RungeKut/thermocirculator/docs/01-overview.md

# 01. Обзор проекта

Актуально на 16.09.2026.

## Назначение

Термоциркулятор — прибор для длительного поддержания заданной температуры
водяной ванны с точностью, достаточной для лабораторного термостатирования и
приготовления по технологии sous-vide.

Функции:

- нагрев ТЭНом с ПИД-регулированием и программным ШИМ;
- принудительная циркуляция воды (мотор постоянного тока + мотор переменного тока);
- измерение температуры тремя NTC-термисторами (два в ванне, один на радиаторе);
- контроль уровня воды двумя поплавковыми датчиками с аварийным остановом;
- 16 сохраняемых программ «температура + время» в энергонезависимой памяти;
- интерфейс: LCD1602 с кириллицей, 5 кнопок, звуковая сигнализация, светодиод.

## Три целевых микроконтроллера

Проект ведётся одновременно под три чипа. Это не дублирование, а следствие
истории поставок — см. ниже.

| Таргет | Папка | Ядро | Библиотека | Состояние |
|---|---|---|---|---|
| STM32L072CBT6 | [`STM32L072CBT6/`](../STM32L072CBT6/) | Cortex-M0+ | STM32Cube HAL | **Эталон.** Логика полностью работает |
| STM32L071CBT6 | [`STM32L071CBT6/`](../STM32L071CBT6/) | Cortex-M0+ | STM32Cube HAL | Конфигурация восстановлена, собирается; проверка на железе не проводилась |
| GD32E103C8T6 | [`keil/`](../keil/) | Cortex-M3 | GigaDevice SPL | Ранняя стадия: поднята периферия, прикладной код отключён |

### Почему три

1. **STM32L072CBT6** — чип, на котором прибор был разработан и доведён до
   рабочего состояния. Остаётся эталоном поведения: при любых сомнениях
   «как должно работать» ответ ищется здесь.

2. **GD32E103C8T6** — попытка уйти от дефицита STM32 и одновременно резко
   снизить себестоимость изделия: эти чипы существенно дешевле. Порт делался
   в условиях скудной документации и оказался долгим. **Это не запасной
   вариант, а целевой чип для серийного изделия** — порт должен быть доведён
   до конца.

3. **STM32L071CBT6** — промежуточное решение, принятое когда чип появился в
   наличии. Архитектурно это тот же Cortex-M0+ и тот же HAL, что у L072.

**Три порта — не следствие разброда, а замысел.** Плата разрабатывалась под
pin-to-pin совместимые микроконтроллеры в LQFP48, и все три проверены пайкой
на неё. Исходники плат — в [`../hardware/`](../hardware/).

### Насколько таргеты различаются на самом деле

**L071 и L072 почти идентичны.** Набор драйверов HAL в
`Drivers/STM32L0xx_HAL_Driver/Src` у них совпадает побайтно. Папки `User/` и
`LCD1602/` тоже идентичны — и так и должно быть, это переносимый код.
Различие сводится к дефайну `STM32L071xx` вместо `STM32L072xx` и стартовому
файлу. L071 не имеет USB и аппаратного AES, но проект их не использует.

**GD32E103 — настоящий порт.** Cortex-M3 вместо M0+, тактовая до 72 МГц
вместо 32 МГц, собственная библиотека периферии вместо HAL, другая
организация АЦП (нет регистра `CHSELR`, вместо него регулярная и вставленная
группы), другая работа с флеш-памятью (страница 1 КБ вместо 128 байт) и
всего 64 КБ флеша против 128 КБ.

### Размер прошивки

| Таргет | ROM (Code + RO + RW) | Доступно | Запас |
|---|---|---|---|
| STM32L072CBT6 | 27.14 КБ | 128 КБ | ~79 % |
| STM32L071CBT6 | 27.01 КБ | 128 КБ | ~79 % |
| GD32E103C8T6 | 7.77 КБ (неполная) | 64 КБ | — |

Полная прошивка уверенно помещается в 64 КБ GD32E103C8T6.

## Текущее состояние работ

### Что работает

- Прошивка L072 — полнофункциональна, последняя успешная сборка 02.03.2025.
- Прошивка L071 — конфигурация периферии восстановлена 17.09.2026,
  собирается без ошибок (27 656 байт). **На железе не проверялась.**
- GD32: тактирование, GPIO, RTC на внешнем кварце 32.768 кГц, таймер в режиме
  ШИМ, собственная реализация `HAL_Delay`/`HAL_GetTick` поверх SysTick.

### Что сломано

1. ~~**Окружение сборки.**~~ Устранено 17.09.2026: компилятор, пакеты
   поддержки устройств, Java и CubeMX установлены. Оба ST-проекта
   собираются и дают эталонные размеры — [03-environment.md](03-environment.md).

2. ~~**L071 не измеряет температуру.**~~ Потерянная конфигурация АЦП, RTC и
   GPIO возвращена в `.ioc` и перегенерирована 17.09.2026 — П-02 в
   [07-troubleshooting.md](07-troubleshooting.md). Осталось **подтвердить на
   приборе**: температура должна перестать показывать ноль.

3. **GD32: прикладной код отключён.** Модули `user_interface.c`,
   `temperature_measurement.c`, `heater_control.c` и драйвер `LCD1602.c`
   закомментированы целиком. Не портированы: LCD, работа с флешем,
   измерение температуры, ПИД, звук.

## План работ

Порядок выбран так, чтобы не делать работу дважды.

1. ~~**Восстановить окружение**~~ — выполнено 17.09.2026.
2. **Оживить L071** — конфигурация возвращена; ждёт проверки на приборе.
3. **Выделить общую кодовую базу** `app/` + `port/` на эталонном L072.
   Обоснование — [adr/0002-shared-codebase.md](adr/0002-shared-codebase.md).
4. **Внести новое ТЗ** один раз в `app/` — получить сразу две прошивки.
   Состав работ — [09-requirements.md](09-requirements.md), архитектура
   интерфейса — [adr/0003-ui-architecture.md](adr/0003-ui-architecture.md).
5. **Доделать GD32** против уже стабилизированного `app/`.

Ключевое: шаг 3 идёт **до** шага 5. Если сначала доделать GD32 «как есть», а
потом выделять абстракцию, вся работа по GD32 будет переделана.

## Внешние ссылки

- Репозиторий: https://github.com/RungeKut/thermocirculator
- Документация на GD32: https://www.gd32mcu.com/
