RungeKut/thermocirculator/docs/README.md

# Документация проекта «Термоциркулятор»

Прибор для термостатирования водяной ванны: поддержание заданной температуры
ТЭНом с ПИД-регулированием, принудительная циркуляция, контроль уровня воды,
управление с LCD1602 и пятикнопочной клавиатуры.

Прошивка существует для **трёх микроконтроллеров** — см. [01-overview.md](01-overview.md).

## С чего начать

| Ваша задача | Документ |
|---|---|
| Понять, что это за прибор и в каком состоянии проект | [01-overview.md](01-overview.md) |
| Разобраться в схемотехнике и распиновке | [02-hardware.md](02-hardware.md) |
| Открыть схему, разводку, заказать платы | [../hardware/README.md](../hardware/README.md) |
| **Развернуть рабочее окружение с нуля** | [03-environment.md](03-environment.md) |
| Собрать и прошить | [04-build-and-flash.md](04-build-and-flash.md) |
| Понять логику прошивки | [05-firmware.md](05-firmware.md) |
| Портировать на новый МК | [06-porting.md](06-porting.md) |
| Что-то не работает | [07-troubleshooting.md](07-troubleshooting.md) |
| **Правила работы над проектом** | [08-rules.md](08-rules.md) |
| **Что предстоит сделать (новое ТЗ)** | [09-requirements.md](09-requirements.md) |

Принятые архитектурные решения и их обоснование — в [adr/](adr/).

Офлайн-комплект для развёртывания окружения — в [../tools/](../tools/).

## Статус документации

Документация описывает состояние проекта на **16.09.2026**. Актуальность
отдельных разделов помечена в каждом файле.

> **Важно:** документация — часть определения «готово». Изменение, не отражённое
> в документации, считается незавершённым. См. [08-rules.md](08-rules.md).
