RungeKut/thermocirculator/docs/02-hardware.md

# 02. Аппаратная часть

Актуально на 17.09.2026. Распиновка одинакова для всех трёх таргетов —
это осознанное решение, позволяющее держать общий прикладной код.

**Исходники плат — в [`../hardware/`](../hardware/).** Там же схема в PDF,
список доработок реальной платы относительно схемы и разбор узла обратной
связи источника питания. Прибор собран из двух плат, соединённых шлейфом:
системы управления и панели управления.

> **Плата рассчитана на три процессора.** Она разрабатывалась под
> pin-to-pin совместимые микроконтроллеры в LQFP48, и все три —
> GD32E103C8T6, STM32L072CBT6, STM32L071CBT6 — проверены пайкой на неё.
> В перечне элементов стоит GD32E103C8T6. Это и есть причина, по которой
> прошивка ведётся в трёх портах.

## Распиновка

Источник истины — `Core/Inc/main.h` соответствующего таргета. Таблица ниже
сверена с L072, L071 и GD32 — совпадает для всех трёх.

### Аналоговые входы (АЦП)

| Пин | Сигнал | Назначение |
|---|---|---|
| PA0 | `SENSE_TEMP_2` | NTC-термистор в ванне № 2 (разъём X7) |
| PA1 | `SENSE_TEMP_1` | NTC-термистор в ванне № 1 (разъём X8) |
| PA2 | `SENSE_TEMP_RADIATOR` | NTC-термистор радиатора |
| — | внутренний | Датчик температуры кристалла |
| — | внутренний | Опорное напряжение `VREFINT` |

> Внутренние каналы обязательны: `VREFINT` служит делителем при пересчёте
> всех остальных температур. Без него все измерения обращаются в ноль —
> именно так была сломана конфигурация L071 (устранено 17.09.2026, П-02).

### Дискретные входы

| Пин | Сигнал | Режим | Бит в `keys` / `levels` |
|---|---|---|---|
| PA3 | `WATER_LEVEL_HIGH` | вход | `levels` бит 1 (0x02) |
| PC13 | `WATER_LEVEL_LOW` | вход | `levels` бит 0 (0x01) |
| PA4 | `START_BUTTON` | вход | `keys` 0x02 |
| PA5 | `STOP_BUTTON` | вход | `keys` 0x04 |
| PA6 | `MENU_BUTTON` | вход | `keys` 0x08 |
| PA7 | `LEFT_BUTTON` | вход | `keys` 0x10 |
| PB0 | `RIGHT_BUTTON` | вход | `keys` 0x01 |

Состояние читается пачкой прямо из регистров:

```c
uint8_t GetKey(void){
    return ((GPIOA->IDR & 0x00F0) >> 3) + (GPIOB->IDR & 0x0001);
}
uint8_t GetLevel(void){
    return ((GPIOA->IDR & 0x0008) >> 2) + ((GPIOC->IDR & 0x2000) >> 13);
}
```

> **Расхождение Stop / Left — решено 17.09.2026: авторитетны имена пинов.**
> `main.h` верен: PA5 — это Stop, PA7 — это Left. Врут **комментарии** в
> обработчиках `ButtonClickExecuter()` и `ButtonClickHandler()`, где `0x04`
> подписан как Left, а `0x10` как Stop.
>
> Следствие, которое нужно проверить на приборе: раз `0x04` приходит с PA5
> (Stop), то нажатие Stop сейчас выполняет ветку уменьшения значения, а
> нажатие Left (`0x10`) — ветку останова. То есть **в текущей прошивке эти
> две кнопки функционально переставлены** относительно своих имён.
>
> Если на живом приборе Stop останавливает, а Left листает — значит
> физическая разводка кнопок на панели не совпадает с именами в `main.h`,
> и тогда переименовать нужно дефайны, а не править логику. **Проверить до
> переработки интерфейса:** после неё поведение будет следовать именам.

### Дискретные выходы

| Пин | Сигнал | Нагрузка |
|---|---|---|
| PB2 | `HEATER` | ТЭН (через силовой ключ), программный ШИМ |
| PB1 | `AC_MOTOR` | Мотор переменного тока (циркуляция) |
| PA9 | `DC_MOTOR` | Мотор постоянного тока (циркуляция) |
| PA8 | `COOLER` | Вентилятор радиатора |
| PB11 | `LED_R` | Индикатор «Капля» (авария по уровню воды) |
| PA10 | `BACKLIGHT` | Подсветка дисплея |
| PA15 | `SPEAKER` | Пьезоизлучатель PS1740P02E, ШИМ от таймера (см. ниже) |

### Пьезоизлучатель PS1740P02E

TDK, серия PS, внешнего возбуждения, диаметр 17 мм.
**Резонансная частота 4.0 кГц** — на неё указывает обозначение «1740».

Ключевое для программной части: пьезоэлемент эффективен вблизи резонанса, а
ниже него отдача падает круто. Из этого следует три вещи:

1. Ноты ниже **~500 Гц** излучатель практически не воспроизводит. Именно
   поэтому настройки таймера ограничивают диапазон снизу: `32000000/f`
   в 16-битном регистре перестаёт работать ниже 488 Гц, и это совпадает с
   физической границей излучателя. Ограничение **сознательное**.
2. Текущие сигналы (523…1865 Гц) лежат далеко ниже резонанса, то есть в
   самой неэффективной области. Перенос их вверх, ближе к 4 кГц, даёт
   значительный прирост громкости без изменения схемы — см. Ф-11.1 в
   [09-requirements.md](09-requirements.md).
3. Громкость регулируется только **скважностью** ШИМ: элемент ёмкостный,
   при коротких импульсах не успевает зарядиться, и размах напряжения на нём
   падает. Амплитудная регулировка потребовала бы изменения платы.

> Точная АЧХ берётся из даташита либо, что надёжнее, измеряется **в готовом
> корпусе**: корпус с выходным отверстием образует резонатор Гельмгольца,
> который смещает итоговую характеристику относительно паспортной.
> Даташит подлежит добавлению в [`../tools/datasheets/`](../tools/datasheets/).

### Дисплей 8×2, знакосинтезирующий (4-битный параллельный режим)

**Геометрия: 8 знакомест, 2 строки (тип 0802)** — подтверждено 17.09.2026.
Драйвер исторически называется `LCD1602`, но адресация строк у HD44780
(0x00 и 0x40) одинакова для 0802 и 1602, а видимая ширина задана
константой `StrLength 8` в `user_interface.c`.

Восемь знакомест — определяющее ограничение интерфейса; правила компоновки
в [adr/0003-ui-architecture.md](adr/0003-ui-architecture.md).

| Пин | Сигнал |
|---|---|
| PB14 | `DISP_RS` |
| PA12 | `DISP_RW` |
| PA11 | `DISP_E` |
| PB10 | `DISP_DB2` |
| PB3 | `DISP_DB3` |
| PB4 | `DISP_DB4` |
| PB5 | `DISP_DB5` |
| PB9 | `DISP_DB6` |
| PB8 | `DISP_DB7` |

Драйвер — `LCD1602/LCD1602.c` (автор Konstantin Golinskiy), с таблицей
кириллических символов `LCD1602_Font_Cyrillic.c`. Драйвер обращается к GPIO
напрямую через регистр `BSRR`, что и требует отдельного шима при портировании
на GD32 (см. [06-porting.md](06-porting.md)).

### Конфликт распиновки в GD32

`TIM1_Init()` в [`keil/Core/Src/tim.c`](../keil/Core/Src/tim.c) переводит в
режим альтернативной функции пины **PA15, PB3, PB10, PB11** — то есть
`SPEAKER`, `DISP_DB3`, `DISP_DB2` и `LED_R`. Для отладки ШИМ это допустимо,
но при подключении дисплея сломает вывод. Подлежит исправлению при
портировании.

## Измерение температуры

### Схема включения термистора

Делитель напряжения: термистор и постоянный резистор `RA` последовательно
между `U0` и землёй, средняя точка — на вход АЦП (схема A из
[статьи по NTC](../Характеристики%20NTC%20термисторов/README.md)).

Параметры, использованные при расчёте таблицы:

- термистор: 10 кОм при 25 °C, характеристика EPCOS R/T 8016, B25/100 = 3988 K
  (даташит: [`../tools/datasheets/B57500K0103A001.pdf`](../tools/datasheets/B57500K0103A001.pdf));
- `RA` = 10 кОм (подтверждено по схеме 17.09.2026);
- `U0` = `Uref` = 3.3 В.

Номинал `RA` выбран близким к сопротивлению термистора в рабочем диапазоне —
это линеаризует характеристику и повышает точность интерполяции. Мощность на
термисторе не должна превышать 1 мВт, иначе он греет сам себя и искажает
показания.

### Пересчёт кода АЦП в температуру

Прямой расчёт по формуле Стейнхарта — Харта слишком дорог для Cortex-M0+.
Вместо него используется таблица с двоичным поиском и линейной интерполяцией
между точками — `termo_table[]` в `temperature_measurement.c`:

- 41 точка, шаг 2 °C;
- диапазон 20.0 … 100.0 °C (значения в десятых долях градуса);
- выход за пределы: ниже — `TEMPERATURE_UNDER` (200), выше — `TEMPERATURE_OVER` (1000).

Код АЦП выше **4080** трактуется как обрыв датчика: прибор переходит в
аварийное состояние и выводит, какой именно датчик оборван (X7, X8 или
радиатора).

Рабочая температура берётся как **максимум** из двух датчиков в ванне —
консервативный выбор, защищающий от перегрева при частично погружённом
датчике.

### Внутренний датчик температуры

Формулы различаются между семействами и при переносе кода их легко перепутать:

| Таргет | `V25` | Крутизна | Формула |
|---|---|---|---|
| STM32L0 | 1.41 В | 4.3 мВ/°C | `(V25 - 1.2*sense[3]/sense[4]) / 4.3 + 25` |
| GD32E10x | 0.76 В | 2.5 мВ/°C | `(U - 0.76) / 0.0025 + 25` |

## Документация на компоненты

Даташиты лежат в [`../tools/datasheets/`](../tools/datasheets/), перечень и
контрольные суммы — в [`../tools/manifest.json`](../tools/manifest.json).

| Файл | Что |
|---|---|
| `GD32E103xx_Datasheet_Rev1.14.pdf` | Даташит GD32E103 |
| `GD32E10x_User_Manual_Rev1.7.pdf` | Описание периферии GD32E10x (основной источник при портировании) |
| `stm32l072cz.pdf` | Даташит STM32L072 |
| `B57500K0103A001.pdf` | Даташит NTC-термистора EPCOS |
| `PS1740P02E.pdf` | Даташит пьезоизлучателя TDK — **отсутствует**, нужна АЧХ для Ф-11.1 |
