RungeKut/thermocirculator/docs/adr/0001-toolchain.md

# ADR-0001. Выбор тулчейна

- **Дата:** 16.09.2026
- **Статус:** предложено, решение за владельцем проекта
- **Контекст:** [03-environment.md](../03-environment.md)

## Проблема

Проекты собирались Arm Compiler 5.06u7, которого больше нет в установленной
MDK 5.39. Нужно решить, чем собирать дальше. Решение затрагивает все три
таргета и влияет на возможность офлайн-развёртывания и на лицензионные
ограничения по размеру прошивки.

## Варианты

### A. Вернуть Arm Compiler 5

Доустановить AC5 поверх MDK 5.39.

**За:**
- бит-в-бит воспроизводит заведомо рабочие сборки (L072 от 02.03.2025);
- нулевые изменения в коде — риск регресса отсутствует;
- быстрее всего: одна установка.

**Против:**
- AC5 снят с поддержки, распространяется как legacy и требует учётной записи Arm;
- тупиковая ветка: рано или поздно переходить всё равно придётся.

### B. Перевести проекты на ArmClang 6.21

Переключить таргеты на уже установленный AC6.

**За:**
- ничего доустанавливать не нужно, компилятор уже на машине;
- поддерживаемый компилятор, лучше диагностика и оптимизация.

**Против:**
- на старом коде почти наверняка всплывут предупреждения и, возможно,
  отличия в поведении;
- стартовые файлы `startup_*.s` написаны в синтаксисе armasm и могут
  потребовать правок;
- смешивать это с оживлением L071 нельзя — иначе будет непонятно, что
  сломалось: код или компилятор.

### C. Перейти на arm-none-eabi-gcc + CMake

Отказаться от Keil как от системы сборки, оставив его при желании как отладчик.

**За:**
- **полностью офлайн и бесплатно**: один архив тулчейна, без лицензий и
  привязки к машине — прямо отвечает требованию воспроизводимого офлайн-окружения;
- **нет лимита 32 КБ**, который иначе упрётся в новое ТЗ;
- один и тот же тулчейн для всех трёх таргетов, включая GD32 — обе платформы
  это просто Cortex-M;
- сборка скриптуется и проверяется в CI; три таргета собираются одной командой;
- снимает зависимость от версий DFP при сборке (пакеты остаются нужны только
  для отладки).

**Против:**
- самый объёмный разовый переход: линкер-скрипты, стартовые файлы,
  сборочные файлы для трёх таргетов;
- для GD32 придётся вендорить SPL руками — сейчас он подключён через
  механизм RTE, которого вне Keil нет;
- меняется привычный процесс отладки.

## Рекомендация

**Сейчас — вариант A, целевой — вариант C.**

Обоснование: ближайшая задача — оживить L071, и делать её нужно на заведомо
работающем компиляторе, чтобы любой сбой однозначно указывал на
конфигурацию периферии, а не на тулчейн. Менять компилятор одновременно с
восстановлением конфигурации означает получить два источника ошибок сразу.

Переход на GCC логично делать **вместе с выделением `app/` + `port/`**
(см. [ADR-0002](0002-shared-codebase.md)): к этому моменту структура проекта
всё равно перестраивается, а требования офлайн-воспроизводимости и снятия
лимита 32 КБ к тому времени станут критичными.

Вариант B отдельного смысла не имеет: если всё равно менять компилятор,
рациональнее сразу идти в C и получить вместе с этим офлайн-сборку и CI.

## Последствия

- В офлайн-комплект добавляется установщик AC5 (шаг 2 в [03-environment.md](../03-environment.md)).
- Настройка компилятора фиксируется в `.uvprojx` и не меняется произвольно —
  см. правила в [08-rules.md](../08-rules.md).
- При переходе на C эталоном приёмки остаётся размер прошивки L072: он
  изменится (другой компилятор), поэтому эталон фиксируется заново
  функциональной проверкой на железе, а не сравнением байтов.
