RungeKut/thermocirculator/hardware/Вопросы - пожелания.docx

Вопрос 1

Что подразумевается под технологической картой?

Тех процесс сборки, монтажа, наладки? Или что то иное?

Я конечно не технолог.. Думаю да ты прав, именно процесс сборки, последовательность выполнения операций их их оптимальный порядок следования. Так же скорее всег туда записываются еще все сопутствующие настройки используемых в процессе наладки и монтажа приборов. Например температура паяльника, марка припоя.. И они еще там состоят из множества маршрутных карт или это отдельно.. С процессом производства на бумаге я мало дела имел, только участвовал в наладке автоматических линий. Короче это шаги которые строго должен выполнять рабочий.

Можно в пример привести ТК для производства тортов. В ней ты четко пишешь какие нужны ингредиенты и их характеристики. Описываешь процесс приготовления, вплоть до

температуры масла на сковороде… процесс затвердевания, упаковки, доставки

ВОПРОС РЕШЕН.

ПОЖЕЛАНИЕ К ПЛАТЕ УПРАВЛЕНИЯ.

на плате должен быть установлен преобразователь 220ас в на 12dc 1.3 a

Ответ 28.01.23 19:20

Предлагаю тогда сделать симбиоз. На плате место вроде бы есть. Сделаем возможность питания от трансформатора и так же заложим импульсный БП. Я разрабатывал только dc/dc. Принцип тот-же, только в ac/dc нужно обеспечить гальваническую изоляцию. Посмотрю тогда еще контроллеры ac/dc.. Не на древней же tl494 без всяких защит делать..

Ок. Желаю удачи.

Стало немного понятней – как быстро движется дело. Обычно на схему 2-3 недели чистого времени уходит на такую как тут, вместе с макетом. Но т.к. макет особо нет возможности делать приходится больше думать. Поставлю себе оптимистичную цель к концу марта определиться со всеми компонентами и заказать. И начнем плату трассировать.

Вопрос 15.03.23 10:20

Можно по-подробнее узнать о индикаторе «Капля». Я догадываюсь что он говорит о уровне воды, но датчик уровня у нас с тремя положениями низкий/нормальный/высокий.. Соответственно какая должна быть логика его работы? Должен быть просто красный светодиод или RGB?

Ответ:

Красный диод 2 положения низкий и высокий

Вопрос 15.03.23 10:27

Сколько светодиодный индикаторов планируется на панели? Только один Капля?

Ответ:

Только капля

Вопрос 15.03.23 10:28

Наклейка на переднюю панель уже изготовлена или есть файл кореловский? Мне нужны размеры. Расстояния м/у кнопками и до дисплея. Размер самих кнопок. Можно суда просто файл кореловский бросить – я найду.

Ответ.

Закинул в папку 3Д корловский

Вопрос 15.03.23 10:30

На счет реле для разных модификаций мотора. Я пришел к выводу что дешевле и логичнее вместо реле поставить просто еще один разъем. И в зависимости от типа мотора подключать его в соответствующий разъем, при этом нет необходимости устанавливать перемычки т.к. управление мотором может осуществляться параллельно обоими выходами.\

Ответ:

Поддерживаю
