RungeKut/thermocirculator/hardware/Предложение по децимальным номерам изделий.docx

Предложение по децимальным номерам вновь разрабатываемых узлов и изделий.

СТЖ–1.ПУ.01.00.001

^ ^ ^ ^ ^ ^

1 –2.3 . 4 5 6

1. Шифр проекта не более 5 символов
  1.1. СТЖ – Устройство стабилизации температуры жидкости серии «ТопТерм»
2. Поколение проекта ..? (при необходимости)
3. Тип записей в соответствии с Журналом:
  3.1. ПР – проект (головная сборка)
  3.2. НК – наклейка
  3.3. СЕ – сборочная единица
  3.4. ТК – технологическая карта
  3.5. ПО – программное обеспечение
  3.6. ПП – печатная плата
  3.7. МД – механическая деталь
  3.8. ЭУ – электронный узел
  3.9. ПУ – печатный узел
  3.10. 3DС – 3D модель – сборки
  3.11. 3DД – 3D модель – деталь
  3.12. ЭСИ – Электронная структура изделия

Возможно добавление других типов записей при необходимости

4. Узел комплектации (пульт, доп.ручки и т.д)
5. Подсборка (для небольших узлов/проектов допускается не заполнять – оставить 00)
6. Порядковый номер в подсборке
