RungeKut/thermocirculator/hardware/3DC-/Описание.docx

Данная модель не является оконченной версией.

Это только грубая прикидка
