RungeKut/thermocirculator/hardware/3DC-/Безымянный-1.png

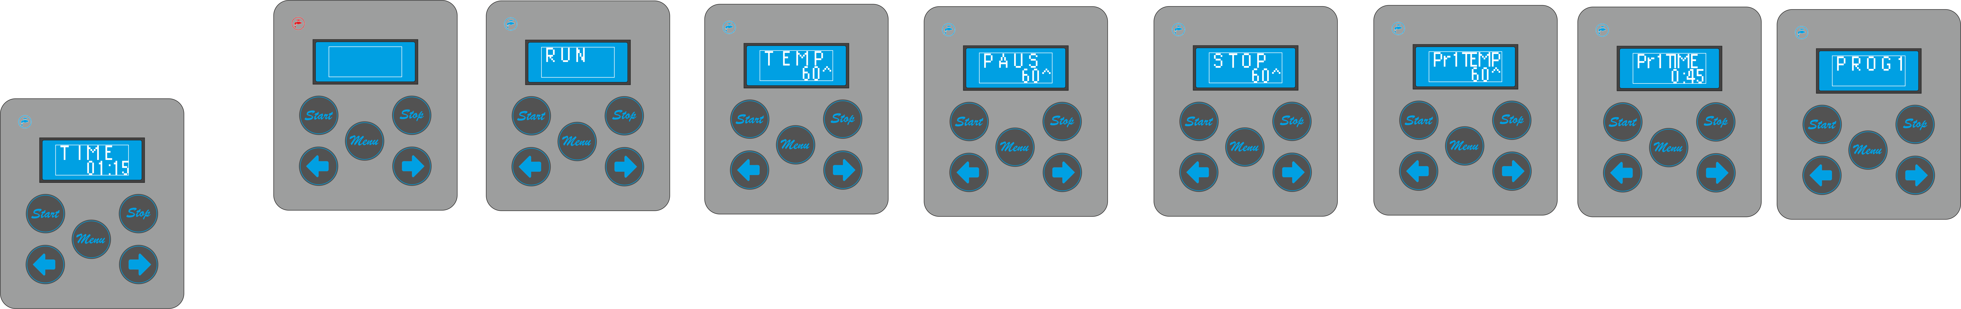
hardware/3DC-/Безымянный-1.png
