RungeKut/thermocirculator/hardware/3DC-/Безымянный-11.png

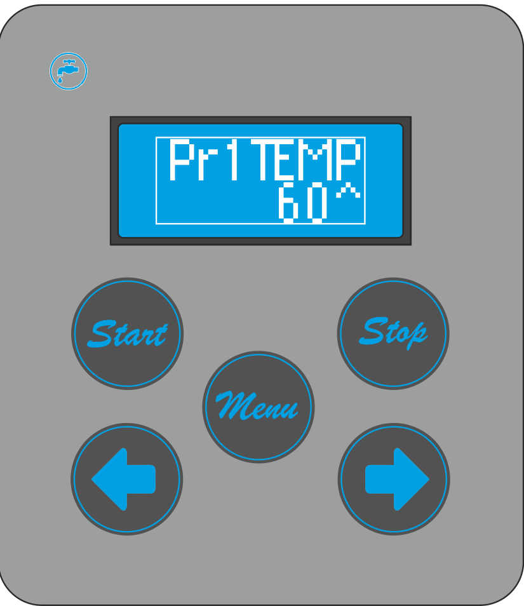
hardware/3DC-/Безымянный-11.png
