RungeKut/thermocirculator/hardware/Datasheet-/HTB1BfYqGFXXXXaGXFXXq6xXFXXXV.jpg

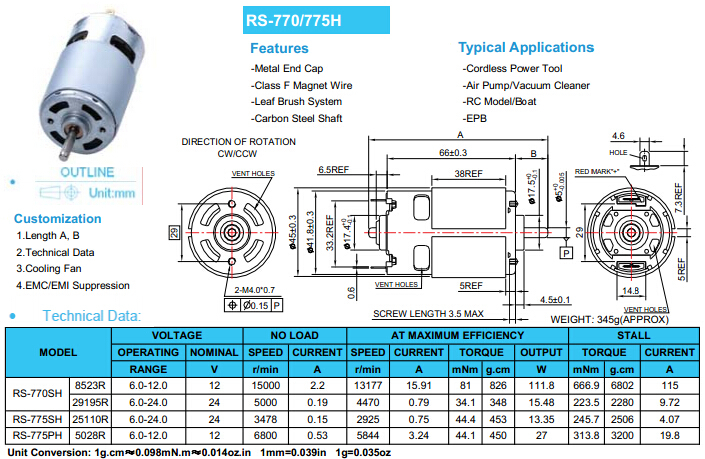
hardware/Datasheet-/HTB1BfYqGFXXXXaGXFXXq6xXFXXXV.jpg
