RungeKut/thermocirculator/STM32L072CBT6/Новая папка/_Измерение температуры при помощи NTC термистора и микроконтроллера AVR_files/cc56-12gwa.png

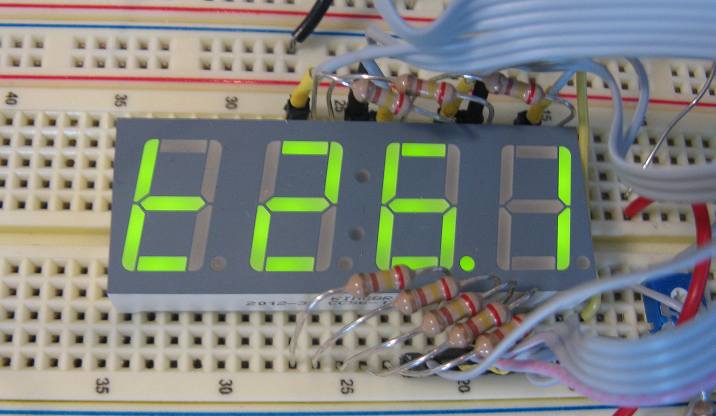
STM32L072CBT6/Новая папка/_Измерение температуры при помощи NTC термистора и микроконтроллера AVR_files/cc56-12gwa.png
