RungeKut/thermocirculator/hardware/База децимальных номеров.xlsx

id | Децимальный № | Наименование | Кем занят | Дата | Принадлежность проекту
1 | СТЖ-1.ПР | Устройство стабилизации температуры жидкости серии «ТопТерм» | Большаков С.П. | 2023-01-21
2 | СТЖ-1.ПУ.01.00.001 | Плата системы управления | Большаков С.П. | 2023-01-21 | СТЖ-1.ПР
3 | СТЖ-1.ПУ.02.00.001 | Плата панели управления | Большаков С.П. | 2023-01-21 | СТЖ-1.ПР
4 | СТЖ-1.3DC | Сборочная модель 3D | Козуто С.А. | 2023-01-21 | СТЖ-1.ПР
5 | СТЖ-1.НК.01.00.001 | Лицевая панель | Козуто С.А. | 2023-01-21 | СТЖ-1.ПР
