RungeKut/thermocirculator/hardware/СТЖ-1.ЭСИ.xlsm

Sheet: Main
 |  |  |  |  |  | Кнопка чтобы пересчитать общее количество одинаковых компонентов |  |  |  |  |  |  |  |  |  |  |  |  |  | Голубой - что обновлено Желтый - что добавить Красный - что не верно Зеленый - рассчетное значение
1 | 2 | 3 | 4 | 5 | 6 | 7 | 8 | 9 | 10 | 11 | 12 | 13 | 14 | 15 | 16 | 17 | 18 | 19 | 20 - уровень вложения | 132 | штуки/килограммы/литры/метры
Наименование [Синий - последние изменения] |  |  |  |  |  |  |  |  |  |  |  |  |  |  |  |  |  |  |  | Обозначение | Кол-во | Ед. | Производитель | Ссылка | Комплектация ТУ | ЦЕНА за шт. | Стоймость | Примечание
Компоненты Проекта Устройства Стабилизации Температуры Жидкости |  |  |  |  |  |  |  |  |  |  |  |  |  |  |  |  |  |  |  | СТЖ-1.ПР |  |  |  |  |  |  | 11862.10 ₽
├ | Печатная плата Система управления (Печатный узел) |  |  |  |  |  |  |  |  |  |  |  |  |  |  |  |  |  |  | СТЖ-1.ПУ.01.00.001 | 1 | шт |  |  |  |  | 11862.10 ₽
├ | ├ | Текстолит |  |  |  |  |  |  |  |  |  |  |  |  |  |  |  |  |  | СТЖ-1.ПП.01.00.001 | 1 | шт | Резонит | https://www.rezonit.ru/pcb/odnostoronnie-i-dvustoronnie/ |  | 1750.00 ₽ | 1750.00 ₽
├ | ├ | Cетевой шнур ПВС-ВП 3х2,5 с угловой вилкой S22 2,5метра |  |  |  |  |  |  |  |  |  |  |  |  |  |  |  |  |  |  | 1 | шт | Elman | http://elman.su/production/cords/ |  | 600.00 ₽ | 600.00 ₽
├ | ├ | Ввод кабельный спиральный |  |  |  |  |  |  |  |  |  |  |  |  |  |  |  |  |  | PG-R-7 | 1 | шт |  | https://www.chipdip.ru/product/pg-r-7 |  | 53.00 ₽ | 53.00 ₽ | аналог https://www.elitan.ru/price/item558361
├ | ├ | Контроллер источника питания |  |  |  |  |  |  |  |  |  |  |  |  |  |  |  |  |  | TEA1733T | 1 | шт | NXP | https://www.chipdip.ru/product/tea1530at?from=suggest_product |  | 76.00 ₽ | 76.00 ₽
├ | ├ | Радиатор |  |  |  |  |  |  |  |  |  |  |  |  |  |  |  |  |  | ABM-001-50 |  |  |  | https://www.chipdip.ru/product0/8258530924
├ | ├ | Микроконтроллер |  |  |  |  |  |  |  |  |  |  |  |  |  |  |  |  |  | GD32E103C8T6 | 1 | шт | GigaDevice | https://www.chipdip.ru/product/gd32e103c8t6-gigadevice |  | 170.00 ₽ | 170.00 ₽
├ | ├ | Конденсатор К73-17, JFA02G104J 0.01мкФ 400 В 5% |  |  |  |  |  |  |  |  |  |  |  |  |  |  |  |  |  | К73-17 0.1мкФ, 400В, 5%, JFA02G104J | 2 |  |  |  |  | 16.00 ₽ | 32.00 ₽
├ | ├ | Конденсатор 1206 10% 50В 4.7мкФ X7R |  |  |  |  |  |  |  |  |  |  |  |  |  |  |  |  |  | CC1206KKX7R9BB475 | 3 |  |  |  |  | 7.00 ₽ | 21.00 ₽
├ | ├ | Конденсатор 0805 10% 50В 100нФ X7R |  |  |  |  |  |  |  |  |  |  |  |  |  |  |  |  |  | GRM21BR71H104KA0 1L | 22 |  |  |  |  | 0.90 ₽ | 19.80 ₽
├ | ├ | Конденсатор Эл-лит. 20% 400В 100мкФ |  |  |  |  |  |  |  |  |  |  |  |  |  |  |  |  |  | JNE2G101M10002200 250 | 1 |  |  |  |  | 160.00 ₽ | 160.00 ₽
├ | ├ | Конденсатор 1206 10% 630В 2.2нФ X7R |  |  |  |  |  |  |  |  |  |  |  |  |  |  |  |  |  | GRM31BR72J222KW0 1L | 1 |  |  |  |  | 4.00 ₽ | 4.00 ₽
├ | ├ | Конденсатор 1206 10% 630В 4.7нФ X7R |  |  |  |  |  |  |  |  |  |  |  |  |  |  |  |  |  | GRM31BR72J472KW0 1L | 1 |  |  |  |  | 74.00 ₽ | 74.00 ₽
├ | ├ | Конденсатор 0805 10% 16В 470нФ X7R |  |  |  |  |  |  |  |  |  |  |  |  |  |  |  |  |  | GRM219R71C474K | 1 |  |  |  |  | 6.00 ₽ | 6.00 ₽
├ | ├ | Конденсатор 0805 10% 25В 220нФ X7R |  |  |  |  |  |  |  |  |  |  |  |  |  |  |  |  |  | GRM219R71E224K | 2 |  |  |  |  | 11.00 ₽ | 22.00 ₽
├ | ├ | Конденсатор 0805 10% 100В 10нФ X7R |  |  |  |  |  |  |  |  |  |  |  |  |  |  |  |  |  | GRM21BR72A103KA0 1L | 3 |  |  |  |  | 4.00 ₽ | 12.00 ₽
├ | ├ | Конденсатор Эл-лит. 20% 16В 680мкФ |  |  |  |  |  |  |  |  |  |  |  |  |  |  |  |  |  | JRC1C681M035008001 60000B | 2 |  |  |  |  | 13.00 ₽ | 26.00 ₽
├ | ├ | Конденсатор 0805 10% 250В 22пФC0G |  |  |  |  |  |  |  |  |  |  |  |  |  |  |  |  |  | GRM21A5C2E220J | 1 |  |  |  |  | 15.00 ₽ | 15.00 ₽
├ | ├ | Конденсатор X1/Y1 20% 250В 4,7нФ |  |  |  |  |  |  |  |  |  |  |  |  |  |  |  |  |  | DE1E3KX472MN4AN0 1F | 2 |  |  |  |  | 33.00 ₽ | 66.00 ₽
├ | ├ | Конденсатор X1/Y1 20% 250В 1нФ |  |  |  |  |  |  |  |  |  |  |  |  |  |  |  |  |  | DE1E3KX102MA4BN0 1F | 2 |  |  |  |  | 24.00 ₽ | 48.00 ₽
├ | ├ | Конденсатор X2 Пропилен 10% 305В 100нФ |  |  |  |  |  |  |  |  |  |  |  |  |  |  |  |  |  | B32922C3104K000 | 2 |  |  |  |  | 43.00 ₽ | 86.00 ₽
├ | ├ | Конденсатор 0805 10% 50В 1мкФ X7R |  |  |  |  |  |  |  |  |  |  |  |  |  |  |  |  |  | GRM21BR71H105KA1 2L | 2 |  |  |  |  | 20.00 ₽ | 40.00 ₽
├ | ├ | Конденсатор 0805 10% 100В 22нФ X7R |  |  |  |  |  |  |  |  |  |  |  |  |  |  |  |  |  | GRM21BR72A223KA0 1L | 1 |  |  |  |  | 4.00 ₽ | 4.00 ₽
├ | ├ | Конденсатор 0603 05% 50В 12пФNP0 |  |  |  |  |  |  |  |  |  |  |  |  |  |  |  |  |  | CC0603JRNPO9BN120 | 2 |  |  |  |  | 4.00 ₽ | 8.00 ₽
├ | ├ | Конденсатор 0805 05% 50В 20пФNP0 |  |  |  |  |  |  |  |  |  |  |  |  |  |  |  |  |  | CC0805JRNPO9BN200 | 2 |  |  |  |  | 4.00 ₽ | 8.00 ₽
├ | ├ | ИОН TL431ACDBZT, SOT-23_3 |  |  |  |  |  |  |  |  |  |  |  |  |  |  |  |  |  | TL431ACDBZT, SOT23_3 | 1 |  |  |  |  | 310.00 ₽ | 310.00 ₽
├ | ├ | Оптосимистор MOC3063, DIP6 zerocross |  |  |  |  |  |  |  |  |  |  |  |  |  |  |  |  |  | MOC3063 | 2 |  |  |  |  | 68.00 ₽ | 136.00 ₽
├ | ├ | Оптрон PC817, DIP-4 |  |  |  |  |  |  |  |  |  |  |  |  |  |  |  |  |  | LTV-356T | 1 |  |  |  |  | 99.00 ₽ | 99.00 ₽
├ | ├ | AC/DC TEA1733, SO8 |  |  |  |  |  |  |  |  |  |  |  |  |  |  |  |  |  | TEA1733 | 1 |  |  |  |  | 76.00 ₽ | 76.00 ₽
├ | ├ | Микроконтроллер |  |  |  |  |  |  |  |  |  |  |  |  |  |  |  |  |  | GD32E103C8T6 | 1 |  |  |  |  | 170.00 ₽ | 170.00 ₽
├ | ├ | Фильтр ЭМП 300В 1,6А 14мГн |  |  |  |  |  |  |  |  |  |  |  |  |  |  |  |  |  | PLY10AN1521R6R2 | 1 |  |  |  |  | 180.00 ₽ | 180.00 ₽
├ | ├ | Дроссель 10% 10uH 1,3A |  |  |  |  |  |  |  |  |  |  |  |  |  |  |  |  |  | CD54-100K | 1 |  |  |  |  | 45.00 ₽ | 45.00 ₽
├ | ├ | Кварцевый резонатор 32,768 кГц |  |  |  |  |  |  |  |  |  |  |  |  |  |  |  |  |  | DT-26 | 1 |  |  |  |  | 15.00 ₽ | 15.00 ₽
├ | ├ | Кварцевый резонатор 8MHz HC49 |  |  |  |  |  |  |  |  |  |  |  |  |  |  |  |  |  | L-KLS14-HC-49S-8.000- 20-30-A | 1 |  |  |  |  | 4.00 ₽ | 4.00 ₽
├ | ├ | Резистор 0805 5% 180Ом |  |  |  |  |  |  |  |  |  |  |  |  |  |  |  |  |  | RC0805JR-07180RL | 2 |  |  |  |  | 4.00 ₽ | 8.00 ₽
├ | ├ | Резистор 1206 5% 360Ом |  |  |  |  |  |  |  |  |  |  |  |  |  |  |  |  |  | RC1206JR-07360RL | 2 |  |  |  |  | 4.00 ₽ | 8.00 ₽
├ | ├ | Резистор 0805 5% 1,2 кОм |  |  |  |  |  |  |  |  |  |  |  |  |  |  |  |  |  | RC0805JR-071K2L | 4 |  |  |  |  | 5.00 ₽ | 20.00 ₽
├ | ├ | Резистор 1206 5% 150Ом |  |  |  |  |  |  |  |  |  |  |  |  |  |  |  |  |  | RC1206JR-07150RL | 4 |  |  |  |  | 5.00 ₽ | 20.00 ₽
├ | ├ | Резистор 1206 5% 330Ом |  |  |  |  |  |  |  |  |  |  |  |  |  |  |  |  |  | RC1206JR-07330RL | 2 |  |  |  |  | 19.00 ₽ | 38.00 ₽
├ | ├ | Резистор 0805 5% 1 кОм |  |  |  |  |  |  |  |  |  |  |  |  |  |  |  |  |  | RC0805JR-071KL | 1 |  |  |  |  | 4.00 ₽ | 4.00 ₽
├ | ├ | Резистор 0805 5% 4,7 Ом |  |  |  |  |  |  |  |  |  |  |  |  |  |  |  |  |  | RC0805JR-074R7L | 2 |  |  |  |  | 5.00 ₽ | 10.00 ₽
├ | ├ | Резистор 0805 5% 10 Ом |  |  |  |  |  |  |  |  |  |  |  |  |  |  |  |  |  | RC0805JR-0710RL | 2 |  |  |  |  | 12.00 ₽ | 24.00 ₽
├ | ├ | Резистор 0805 5% 33 кОм |  |  |  |  |  |  |  |  |  |  |  |  |  |  |  |  |  | RC0805JR-0733KL | 1 |  |  |  |  | 0.20 ₽ | 0.20 ₽
├ | ├ | Резистор 1206 5% 47 кОм |  |  |  |  |  |  |  |  |  |  |  |  |  |  |  |  |  | RC1206JR-0747КL | 2 |  |  |  |  | 6.00 ₽ | 12.00 ₽
├ | ├ | Резистор 1206 5% 3,3 МОм |  |  |  |  |  |  |  |  |  |  |  |  |  |  |  |  |  | RC1206JR-073M3L | 2 |  |  |  |  | 3.00 ₽ | 6.00 ₽
├ | ├ | Резистор 0805 5% 560 кОм |  |  |  |  |  |  |  |  |  |  |  |  |  |  |  |  |  | RC0805JR-07560KL | 1 |  |  |  |  | 5.00 ₽ | 5.00 ₽
├ | ├ | Резистор 1206 5% 3 МОм |  |  |  |  |  |  |  |  |  |  |  |  |  |  |  |  |  | RC1206JR-073ML | 1 |  |  |  |  | 0.30 ₽ | 0.30 ₽
├ | ├ | Резистор 0805 5% 82 кОм |  |  |  |  |  |  |  |  |  |  |  |  |  |  |  |  |  | RC0805JR-0782KL | 1 |  |  |  |  | 0.20 ₽ | 0.20 ₽
├ | ├ | Резистор 1206 1% 150мОм импульсный |  |  |  |  |  |  |  |  |  |  |  |  |  |  |  |  |  | ERJ8BSFR15V | 1 |  |  |  |  | 41.00 ₽ | 41.00 ₽
├ | ├ | Резистор 1206 1% 220Ом |  |  |  |  |  |  |  |  |  |  |  |  |  |  |  |  |  | RC1206FR-07220RL | 1 |  |  |  |  | 6.00 ₽ | 6.00 ₽
├ | ├ | Резистор 0805 5% 2,2 МОм |  |  |  |  |  |  |  |  |  |  |  |  |  |  |  |  |  | RC0805JR-072M2L | 1 |  |  |  |  | 0.20 ₽ | 0.20 ₽
├ | ├ | Резистор 1206 5% 100Ом |  |  |  |  |  |  |  |  |  |  |  |  |  |  |  |  |  | RC1206JR-07100RL | 1 |  |  |  |  | 5.00 ₽ | 5.00 ₽
├ | ├ | Резистор 0805 5% 150Ом |  |  |  |  |  |  |  |  |  |  |  |  |  |  |  |  |  | RC0805JR-07150KL | 1 |  |  |  |  | 5.00 ₽ | 5.00 ₽
├ | ├ | Резистор 0805 5% 5,1 кОм, Резистор 0805 1% 5,1 кОм |  |  |  |  |  |  |  |  |  |  |  |  |  |  |  |  |  | RC0805JR-075K1L, RC0805FR-075K1L | 2 |  |  |  |  | 5.00 ₽ | 10.00 ₽
├ | ├ | Резистор 0805 1% 20 кОм |  |  |  |  |  |  |  |  |  |  |  |  |  |  |  |  |  | RC0805FR-0720KL | 1 |  |  |  |  | 5.00 ₽ | 5.00 ₽
├ | ├ | Резистор 0805 5% 10 кОм |  |  |  |  |  |  |  |  |  |  |  |  |  |  |  |  |  | RC0805JR-0710KL | 13 |  |  |  |  | 5.00 ₽ | 65.00 ₽
├ | ├ | Резистор 0805 5% 0 Ом |  |  |  |  |  |  |  |  |  |  |  |  |  |  |  |  |  | RC0805JR-070RL | 1 |  |  |  |  | 5.00 ₽ | 5.00 ₽
├ | ├ | Резистор 0805 5% 22 Ом |  |  |  |  |  |  |  |  |  |  |  |  |  |  |  |  |  | RC0805JR-0722RL | 2 |  |  |  |  | 5.00 ₽ | 10.00 ₽
├ | ├ | Резистор 0805 5% 100Ом |  |  |  |  |  |  |  |  |  |  |  |  |  |  |  |  |  | RC0805JR-07100RL | 7 |  |  |  |  | 5.00 ₽ | 35.00 ₽
├ | ├ | Резистор 1206 5% 510 кОм |  |  |  |  |  |  |  |  |  |  |  |  |  |  |  |  |  | RC1206JR-07510KL | 4 |  |  |  |  | 5.00 ₽ | 20.00 ₽
├ | ├ | Термистор 1% 10кОм |  |  |  |  |  |  |  |  |  |  |  |  |  |  |  |  |  | B57861-S 103-F40 | 2 |  |  |  |  | 110.00 ₽ | 220.00 ₽
├ | ├ | Варистор 10% 300В 300пФ50А |  |  |  |  |  |  |  |  |  |  |  |  |  |  |  |  |  | B72214S0301K101 | 1 |  |  |  |  | 59.00 ₽ | 59.00 ₽
├ | ├ | Трансформатор KST760871631 |  |  |  |  |  |  |  |  |  |  |  |  |  |  |  |  |  | KST-760871631 | 1 |  |  | https://kodo-trans.ru/katalog/analogi/wurth-ac-dc-flyback/kst-760871631/ |  | 250.00 ₽ | 250.00 ₽
├ | ├ | Лин. Стаб. 5V 800mA |  |  |  |  |  |  |  |  |  |  |  |  |  |  |  |  |  | AMS1117-5.0 | 1 |  |  |  |  | 27.00 ₽ | 27.00 ₽
├ | ├ | Лин. Стаб. 3.3V 300mA |  |  |  |  |  |  |  |  |  |  |  |  |  |  |  |  |  | RT9193-33GB | 1 |  |  |  |  | 11.00 ₽ | 11.00 ₽
├ | ├ | Драйвер MOSFET 25V 3.5A |  |  |  |  |  |  |  |  |  |  |  |  |  |  |  |  |  | PN7001LTB-A1 | 1 |  |  |  |  | 14.00 ₽ | 14.00 ₽
├ | ├ | Диод USBLC6-2SC6, SOT23-6L |  |  |  |  |  |  |  |  |  |  |  |  |  |  |  |  |  | USBLC6-2SC6, SOT23- 6L | 1 |  |  |  |  | 5.00 ₽ | 5.00 ₽
├ | ├ | Диодный мост DB207 |  |  |  |  |  |  |  |  |  |  |  |  |  |  |  |  |  | DB-207 | 1 |  |  |  |  | 22.00 ₽ | 22.00 ₽
├ | ├ | Диод SOD-323 100В 150мА |  |  |  |  |  |  |  |  |  |  |  |  |  |  |  |  |  | 1N4148WS | 2 |  |  |  |  | 0.70 ₽ | 1.40 ₽
├ | ├ | Диод SMA 1кВ 2А |  |  |  |  |  |  |  |  |  |  |  |  |  |  |  |  |  | S2M | 1 |  |  |  |  | 4.00 ₽ | 4.00 ₽
├ | ├ | Стабилитрон miniMELF 24В 0,5Вт |  |  |  |  |  |  |  |  |  |  |  |  |  |  |  |  |  | BZV55C24 | 2 |  |  |  |  | 2.00 ₽ | 4.00 ₽
├ | ├ | Диод SMA 100В 1А |  |  |  |  |  |  |  |  |  |  |  |  |  |  |  |  |  | M2 | 1 |  |  |  |  | 10.00 ₽ | 10.00 ₽
├ | ├ | Диод TO220 100В 20А |  |  |  |  |  |  |  |  |  |  |  |  |  |  |  |  |  | MBR20100CT | 2 |  |  |  |  | 40.00 ₽ | 80.00 ₽
├ | ├ | Диод BAT54S |  |  |  |  |  |  |  |  |  |  |  |  |  |  |  |  |  | BAT54S | 4 |  |  |  |  | 4.00 ₽ | 16.00 ₽
├ | ├ | Транзистор MOSFET N-Channel 20В 4.2А |  |  |  |  |  |  |  |  |  |  |  |  |  |  |  |  |  | IRLML2502 | 3 |  |  |  |  | 60.00 ₽ | 180.00 ₽
├ | ├ | Симистор BTA16- 600BRG, TO-220AB |  |  |  |  |  |  |  |  |  |  |  |  |  |  |  |  |  | BTA16-600BRG, TO220AB | 2 |  |  |  |  | 160.00 ₽ | 320.00 ₽
├ | ├ | Транзистор MOSFET N-Ch 600В 4А |  |  |  |  |  |  |  |  |  |  |  |  |  |  |  |  |  | STP4NK60ZFP | 1 |  |  |  |  | 35.00 ₽ | 35.00 ₽
├ | ├ | Транзистор MOSFET N-Ch 60В 45А |  |  |  |  |  |  |  |  |  |  |  |  |  |  |  |  |  | 2SK2232-VB | 1 |  |  |  |  | 83.00 ₽ | 83.00 ₽
├ | ├ | Разъем PLS-4, шаг 2.54мм |  |  |  |  |  |  |  |  |  |  |  |  |  |  |  |  |  | PLS-4 | 1 |  |  |  |  | 8.00 ₽ | 8.00 ₽
├ | ├ | Разъем 2EDGR-5.0- 03P-14-00A(H) |  |  |  |  |  |  |  |  |  |  |  |  |  |  |  |  |  | 2EDGR-5.0-03P-14- 00A(H) | 1 |  |  |  |  | 26.00 ₽ | 26.00 ₽
├ | ├ | Разъем 2EDGR-5.0- 02P-14-00A(H) |  |  |  |  |  |  |  |  |  |  |  |  |  |  |  |  |  | 2EDGR-5.0-02P-14- 00A(H) | 7 |  |  |  |  | 19.00 ₽ | 133.00 ₽
├ | ├ | Разъем шлейф на плату 40 pin шаг 2.54 мм |  |  |  |  |  |  |  |  |  |  |  |  |  |  |  |  |  | BH-40 (DS1013-40S) (IDC-40MS) | 1 |  |  |  |  | 26.00 ₽ | 26.00 ₽
├ | ├ | Разъем PLS-2, шаг 2.54мм |  |  |  |  |  |  |  |  |  |  |  |  |  |  |  |  |  | PLS-2 | 1 |  |  |  |  | 8.00 ₽ | 8.00 ₽
├ | Печатная плата Пульт управления (Печатный узел) |  |  |  |  |  |  |  |  |  |  |  |  |  |  |  |  |  |  | СТЖ-1.ПУ.02.00.001 | 1 | шт |  |  |  |  | 0.00 ₽
├ | ├ | Текстолит |  |  |  |  |  |  |  |  |  |  |  |  |  |  |  |  |  |  | 1 | шт | Резонит | https://www.rezonit.ru/pcb/odnostoronnie-i-dvustoronnie/ |  |  | 1700.00 ₽
├ | ├ | ЖКИ 8х2 диспей |  |  |  |  |  |  |  |  |  |  |  |  |  |  |  |  |  | BCB0802-02-BL | 1 | шт | Blaze Display Technology | https://www.chipdip.ru/product/bcb0802-02-2 |  | 520.00 ₽ | 520.00 ₽
├ | ├ | Конденсатор 1206 10% 50В 4.7мкФ X7R |  |  |  |  |  |  |  |  |  |  |  |  |  |  |  |  |  | CC1206KKX7R9BB475 | 2 | шт |  | https://www.chipdip.ru/product0/8010257222 |  | 32.00 ₽ | 64.00 ₽
├ | ├ | Конденсатор 0805 10% 50В 100нФ X7R |  |  |  |  |  |  |  |  |  |  |  |  |  |  |  |  |  | GRM21BR71H104KA0 1L | 2 | шт |  | https://www.chipdip.ru/product0/9000489412 |  | 4.00 ₽ | 8.00 ₽
├ | ├ | Кнопка тактовая 12x12x5 |  |  |  |  |  |  |  |  |  |  |  |  |  |  |  |  |  | KAN1211-0501B | 5 | шт |  | https://www.chipdip.ru/product0/8007167254 |  | 5.00 ₽ | 25.00 ₽
├ | ├ | Светодиод 0805 RED 2,5В 230мКд |  |  |  |  |  |  |  |  |  |  |  |  |  |  |  |  |  | KP-2012SURCK | 1 | шт |  | https://www.chipdip.ru/product0/8014215052 |  | 21.00 ₽ | 21.00 ₽
├ | ├ | Пьезоизлучатель звуковой 4кГц 60дБ 3В 17x4.6мм |  |  |  |  |  |  |  |  |  |  |  |  |  |  |  |  |  | PS1740P02CE | 1 | шт |  | https://www.chipdip.ru/product0/8004079529 |  | 72.00 ₽ | 72.00 ₽
├ | ├ | Резистор 0805 5% 1,2 кОм |  |  |  |  |  |  |  |  |  |  |  |  |  |  |  |  |  | RC0805JR-071K2L | 3 | шт |  | https://www.chipdip.ru/product/0.125w-0805-1.2-kom-5 |  | 5.00 ₽ | 15.00 ₽
├ | ├ | Резистор 0805 5% 120Ом |  |  |  |  |  |  |  |  |  |  |  |  |  |  |  |  |  | RC0805JR-07120RL | 1 | шт |  | https://www.chipdip.ru/product/0.125w-0805-120-om-5 |  | 5.00 ₽ | 5.00 ₽
├ | ├ | Резистор 0805 5% 0 Ом |  |  |  |  |  |  |  |  |  |  |  |  |  |  |  |  |  | RC0805JR-070RL | 1 | шт |  | https://www.chipdip.ru/product/0.125w-0805-peremychka-0-om |  | 5.00 ₽ | 5.00 ₽
├ | ├ | Резистор 0805 5% 1 кОм |  |  |  |  |  |  |  |  |  |  |  |  |  |  |  |  |  | RC0805JR-071KL | 1 | шт |  | https://www.chipdip.ru/product/0.125w-0805-1-kom-5 |  | 5.00 ₽ | 5.00 ₽
├ | ├ | Транзистор MOSFET N-Channel 20В 4.2А |  |  |  |  |  |  |  |  |  |  |  |  |  |  |  |  |  | IRLML2502 | 3 | шт |  | https://www.chipdip.ru/product/irlml2502tr |  | 60.00 ₽ | 180.00 ₽
├ | ├ | Разъем PLS-14, шаг 2.54мм |  |  |  |  |  |  |  |  |  |  |  |  |  |  |  |  |  | KLS1-207-2-14-S | 2 | шт |  | https://www.chipdip.ru/product0/8013285224 |  | 4.00 ₽ | 8.00 ₽
├ | ├ | Разъем шлейф, шаг 2.54мм |  |  |  |  |  |  |  |  |  |  |  |  |  |  |  |  |  | FDC-40 (DS1018-40) | 1 | шт |  | https://www.chipdip.ru/product/fdc-40 |  | 51.00 ₽ | 51.00 ₽
├ | ├ | Разъем на шлейф IDC-40F (DS1016-40) |  |  |  |  |  |  |  |  |  |  |  |  |  |  |  |  |  | IDC-40F (DS1016-40) | 1 | шт |  | https://www.chipdip.ru/product/idc-40f |  | 22.00 ₽ | 22.00 ₽
├ | ├ | Шлейф плоский 1,27мм 40жил |  |  |  |  |  |  |  |  |  |  |  |  |  |  |  |  |  | DS1057-40-30 (FRC-40- 30) | 1 | шт |  | https://www.chipdip.ru/product/ds1057-40-30-frc-40-30-2 |  | 190.00 ₽ | 190.00 ₽
├ | Шлейф Система - Пульт |  |  |  |  |  |  |  |  |  |  |  |  |  |  |  |  |  |  |  | 1 | шт |  |  |  |  | 0.00 ₽
├ | Корпус СТЖ |  |  |  |  |  |  |  |  |  |  |  |  |  |  |  |  |  |  | СТЖ-1.СЕ.01.00.00 | 1 | шт | ООО "Ресторанный Техник" |  |  |  | 0.00 ₽
├ | ├ | Верхний коппус |  |  |  |  |  |  |  |  |  |  |  |  |  |  |  |  |  | СТЖ-1.СЕ.01.01.00 | 1 | шт | ООО "Ресторанный Техник" |  |  |  | 0.00 ₽
├ | ├ | ├ | Верхняя крышка |  |  |  |  |  |  |  |  |  |  |  |  |  |  |  |  | СТЖ-1.СЕ.01.01.01 | 1 | шт | ООО "Ресторанный Техник" |  |  |  | 0.00 ₽
├ | ├ | ├ | Основание/боковина |  |  |  |  |  |  |  |  |  |  |  |  |  |  |  |  | СТЖ-1.СЕ.01.01.02 | 1 | шт | ООО "Ресторанный Техник" |  |  |  | 0.00 ₽
├ | ├ | ├ | Лицевая панель |  |  |  |  |  |  |  |  |  |  |  |  |  |  |  |  | СТЖ-1.СЕ.01.01.03 | 1 | шт | ООО "Ресторанный Техник" |  |  |  | 0.00 ₽
├ | ├ | ├ | ├ | Наклейка управления |  |  |  |  |  |  |  |  |  |  |  |  |  |  |  | СТЖ-1.НК.01.00.001 |  |  | ООО "ДAНА_НН" |  |  |  | 0.00 ₽
├ | ├ | ├ | Держатель плат |  |  |  |  |  |  |  |  |  |  |  |  |  |  |  |  | СТЖ-1.СЕ.01.01.04 |  | шт | ООО "Ресторанный Техник" |  |  |  | 0.00 ₽
├ | ├ | ├ | Винт М3х6 DIN 7991 |  |  |  |  |  |  |  |  |  |  |  |  |  |  |  |  |  |  | шт |  |  |  |  | 0.00 ₽ | Требуется окончание модели
├ | ├ | ├ | Винтовая заклепка М3 |  |  |  |  |  |  |  |  |  |  |  |  |  |  |  |  |  |  | шт | MESSER 212103S-1500 |  |  |  | 0.00 ₽ | Требуется окончание модели
├ | ├ | Защита Нагревателя |  |  |  |  |  |  |  |  |  |  |  |  |  |  |  |  |  | СТЖ-1.СЕ.01.02.00 | 1 | шт | ООО "Ресторанный Техник" |  |  |  | 0.00 ₽
├ | ├ | ├ | Защита 1 |  |  |  |  |  |  |  |  |  |  |  |  |  |  |  |  | СТЖ-1.СЕ.01.02.01 | 1 | шт | ООО "Ресторанный Техник" |  |  |  | 0.00 ₽
├ | ├ | ├ | Защита 2 |  |  |  |  |  |  |  |  |  |  |  |  |  |  |  |  | СТЖ-1.СЕ.01.02.02 | 1 | шт | ООО "Ресторанный Техник" |  |  |  | 0.00 ₽
├ | ├ | ├ | Винт М3х6 DIN 7991 |  |  |  |  |  |  |  |  |  |  |  |  |  |  |  |  |  |  | шт |  |  |  |  | 0.00 ₽ | Требуется окончание модели
├ | ├ | ├ | Винтовая заклепка М3 |  |  |  |  |  |  |  |  |  |  |  |  |  |  |  |  |  |  | шт | MESSER 212103S-1500 |  |  |  | 0.00 ₽ | Требуется окончание модели
├ | Смеситель |  |  |  |  |  |  |  |  |  |  |  |  |  |  |  |  |  |  | СТЖ-1.СЕ.01.03.00 | 1 | шт | ООО "Ресторанный Техник" |  |  |  | 0.00 ₽
├ | ├ | ├ | Электродвигатель 12V |  |  |  |  |  |  |  |  |  |  |  |  |  |  |  |  | RS 775/12В3800 | 1 | шт |  | https://dvrobot.ru/catalog/mekhanika/motory/bez_reduktorov/16211/ |  | 930.00 ₽ | 930.00 ₽
├ | ├ | ├ | Вал 130х6 мм |  |  |  |  |  |  |  |  |  |  |  |  |  |  |  |  | СТЖ-1.СЕ.01.03.01 | 1 | шт | ООО "Ресторанный Техник" |  |  | 100.00 ₽ | 100.00 ₽
├ | ├ | ├ | Крыльчатка 46 |  |  |  |  |  |  |  |  |  |  |  |  |  |  |  |  | СТЖ-1.СЕ.01.03.02 | 1 | шт | ООО "Ресторанный Техник" |  |  |  | 0.00 ₽
├ | ├ | Винт М4 |  |  |  |  |  |  |  |  |  |  |  |  |  |  |  |  |  |  |  |  |  |  |  |  | 0.00 ₽
├ | ├ | Шайба М4 |  |  |  |  |  |  |  |  |  |  |  |  |  |  |  |  |  |  |  |  |  |  |  |  | 0.00 ₽
├ | Датчик температуры |  |  |  |  |  |  |  |  |  |  |  |  |  |  |  |  |  |  | СТЖ-1.СЕ.01.04.00 | 2 | шт |  |  |  |  | 0.00 ₽
├ | ├ | NTC термистор 3% 10 кОм |  |  |  |  |  |  |  |  |  |  |  |  |  |  |  |  |  | B57500K103A1 |  |  | TDK | https://www.chipdip.ru/product0/8794351308?from=visited_product |  | 570.00 ₽ | 0.00 ₽
├ | ├ | Корпус датчика температуры |  |  |  |  |  |  |  |  |  |  |  |  |  |  |  |  |  | СТЖ-1.СЕ.01.04.01 | 2 | шт | ООО "Ресторанный Техник" |  |  |  | 0.00 ₽
├ | ├ | Гайка М6 |  |  |  |  |  |  |  |  |  |  |  |  |  |  |  |  |  |  | 2 | шт |  |  |  |  | 0.00 ₽
├ | ├ | Шайба М6 |  |  |  |  |  |  |  |  |  |  |  |  |  |  |  |  |  |  | 2 | шт |  |  |  |  | 0.00 ₽
├ | Нагреватель |  |  |  |  |  |  |  |  |  |  |  |  |  |  |  |  |  |  | СТЖ-1.СЕ.01.05.00 | 1 | шт | ООО "Протэко" | https://proteko.su/ |  | 1700.00 ₽ | 1700.00 ₽
├ | ├ | ТЭН 2 кВт

Sheet: Set
 | 0 | 0 | 0 | 0 | 0 | 0 | 0 | 0 | 0
0 | 1 | 1 | 0 | 0 | 1 | 1 | 0 | 1 | 1
0 | 0 | 0 | 1 | 1 | 1 | 0 | 0 | 1 | 0
0 | 0 | 0 | 1 | 1 | 1 | 0 | 0 | 1 | 0
0 | 0 | 0 | 1 | 1 | 1 | 0 | 1 | 1 | 0
0 | 1 | 0 | 1 | 1 | 1 | 1 | 0 | 1 | 1
0 |  | 1 | 1 | 0 | 1 | 1 | 0 | 1 | 1
0 |  |  | 1 | 0 | 1 | 0 | 1 | 1 | 0
0 |  |  |  | 1 | 1 | 0 | 1 | 1 | 0
0 |  |  |  |  | 1 | 0 | 0 | 1 | 1
0 |  |  |  |  |  | 1 | 0 | 1 | 1
0 |  |  |  |  |  |  | 1 | 1 | 0
0 |  |  |  |  |  |  |  | 1 | 0
0 |  |  |  |  |  |  |  |  | 1

Sheet: Lib
№ | Наименование | Кол-во | Ед.
1 | СТЖ-1.ПР Компоненты Проекта Устройства Стабилизации Температуры Жидкости
2 | СТЖ-1.ПУ.01.00.001 Печатная плата Система управления (Печатный узел) | 1 | шт
3 | СТЖ-1.ПП.01.00.001 Текстолит | 1 | шт
4 | Cетевой шнур ПВС-ВП 3х2,5 с угловой вилкой S22 2,5метра | 1 | шт
5 | PG-R-7 Ввод кабельный спиральный | 1 | шт
6 | TEA1733T Контроллер источника питания | 1 | шт
7 | KST-760871631 Трансформатор импульсный | 1 | шт
8 | ABM-001-50 Радиатор
9 | GD32E103C8T6 Микроконтроллер | 2 | шт
10 | К73-17 0.1мкФ, 400В, 5%, JFA02G104J Конденсатор К73-17, JFA02G104J 0.01мкФ 400 В 5% | 2
11 | CC1206KKX7R9BB475 Конденсатор 1206 10% 50В 4.7мкФ X7R | 5
12 | GRM21BR71H104KA0 1L Конденсатор 0805 10% 50В 100нФ X7R | 24
13 | JNE2G101M10002200 250 Конденсатор Эл-лит. 20% 400В 100мкФ | 1
14 | GRM31BR72J222KW0 1L Конденсатор 1206 10% 630В 2.2нФ X7R | 1
15 | GRM31BR72J472KW0 1L Конденсатор 1206 10% 630В 4.7нФ X7R | 1
16 | GRM219R71C474K Конденсатор 0805 10% 16В 470нФ X7R | 1
17 | GRM219R71E224K Конденсатор 0805 10% 25В 220нФ X7R | 2
18 | GRM21BR72A103KA0 1L Конденсатор 0805 10% 100В 10нФ X7R | 3
19 | JRC1C681M035008001 60000B Конденсатор Эл-лит. 20% 16В 680мкФ | 2
20 | GRM21A5C2E220J Конденсатор 0805 10% 250В 22пФC0G | 1
21 | DE1E3KX472MN4AN0 1F Конденсатор X1/Y1 20% 250В 4,7нФ | 2
22 | DE1E3KX102MA4BN0 1F Конденсатор X1/Y1 20% 250В 1нФ | 2
23 | B32922C3104K000 Конденсатор X2 Пропилен 10% 305В 100нФ | 2
24 | GRM21BR71H105KA1 2L Конденсатор 0805 10% 50В 1мкФ X7R | 2
25 | GRM21BR72A223KA0 1L Конденсатор 0805 10% 100В 22нФ X7R | 1
26 | CC0603JRNPO9BN120 Конденсатор 0603 05% 50В 12пФNP0 | 2
27 | CC0805JRNPO9BN200 Конденсатор 0805 05% 50В 20пФNP0 | 2
28 | TL431ACDBZT, SOT23_3 ИОН TL431ACDBZT, SOT-23_3 | 1
29 | MOC3063 Оптосимистор MOC3063, DIP6 zerocross | 2
30 | LTV-356T Оптрон PC817, DIP-4 | 1
31 | TEA1733 AC/DC TEA1733, SO8 | 1
32 | PLY10AN1521R6R2 Фильтр ЭМП 300В 1,6А 14мГн | 1
33 | CD54-100K Дроссель 10% 10uH 1,3A | 1
34 | DT-26 Кварцевый резонатор 32,768 кГц | 1
35 | L-KLS14-HC-49S-8.000- 20-30-A Кварцевый резонатор 8MHz HC49 | 1
36 | RC0805JR-07180RL Резистор 0805 5% 180Ом | 2
37 | RC1206JR-07360RL Резистор 1206 5% 360Ом | 2
38 | RC0805JR-071K2L Резистор 0805 5% 1,2 кОм | 7
39 | RC1206JR-07150RL Резистор 1206 5% 150Ом | 4
40 | RC1206JR-07330RL Резистор 1206 5% 330Ом | 2
41 | RC0805JR-071KL Резистор 0805 5% 1 кОм | 2
42 | RC0805JR-074R7L Резистор 0805 5% 4,7 Ом | 2
43 | RC0805JR-0710RL Резистор 0805 5% 10 Ом | 2
44 | RC0805JR-0733KL Резистор 0805 5% 33 кОм | 1
45 | RC1206JR-0747КL Резистор 1206 5% 47 кОм | 2
46 | RC1206JR-073M3L Резистор 1206 5% 3,3 МОм | 2
47 | RC0805JR-07560KL Резистор 0805 5% 560 кОм | 1
48 | RC1206JR-073ML Резистор 1206 5% 3 МОм | 1
49 | RC0805JR-0782KL Резистор 0805 5% 82 кОм | 1
50 | ERJ8BSFR15V Резистор 1206 1% 150мОм импульсный | 1
51 | RC1206FR-07220RL Резистор 1206 1% 220Ом | 1
52 | RC0805JR-072M2L Резистор 0805 5% 2,2 МОм | 1
53 | RC1206JR-07100RL Резистор 1206 5% 100Ом | 1
54 | RC0805JR-07150KL Резистор 0805 5% 150Ом | 1
55 | RC0805JR-075K1L, RC0805FR-075K1L Резистор 0805 5% 5,1 кОм, Резистор 0805 1% 5,1 кОм | 2
56 | RC0805FR-0720KL Резистор 0805 1% 20 кОм | 1
57 | RC0805JR-0710KL Резистор 0805 5% 10 кОм | 13
58 | RC0805JR-070RL Резистор 0805 5% 0 Ом | 2
59 | RC0805JR-0722RL Резистор 0805 5% 22 Ом | 2
60 | RC0805JR-07100RL Резистор 0805 5% 100Ом | 7
61 | RC1206JR-07510KL Резистор 1206 5% 510 кОм | 4
62 | B57861-S 103-F40 Термистор 1% 10кОм | 2
63 | B72214S0301K101 Варистор 10% 300В 300пФ50А | 1
64 | KST-760871631 Трансформатор KST760871631 | 1
65 | AMS1117-5.0 Лин. Стаб. 5V 800mA | 1
66 | RT9193-33GB Лин. Стаб. 3.3V 300mA | 1
67 | PN7001LTB-A1 Драйвер MOSFET 25V 3.5A | 1
68 | USBLC6-2SC6, SOT23- 6L Диод USBLC6-2SC6, SOT23-6L | 1
69 | DB-207 Диодный мост DB207 | 1
70 | 1N4148WS Диод SOD-323 100В 150мА | 2
71 | S2M Диод SMA 1кВ 2А | 1
72 | BZV55C24 Стабилитрон miniMELF 24В 0,5Вт | 2
73 | M2 Диод SMA 100В 1А | 1
74 | MBR20100CT Диод TO220 100В 20А | 2
75 | BAT54S Диод BAT54S | 4
76 | IRLML2502 Транзистор MOSFET N-Channel 20В 4.2А | 6
77 | BTA16-600BRG, TO220AB Симистор BTA16- 600BRG, TO-220AB | 2
78 | STP4NK60ZFP Транзистор MOSFET N-Ch 600В 4А | 1
79 | 2SK2232-VB Транзистор MOSFET N-Ch 60В 45А | 1
80 | PLS-4 Разъем PLS-4, шаг 2.54мм | 1
81 | 2EDGR-5.0-03P-14- 00A(H) Разъем 2EDGR-5.0- 03P-14-00A(H) | 1
82 | 2EDGR-5.0-02P-14- 00A(H) Разъем 2EDGR-5.0- 02P-14-00A(H) | 7
83 | BH-40 (DS1013-40S) (IDC-40MS) Разъем шлейф на плату 40 pin шаг 2.54 мм | 1
84 | PLS-2 Разъем PLS-2, шаг 2.54мм | 1
85 | СТЖ-1.ПУ.02.00.001 Печатная плата Пульт управления (Печатный узел) | 1 | шт
86 | Текстолит | 1 | шт
87 | BCB0802-02-BL ЖКИ 8х2 диспей | 1 | шт
88 | KAN1211-0501B Кнопка тактовая 12x12x5 | 5 | шт
89 | KP-2012SURCK Светодиод 0805 RED 2,5В 230мКд | 1 | шт
90 | PS1740P02CE Пьезоизлучатель звуковой 4кГц 60дБ 3В 17x4.6мм | 1 | шт
91 | RC0805JR-07120RL Резистор 0805 5% 120Ом | 1 | шт
92 | KLS1-207-2-14-S Разъем PLS-14, шаг 2.54мм | 2 | шт
93 | FDC-40 (DS1018-40) Разъем шлейф, шаг 2.54мм | 1 | шт
94 | IDC-40F (DS1016-40) Разъем на шлейф IDC-40F (DS1016-40) | 1 | шт
95 | DS1057-40-30 (FRC-40- 30) Шлейф плоский 1,27мм 40жил | 1 | шт
96 | Шлейф Система - Пульт | 1 | шт
97 | СТЖ-1.СЕ.01.00.00 Корпус СТЖ | 1 | шт
98 | СТЖ-1.СЕ.01.01.00 Верхний коппус | 1 | шт
99 | СТЖ-1.СЕ.01.01.01 Верхняя крышка | 1 | шт
100 | СТЖ-1.СЕ.01.01.02 Основание/боковина | 1 | шт
101 | СТЖ-1.СЕ.01.01.03 Лицевая панель | 1 | шт
102 | СТЖ-1.НК.01.00.001 Наклейка управления
103 | СТЖ-1.СЕ.01.01.04 Держатель плат |  | шт
104 | Винт М3х6 DIN 7991 | 0 | шт
105 | Винтовая заклепка М3 | 0 | шт
106 | СТЖ-1.СЕ.01.02.00 Защита Нагревателя | 1 | шт
107 | СТЖ-1.СЕ.01.02.01 Защита 1 | 1 | шт
108 | СТЖ-1.СЕ.01.02.02 Защита 2 | 1 | шт
109 | СТЖ-1.СЕ.01.03.00 Смеситель | 1 | шт
110 | RS 775/12В3800 Электродвигатель 12V | 1 | шт
111 | СТЖ-1.СЕ.01.03.01 Вал 130х6 мм | 1 | шт
112 | СТЖ-1.СЕ.01.03.02 Крыльчатка 46 | 1 | шт
113 | Винт М4
114 | Шайба М4
115 | СТЖ-1.СЕ.01.04.00 Датчик температуры | 2 | шт
116 | B57500K103A1 NTC термистор 3% 10 кОм
117 | СТЖ-1.СЕ.01.04.01 Корпус датчика температуры | 2 | шт
118 | Гайка М6 | 2 | шт
119 | Шайба М6 | 2 | шт
