RungeKut/thermocirculator/hardware/ЭСИ - какого-то проекта=).xlsm

Sheet: Main
 |  |  |  |  |  | Кнопка чтобы пересчитать общее количество одинаковых компонентов |  |  |  |  |  |  |  |  |  |  |  |  |  | Голубой - что обновлено Желтый - что добавить Красный - что не верно
1 | 2 | 3 | 4 | 5 | 6 | 7 | 8 | 9 | 10 | 11 | 12 | 13 | 14 | 15 | 16 | 17 | 18 | 19 | 20 - уровень вложения | 1209 | штуки/килограммы/литры/метры
Наименование [Синий - последние изменения] |  |  |  |  |  |  |  |  |  |  |  |  |  |  |  |  |  |  |  | Обозначение | Кол-во | Ед. | Производитель | Ссылка | Комплектация ТУ | ЦЕНА за шт. | Стоймость | Примечание
Компоненты Проекта |  |  |  |  |  |  |  |  |  |  |  |  |  |  |  |  |  |  |  | АЕЖР.941146.001
├ | изделие серии "Пусто" мод. 0.1-12 км/ч, Без СР, комплекс |  |  |  |  |  |  |  |  |  |  |  |  |  |  |  |  |  |  | АЕЖР.941146.901 | 1 | шт |  |  | 1 |  |  | Комплекс, полотно 150х59х19
│ | ├ | изделие серии "Пусто" модификации 0,1-12 км / ч, без системы разгрузки |  |  |  |  |  |  |  |  |  |  |  |  |  |  |  |  |  | АЕЖР.941146.101 | 1 | шт |  |  | 1.1 |  |  | 101 а не 102 потому что нельзя поправить в ТУ
│ | │ | ├ | База изделия |  |  |  |  |  |  |  |  |  |  |  |  |  |  |  |  | АЕЖР.424319.001 АЕЖР-01.01.01.000 | 1 | шт
│ | │ | │ | ├ | Каркас |  |  |  |  |  |  |  |  |  |  |  |  |  |  |  | АЕЖР-01.01.01.100 | 1 | шт
│ | │ | │ | ├ | Вал ведущий |  |  |  |  |  |  |  |  |  |  |  |  |  |  |  | АЕЖР-01.01.01.200 | 1 | шт
│ | │ | │ | │ | ├ | Вал ведущий |  |  |  |  |  |  |  |  |  |  |  |  |  |  | АЕЖР-01.01.01.210 | 1
│ | │ | │ | │ | │ | ├ | Вал ведущий |  |  |  |  |  |  |  |  |  |  |  |  |  | АЕЖР-01.01.01.211 | 1
│ | │ | │ | │ | │ | └ | Втулка |  |  |  |  |  |  |  |  |  |  |  |  |  | АЕЖР-01.01.01.212 | 1
│ | │ | │ | │ | ├ | Шкив |  |  |  |  |  |  |  |  |  |  |  |  |  |  | АЕЖР-01.01.01.201 | 1
│ | │ | │ | │ | ├ | Ось вала |  |  |  |  |  |  |  |  |  |  |  |  |  |  | АЕЖР-01.01.01.202-01 | 1
│ | │ | │ | │ | ├ | Винт M8x30 Din 912 |  |  |  |  |  |  |  |  |  |  |  |  |  |  |  | 4
│ | │ | │ | │ | ├ | Шайба 8 Din 127 |  |  |  |  |  |  |  |  |  |  |  |  |  |  |  | 4
│ | │ | │ | │ | ├ | Кольцо стопорное наружное 19 Din 471 |  |  |  |  |  |  |  |  |  |  |  |  |  |  |  | 2
│ | │ | │ | │ | └ | Подшипник 1501-2RS |  |  |  |  |  |  |  |  |  |  |  |  |  |  |  | 2
│ | │ | │ | ├ | Вал ведомый |  |  |  |  |  |  |  |  |  |  |  |  |  |  |  | АЕЖР-01.01.01.300 | 1 | шт
│ | │ | │ | │ | ├ | Вал ведомый |  |  |  |  |  |  |  |  |  |  |  |  |  |  | АЕЖР-01.01.01.301 | 1
│ | │ | │ | │ | ├ | Ось вала |  |  |  |  |  |  |  |  |  |  |  |  |  |  | АЕЖР-01.01.01.202 | 1
│ | │ | │ | │ | ├ | Кольцо стопорное наружное 19 Din 471 |  |  |  |  |  |  |  |  |  |  |  |  |  |  |  | 2
│ | │ | │ | │ | └ | Подшипник 1501-2RS |  |  |  |  |  |  |  |  |  |  |  |  |  |  |  | 2
│ | │ | │ | ├ | Ножка |  |  |  |  |  |  |  |  |  |  |  |  |  |  |  | АЕЖР-01.01.01.400 | 2 | шт
│ | │ | │ | │ | ├ | Опора |  |  |  |  |  |  |  |  |  |  |  |  |  |  | АЕЖР-01.01.01.410 | 1
│ | │ | │ | │ | │ | ├ | Опора |  |  |  |  |  |  |  |  |  |  |  |  |  | АЕЖР-01.01.01.411 | 1
│ | │ | │ | │ | │ | ├ | Шпилька |  |  |  |  |  |  |  |  |  |  |  |  |  | АЕЖР-01.01.01.412 | 1
│ | │ | │ | │ | └ | Опора резиновая |  |  |  |  |  |  |  |  |  |  |  |  |  |  | АЕЖР-01.01.01.401 | 1
│ | │ | │ | ├ | Рамка подъемника |  |  |  |  |  |  |  |  |  |  |  |  |  |  |  | АЕЖР-01.01.01.500 | 1 | шт
│ | │ | │ | │ | ├ | Труба |  |  |  |  |  |  |  |  |  |  |  |  |  |  | АЕЖР-01.01.01.501 | 2
│ | │ | │ | │ | ├ | Втулка |  |  |  |  |  |  |  |  |  |  |  |  |  |  | АЕЖР-01.01.01.502 | 2
│ | │ | │ | │ | ├ | Перемычка |  |  |  |  |  |  |  |  |  |  |  |  |  |  | АЕЖР-01.01.01.509 | 2 |  |  | 30x30x2 ГОСТ 8645-68 Ст4пс ГОСТ 13663-86 L=690-1мм
│ | │ | │ | │ | ├ | Труба |  |  |  |  |  |  |  |  |  |  |  |  |  |  | АЕЖР-01.01.01.511 | 1 |  |  | 30x30x2 ГОСТ 8645-68 Ст4пс ГОСТ 13663-86 L=160-1мм
│ | │ | │ | │ | ├ | Кронштейн |  |  |  |  |  |  |  |  |  |  |  |  |  |  | АЕЖР-01.01.01.503 | 2
│ | │ | │ | │ | ├ | Косынка |  |  |  |  |  |  |  |  |  |  |  |  |  |  | АЕЖР-01.01.01.504 | 1
│ | │ | │ | │ | ├ | Косынка |  |  |  |  |  |  |  |  |  |  |  |  |  |  | АЕЖР-01.01.01.505 | 1
│ | │ | │ | │ | ├ | Косынка |  |  |  |  |  |  |  |  |  |  |  |  |  |  | АЕЖР-01.01.01.506 | 2
│ | │ | │ | │ | ├ | Ухо |  |  |  |  |  |  |  |  |  |  |  |  |  |  | АЕЖР-01.01.01.507 | 2
│ | │ | │ | │ | └ | Ухо |  |  |  |  |  |  |  |  |  |  |  |  |  |  | АЕЖР-01.01.01.508 | 2
│ | │ | │ | ├ | Каркас |  |  |  |  |  |  |  |  |  |  |  |  |  |  |  | АЕЖР-01.01.03.100 | 1 | шт
│ | │ | │ | ├ | Ось |  |  |  |  |  |  |  |  |  |  |  |  |  |  |  | АЕЖР-01.01.01.001 | 2 | шт
│ | │ | │ | ├ | Втулка |  |  |  |  |  |  |  |  |  |  |  |  |  |  |  | АЕЖР-01.01.01.002 | 2 | шт
│ | │ | │ | ├ | Ось |  |  |  |  |  |  |  |  |  |  |  |  |  |  |  | АЕЖР-01.01.01.003 | 2 | шт
│ | │ | │ | ├ | Труба |  |  |  |  |  |  |  |  |  |  |  |  |  |  |  | АЕЖР-01.01.01.004 | 3 | шт
│ | │ | │ | ├ | Труба |  |  |  |  |  |  |  |  |  |  |  |  |  |  |  | АЕЖР-01.01.01.005 | 2 | шт
│ | │ | │ | ├ | Дека |  |  |  |  |  |  |  |  |  |  |  |  |  |  |  | АЕЖР-01.01.01.006 | 1 | шт
│ | │ | │ | ├ | Шайба |  |  |  |  |  |  |  |  |  |  |  |  |  |  |  | АЕЖР-01.01.01.007 | 2 | шт
│ | │ | │ | ├ | Шайба |  |  |  |  |  |  |  |  |  |  |  |  |  |  |  | АЕЖР-01.01.01.008 | 4 | шт
│ | │ | │ | ├ | Беговое полотно |  |  |  |  |  |  |  |  |  |  |  |  |  |  |  | АЕЖР-01.01.01.009 | 1 | шт |  | 2RXA 7io-0 f80 Black Двухслойный, цвет черный, верхняя поверхность ПВХ профиль "гольф" 0,9мм, нижняя поверхность полиестер, толщина 2, нормальное огибание 30, обратное огибание 60, температурный диапазон от -15 до +90С. Косой шов, направляющая ПВХ 6х4, поверхность крепления нижняя, по центру, 1шт. Длина - 3280 мм. Ширина - 600 мм.
│ | │ | │ | ├ | Буфер |  |  |  |  |  |  |  |  |  |  |  |  |  |  |  | АЕЖР-01.01.01.012 | 2 | шт |  | Техпластина ТМКШ 8мм 26х26мм (ШхД)
│ | │ | │ | ├ | Буфер |  |  |  |  |  |  |  |  |  |  |  |  |  |  |  | АЕЖР-01.01.01.013 | 16 | шт |  | Техпластина ТМКШ 8мм 20х40мм (ШхД)
│ | │ | │ | ├ | Фанера |  |  |  |  |  |  |  |  |  |  |  |  |  |  |  | АЕЖР-01.01.01.014 | 2 | шт
│ | │ | │ | ├ | Шайба |  |  |  |  |  |  |  |  |  |  |  |  |  |  |  | АЕЖР-01.01.03.002 | 4 | шт
│ | │ | │ | ├ | Втулка |  |  |  |  |  |  |  |  |  |  |  |  |  |  |  | АЕЖР-01.01.03.003 | 4 | шт
│ | │ | │ | ├ | Крышка |  |  |  |  |  |  |  |  |  |  |  |  |  |  |  | АЕЖР-01.01.03.001 | 1 | шт
│ | │ | │ | ├ | Болт М8х80 Din 931 |  |  |  |  |  |  |  |  |  |  |  |  |  |  |  |  | 6 | шт
│ | │ | │ | ├ | Винт М8х20 Din 912 |  |  |  |  |  |  |  |  |  |  |  |  |  |  |  |  | 4 | шт
│ | │ | │ | ├ | Винт М12х80 Din 912 |  |  |  |  |  |  |  |  |  |  |  |  |  |  |  |  | 2 | шт
│ | │ | │ | ├ | Винт М12х110 Din 912 |  |  |  |  |  |  |  |  |  |  |  |  |  |  |  |  | 2 | шт
│ | │ | │ | ├ | Винт М6х30 Din 965 |  |  |  |  |  |  |  |  |  |  |  |  |  |  |  |  | 6 | шт
│ | │ | │ | ├ | Винт М6х40 Din 966 |  |  |  |  |  |  |  |  |  |  |  |  |  |  |  |  | 4 | шт
│ | │ | │ | ├ | Винт М6х35 Din 967 |  |  |  |  |  |  |  |  |  |  |  |  |  |  |  |  | 12 | шт
│ | │ | │ | ├ | Винт М6х20 Din 7985 |  |  |  |  |  |  |  |  |  |  |  |  |  |  |  |  | 4 | шт
│ | │ | │ | ├ | Винт М4х8 Din 967 |  |  |  |  |  |  |  |  |  |  |  |  |  |  |  |  | 9 | шт
│ | │ | │ | ├ | Гайка М8 Din 985 |  |  |  |  |  |  |  |  |  |  |  |  |  |  |  |  | 10 | шт
│ | │ | │ | ├ | Гайка М12 Din 985 |  |  |  |  |  |  |  |  |  |  |  |  |  |  |  |  | 2 | шт
│ | │ | │ | ├ | Гайка М6 Din 985 |  |  |  |  |  |  |  |  |  |  |  |  |  |  |  |  | 22 | шт
│ | │ | │ | ├ | Гайка М10 Din 985 |  |  |  |  |  |  |  |  |  |  |  |  |  |  |  |  | 2 | шт
│ | │ | │ | ├ | Гайка М16 Din 985 |  |  |  |  |  |  |  |  |  |  |  |  |  |  |  |  | 2 | шт
│ | │ | │ | ├ | Шайба М8 Din 125 |  |  |  |  |  |  |  |  |  |  |  |  |  |  |  |  | 20 | шт
│ | │ | │ | ├ | Шайба М6 Din 125 |  |  |  |  |  |  |  |  |  |  |  |  |  |  |  |  | 26 | шт
│ | │ | │ | ├ | Шайба М6 Din 127 |  |  |  |  |  |  |  |  |  |  |  |  |  |  |  |  | 4 | шт
│ | │ | │ | ├ | Шайба М10 Din 7349 |  |  |  |  |  |  |  |  |  |  |  |  |  |  |  |  | 2 | шт
│ | │ | │ | ├ | Шайба М12 Din 125 |  |  |  |  |  |  |  |  |  |  |  |  |  |  |  |  | 2 | шт
│ | │ | │ | ├ | Шплинт 2,9х32 Din 94 |  |  |  |  |  |  |  |  |  |  |  |  |  |  |  |  | 2 | шт
│ | │ | │ | ├ | Ремень зубчатый |  |  |  |  |  |  |  |  |  |  |  |  |  |  |  | HTD 925-8M-20 CXP | 1 | шт
│ | │ | │ | ├ | Заглушка пластиковая 100х50 цвет черный |  |  |  |  |  |  |  |  |  |  |  |  |  |  |  |  | 2 | шт
│ | │ | │ | └ | Колесо подвилочное LR90 d80мм, ширина 60мм |  |  |  |  |  |  |  |  |  |  |  |  |  |  |  |  | 2 | шт
│ | │ | ├ | Натяжитель Ремня |  |  |  |  |  |  |  |  |  |  |  |  |  |  |  |  | АЕЖР-01.01.00.100 | 1 | шт
│ | │ | │ | ├ | Рамка натяжителя |  |  |  |  |  |  |  |  |  |  |  |  |  |  |  | АЕЖР-01.01.00.110 | 1
│ | │ | │ | ├ | Гайка M10 Din 985 |  |  |  |  |  |  |  |  |  |  |  |  |  |  |  |  | 1
│ | │ | │ | ├ | Болт М10х60 Din 931 |  |  |  |  |  |  |  |  |  |  |  |  |  |  |  |  | 1
│ | │ | │ | ├ | Шайба 10 Din 125 |  |  |  |  |  |  |  |  |  |  |  |  |  |  |  |  | 4
│ | │ | │ | ├ | Шайба 10 Din 127 |  |  |  |  |  |  |  |  |  |  |  |  |  |  |  |  | 1
│ | │ | │ | ├ | Подшипник 62200-2RS |  |  |  |  |  |  |  |  |  |  |  |  |  |  |  |  | 2
│ | │ | │ | ├ | Винт М6х20 Din 912 |  |  |  |  |  |  |  |  |  |  |  |  |  |  |  |  | 3
│ | │ | │ | ├ | Шайба 6 Din 125 |  |  |  |  |  |  |  |  |  |  |  |  |  |  |  |  | 3
│ | │ | │ | └ | Шайба 6 Din 127 |  |  |  |  |  |  |  |  |  |  |  |  |  |  |  |  | 3
│ | │ | ├ | Опора правая |  |  |  |  |  |  |  |  |  |  |  |  |  |  |  |  | АЕЖР-01.01.10.100 | 1 | шт
│ | │ | ├ | Шасси входной автоматики |  |  |  |  |  |  |  |  |  |  |  |  |  |  |  |  | АЕЖР.435221.004 | 1 | шт
│ | │ | │ | ├ | Провод соединительный реле с колодкой 24V DC (14) - клемма проходная |  |  |  |  |  |  |  |  |  |  |  |  |  |  |  | АЕЖР.685611.046 | 1 | шт
│ | │ | │ | │ | ├ | Наконечник кабельный НШВИ 1-8 (КВТ) |  |  |  |  |  |  |  |  |  |  |  |  |  |  | НШВИ 1-8 (КВТ) | 2 | шт
│ | │ | │ | │ | ├ | Провод ПВ-3 1 мм2 Черный |  |  |  |  |  |  |  |  |  |  |  |  |  |  |  | 0.5 | м
│ | │ | │ | │ | └ | ТУТнг-4/2 (КВТ) Черный |  |  |  |  |  |  |  |  |  |  |  |  |  |  |  | 0.45 | м
│ | │ | │ | ├ | Провод соединительный реле с колодкой 24V DC (11) - контактор модульный(А2) |  |  |  |  |  |  |  |  |  |  |  |  |  |  |  | АЕЖР.685611.047 | 1 | шт
│ | │ | │ | │ | ├ | Наконечник кабельный НШВИ 1-8 (КВТ) |  |  |  |  |  |  |  |  |  |  |  |  |  |  | НШВИ 1-8 (КВТ) | 2 | шт
│ | │ | │ | │ | ├ | Провод ПВ-3 1 мм2 Черный |  |  |  |  |  |  |  |  |  |  |  |  |  |  |  | 0.5 | м
│ | │ | │ | │ | └ | ТУТнг-4/2 (КВТ) Черный |  |  |  |  |  |  |  |  |  |  |  |  |  |  |  | 0.5 | м
│ | │ | │ | ├ | Кабель соединительный контактор модульный (1,3,А1)- Клеммы переходные |  |  |  |  |  |  |  |  |  |  |  |  |  |  |  | АЕЖР.685631.143 | 1 | шт
│ | │ | │ | │ | ├ | Наконечник кабельный НШВИ 1.5-8 (КВТ) |  |  |  |  |  |  |  |  |  |  |  |  |  |  | НШВИ 1.5-8 (КВТ) | 4 | шт
│ | │ | │ | │ | ├ | Наконечник кабельный НШВИ 1-8 (КВТ) |  |  |  |  |  |  |  |  |  |  |  |  |  |  | НШВИ 1-8 (КВТ) | 1 | шт
│ | │ | │ | │ | ├ | Провод ПВ-3 1 мм2 Красный |  |  |  |  |  |  |  |  |  |  |  |  |  |  |  | 0.45 | м
│ | │ | │ | │ | ├ | Провод ПВ-3 1.5 мм2 Красный |  |  |  |  |  |  |  |  |  |  |  |  |  |  |  | 0.45 | м
│ | │ | │ | │ | ├ | Провод ПВ-3 1.5 мм2 Синий |  |  |  |  |  |  |  |  |  |  |  |  |  |  |  | 0.45 | м
│ | │ | │ | │ | └ | ТУТнг-10/5 (КВТ) Черный |  |  |  |  |  |  |  |  |  |  |  |  |  |  |  | 0.35 | м
│ | │ | │ | ├ | Основание |  |  |  |  |  |  |  |  |  |  |  |  |  |  |  | АЕЖР-01.01.08.001 | 1 | шт
│ | │ | │ | ├ | Винт М4х12 Din 967 - Zn |  |  |  |  |  |  |  |  |  |  |  |  |  |  |  |  | 3 | шт
│ | │ | │ | ├ | Винт М4х8 Din 967 - Zn |  |  |  |  |  |  |  |  |  |  |  |  |  |  |  |  | 6 | шт
│ | │ | │ | ├ | Шайба 4.3 Din 125 - Zn |  |  |  |  |  |  |  |  |  |  |  |  |  |  |  |  | 3 | шт
│ | │ | │ | ├ | Шайба 4 Din 127 - Zn |  |  |  |  |  |  |  |  |  |  |  |  |  |  |  |  | 3 | шт
│ | │ | │ | ├ | Гайка М4 Din 934 - Zn |  |  |  |  |  |  |  |  |  |  |  |  |  |  |  |  | 3 | шт
│ | │ | │ | ├ | Din-рейка оцинкованная-(130 мм)х1,0мм-КЭАЗ |  |  |  |  |  |  |  |  |  |  |  |  |  |  |  | 234382 | 1 | шт | КЭАЗ | https://keaz.ru/catalog/sredstva-montaja-aksessuari-nku/aksessuari-dlya-nku/aksessuari-Din-reyki/234382
│ | │ | │ | ├ | Диод + зеленый светодиод для защиты катушек реле = 6/24В |  |  |  |  |  |  |  |  |  |  |  |  |  |  |  | RZM031RB | 1 | шт | Schneider Electric | https://www.tme.eu/ru/details/rzm031rb/rele-elektromagn-aksessuary/schneider-electric/
│ | │ | │ | ├ | Клемма проходная WDU 2.5N - 1023700000, 500V, 32A, Коричневый |  |  |  |  |  |  |  |  |  |  |  |  |  |  |  | 1023700000 | 9 | шт | Weidmueller |  |  | 221.40 ₽
│ | │ | │ | ├ | Контактор модульный Acti9 iCT 2P 40А 230В 2НО |  |  |  |  |  |  |  |  |  |  |  |  |  |  |  | A9C20842 | 1 | шт | Schneider Electric |  |  | 3827.68 ₽
│ | │ | │ | ├ | Концевая пластина WAP WDU2.5N/4N |  |  |  |  |  |  |  |  |  |  |  |  |  |  |  | 1060000000 | 3 | шт | Weidmueller |  |  | 169.00 ₽
│ | │ | │ | ├ | Короб перфорированный RL75 15x18 серый QUADRO, 00670RL |  |  |  |  |  |  |  |  |  |  |  |  |  |  |  |  | 0.28 | м
│ | │ | │ | ├ | Перемычка WQV 2.5/3, 1053760000, 32A, Желтая |  |  |  |  |  |  |  |  |  |  |  |  |  |  |  | 1053760000 | 3 | шт | Weidmueller |  |  | 318.00 ₽
│ | │ | │ | ├ | Реле интерфейсное с колодкой, 2ПК, 24В DC, RSB2A080BDS |  |  |  |  |  |  |  |  |  |  |  |  |  |  |  | RSB2A080BDS | 1 | шт | Schneider Electric |  |  | 274.68 ₽
│ | │ | │ | └ | Торцевой упор ZBT003 BT/3 |  |  |  |  |  |  |  |  |  |  |  |  |  |  |  |  | 2 | шт
│ | │ | ├ | Шасси асинхронного двигателя |  |  |  |  |  |  |  |  |  |  |  |  |  |  |  |  | АЕЖР.525411.001 | 1 | шт
│ | │ | │ | ├ | Кабель соединительный термистор NTC - система управления АЕЖР |  |  |  |  |  |  |  |  |  |  |  |  |  |  |  | АЕЖР.685631.129 | 1 | шт
│ | │ | │ | │ | ├ | Розетка кабельная Mini-SPOX 2 Circuits |  |  |  |  |  |  |  |  |  |  |  |  |  |  | 50375023 | 1 | шт | MOLEX | https://www.molex.com/molex/products/part-detail/crimp_housings/0050375023 |  | 2.50 ₽
│ | │ | │ | │ | ├ | Mini-SPOX Female Crimp Terminal, 22-28 AWG, Reel |  |  |  |  |  |  |  |  |  |  |  |  |  |  | 08701039 | 2 | шт | MOLEX | https://www.molex.com/molex/search/partSearch?pQuery=&sType=s&query=5263
│ | │ | │ | │ | ├ | NTC термистор 10k |  |  |  |  |  |  |  |  |  |  |  |  |  |  | NTCALUG91A103G301 | 1 | шт |  | https://ru.mouser.com/datasheet/2/427/ntcalug91am4-1628677.pdf |  | 65.20 ₽ |  | Вместо B57703M0103G040
│ | │ | │ | │ | ├ | Провод ПВ-3 0.5 мм2 Черный |  |  |  |  |  |  |  |  |  |  |  |  |  |  |  | 1.5 | м
│ | │ | │ | │ | ├ | ТУТнг-6/3 (КВТ) Черный |  |  |  |  |  |  |  |  |  |  |  |  |  |  |  | 0.65 | м
│ | │ | │ | │ | └ | ТУТнг-3/1.5 (КВТ) Черный |  |  |  |  |  |  |  |  |  |  |  |  |  |  |  | 0.1 | м
│ | │ | │ | ├ | Оптический диск |  |  |  |  |  |  |  |  |  |  |  |  |  |  |  | АЕЖР.723356.001 | 1 | шт
│ | │ | │ | ├ | Шкив привода изделия ведущий |  |  |  |  |  |  |  |  |  |  |  |  |  |  |  | АЕЖР-01.01.05.001 | 1 | шт
│ | │ | │ | │ | ├ | Болт М10х16 Din 933 |  |  |  |  |  |  |  |  |  |  |  |  |  |  |  | 1
│ | │ | │ | │ | ├ | Шайба 10 Din 9021 |  |  |  |  |  |  |  |  |  |  |  |  |  |  |  | 1
│ | │ | │ | │ | └ | Шайба 10 Din 127 |  |  |  |  |  |  |  |  |  |  |  |  |  |  |  | 1
│ | │ | │ | ├ | Прижимная втулка |  |  |  |  |  |  |  |  |  |  |  |  |  |  |  | АЕЖР-01.01.05.003 | 1 | шт
│ | │ | │ | ├ | Втулка |  |  |  |  |  |  |  |  |  |  |  |  |  |  |  | АЕЖР-01.01.05.005 | 1 | шт
│ | │ | │ | ├ | Шайба |  |  |  |  |  |  |  |  |  |  |  |  |  |  |  | АЕЖР-01.01.05.006 | 1 | шт
│ | │ | │ | ├ | Винт М4х10 Din 967 - Zn |  |  |  |  |  |  |  |  |  |  |  |  |  |  |  |  | 2 | шт
│ | │ | │ | ├ | Болт М8х20 Din 933 - Zn |  |  |  |  |  |  |  |  |  |  |  |  |  |  |  |  | 1 | шт
│ | │ | │ | ├ | Шайба 8 Din 127 - Zn |  |  |  |  |  |  |  |  |  |  |  |  |  |  |  |  | 1 | шт
│ | │ | │ | ├ | Двигатель асинхронный АИР90L4 У2 2,2 кВт, 1420 об/мин, б/вентилятора |  |  |  |  |  |  |  |  |  |  |  |  |  |  |  | АЕЖР.525411.002 | 1 | шт |  |  |  | 6352.00 ₽
│ | │ | │ | ├ | Втулка |  |  |  |  |  |  |  |  |  |  |  |  |  |  |  | АЕЖР-01.01.00.007 | 4
│ | │ | │ | ├ | Болт М10х16 Din 931 |  |  |  |  |  |  |  |  |  |  |  |  |  |  |  |  | 4
│ | │ | │ | ├ | Шайба 10 Din 125 |  |  |  |  |  |  |  |  |  |  |  |  |  |  |  |  | 8
│ | │ | │ | ├ | Гайка М10 Din 985 |  |  |  |  |  |  |  |  |  |  |  |  |  |  |  |  | 4
│ | │ | │ | ├ | Лента металлизированная Klebebander |  |  |  |  |  |  |  |  |  |  |  |  |  |  |  |  | 60х40
│ | │ | │ | └ | Кабельный ввод PG 13.5 латунный |  |  |  |  |  |  |  |  |  |  |  |  |  |  |  |  | 1 | шт
│ | │ | ├ | Шасси инвертора |  |  |  |  |  |  |  |  |  |  |  |  |  |  |  |  | АЕЖР.435221.002 | 1 | шт
│ | │ | │ | ├ | Провод заземления фильтр ЭМП (Е) - преобразователь частоты (Line (E)) |  |  |  |  |  |  |  |  |  |  |  |  |  |  |  | АЕЖР.685611.044 | 1 | шт
│ | │ | │ | │ | ├ | Клемма кабельная НКИ-1.5-5 (КВТ) |  |  |  |  |  |  |  |  |  |  |  |  |  |  |  | 2 | шт
│ | │ | │ | │ | ├ | Провод ПВ-3 1.5 мм2 Желтый |  |  |  |  |  |  |  |  |  |  |  |  |  |  |  | 0.35 | м
│ | │ | │ | │ | └ | ТУТнг-6/3 (КВТ) Черный |  |  |  |  |  |  |  |  |  |  |  |  |  |  |  | 0.31 | м
│ | │ | │ | ├ | Провод заземления фильтр ЭМП (Е) - клемма проходная |  |  |  |  |  |  |  |  |  |  |  |  |  |  |  | АЕЖР.685611.045 | 1 | шт
│ | │ | │ | │ | ├ | Клемма кабельная НКИ-1.5-5 (КВТ) |  |  |  |  |  |  |  |  |  |  |  |  |  |  |  | 1 | шт
│ | │ | │ | │ | ├ | Наконечник кабельный НШВИ-1.5-8 (КВТ) |  |  |  |  |  |  |  |  |  |  |  |  |  |  |  | 1 | шт
│ | │ | │ | │ | ├ | Провод ПВ-3 1.5 мм2 Желтый |  |  |  |  |  |  |  |  |  |  |  |  |  |  |  | 0.8 | м
│ | │ | │ | │ | └ | ТУТнг-6/3 (КВТ) Черный |  |  |  |  |  |  |  |  |  |  |  |  |  |  |  | 0.31 | м
│ | │ | │ | ├ | Жгут соединительный плата энкодера - энкодер оптический - преобразователь частоты |  |  |  |  |  |  |  |  |  |  |  |  |  |  |  | АЕЖР.685621.033 | 1 | шт
│ | │ | │ | │ | ├ | Розетка кабельная Mini-SPOX 4 Circuits |  |  |  |  |  |  |  |  |  |  |  |  |  |  | 50375043 | 1 | шт | MOLEX | https://www.molex.com/molex/products/part-detail/crimp_housings/0050375023 |  | 2.50 ₽
│ | │ | │ | │ | ├ | Mini-SPOX Female Crimp Terminal, 22-28 AWG, Reel |  |  |  |  |  |  |  |  |  |  |  |  |  |  | 08701039 | 4 | шт | MOLEX | https://www.molex.com/molex/search/partSearch?pQuery=&sType=s&query=5263
│ | │ | │ | │ | ├ | Наконечник кабельный НШВИ 0.5-8 (КВТ) |  |  |  |  |  |  |  |  |  |  |  |  |  |  | НШВИ 0.5-8 (КВТ) | 3 | шт
│ | │ | │ | │ | ├ | Наконечник кабельный НШВИ 1-8 (КВТ) |  |  |  |  |  |  |  |  |  |  |  |  |  |  | НШВИ 1-8 (КВТ) | 2 | шт
│ | │ | │ | │ | ├ | Провод ПВ-3 0.5 мм2 Черный |  |  |  |  |  |  |  |  |  |  |  |  |  |  |  | 1 | м
│ | │ | │ | │ | ├ | Провод ПВ-3 0.5 мм2 Синий |  |  |  |  |  |  |  |  |  |  |  |  |  |  |  | 0.55 | м
│ | │ | │ | │ | └ | ТУТнг-6/3 (КВТ) Черный |  |  |  |  |  |  |  |  |  |  |  |  |  |  |  | 0.36 | м
│ | │ | │ | ├ | Кабель соединительный система управления АЕЖР (Х7) - преобразователь частоты |  |  |  |  |  |  |  |  |  |  |  |  |  |  |  | АЕЖР.685631.132 | 1 | шт
│ | │ | │ | │ | ├ | Вилка кабельная TP-8P8C (RJ45) |  |  |  |  |  |  |  |  |  |  |  |  |  |  |  | 1 | шт
│ | │ | │ | │ | ├ | Розетка кабельная Mini-SPOX 3 Circuits |  |  |  |  |  |  |  |  |  |  |  |  |  |  | 50375033 | 1 | шт | MOLEX | https://www.molex.com/molex/products/part-detail/crimp_housings/0050375033 |  | 3.33 ₽
│ | │ | │ | │ | ├ | Mini-SPOX Female Crimp Terminal, 22-28 AWG, Reel |  |  |  |  |  |  |  |  |  |  |  |  |  |  | 08701039 | 3 | шт | MOLEX | https://www.molex.com/molex/search/partSearch?pQuery=&sType=s&query=5263
│ | │ | │ | │ | ├ | Провод ПВ-3 0.5 мм2 Черный |  |  |  |  |  |  |  |  |  |  |  |  |  |  |  | 1.4 | м
│ | │ | │ | │ | ├ | Провод ПВ-3 0.5 мм2 Синий |  |  |  |  |  |  |  |  |  |  |  |  |  |  |  | 1.4 | м
│ | │ | │ | │ | └ | ТУТнг-6/3 (КВТ) Черный |  |  |  |  |  |  |  |  |  |  |  |  |  |  |  | 1.3 | м
│ | │ | │ | ├ | Кабель соединительный контактор модульный (2,4) - фильтр ЭМП (L, N) |  |  |  |  |  |  |  |  |  |  |  |  |  |  |  | АЕЖР.685631.136 | 1 | шт
│ | │ | │ | │ | ├ | Наконечник кабельный НШВИ 1.5-5 (КВТ) |  |  |  |  |  |  |  |  |  |  |  |  |  |  | НШВИ 1.5-5 (КВТ) | 2 | шт
│ | │ | │ | │ | ├ | Наконечник кабельный НШВИ 1.5-8 (КВТ) |  |  |  |  |  |  |  |  |  |  |  |  |  |  | НШВИ 1.5-8 (КВТ) | 2 | шт
│ | │ | │ | │ | ├ | Провод ПВ-3 1.5 мм2 Черный |  |  |  |  |  |  |  |  |  |  |  |  |  |  |  | 0.95 | м
│ | │ | │ | │ | ├ | Провод ПВ-3 1.5 мм2 Синий |  |  |  |  |  |  |  |  |  |  |  |  |  |  |  | 0.95 | м
│ | │ | │ | │ | └ | ТУТнг-10/5 (КВТ) Черный |  |  |  |  |  |  |  |  |  |  |  |  |  |  |  | 0.85 | м
│ | │ | │ | ├ | Кабель соединительный система управления АЕЖР (Х5) - преобразователь частоты |  |  |  |  |  |  |  |  |  |  |  |  |  |  |  | АЕЖР.685631.137 | 1 | шт
│ | │ | │ | │ | ├ | Розетка кабельная Mini-SPOX 5 Circuits |  |  |  |  |  |  |  |  |  |  |  |  |  |  | 50375053 | 1 | шт | MOLEX | https://www.molex.com/molex/products/part-detail/crimp_housings/0050375033
│ | │ | │ | │ | ├ | Mini-SPOX Female Crimp Terminal, 22-28 AWG, Reel |  |  |  |  |  |  |  |  |  |  |  |  |  |  | 08701039 | 5 | шт | MOLEX | https://www.molex.com/molex/search/partSearch?pQuery=&sType=s&query=5263
│ | │ | │ | │ | ├ | Наконечник кабельный НШВИ 0.5-8 (КВТ) |  |  |  |  |  |  |  |  |  |  |  |  |  |  | НШВИ 0.5-8 (КВТ) | 4 | шт
│ | │ | │ | │ | ├ | Провод ПВ-3 0.5 мм2 Черный |  |  |  |  |  |  |  |  |  |  |  |  |  |  |  | 4.8 | м
│ | │ | │ | │ | ├ | Провод ПВ-3 0.5 мм2 Синий |  |  |  |  |  |  |  |  |  |  |  |  |  |  |  | 1.6 | м
│ | │ | │ | │ | └ | ТУТнг-10/5 (КВТ) Черный |  |  |  |  |  |  |  |  |  |  |  |  |  |  |  | 1.5 | м
│ | │ | │ | ├ | Кабель соединительный преобразователь частоты (Line)- фильтр ЭМП (L', N') |  |  |  |  |  |  |  |  |  |  |  |  |  |  |  | АЕЖР.685631.142 | 1 | шт
│ | │ | │ | │ | ├ | Наконечник кабельный НШВИ 1.5-5 (КВТ) |  |  |  |  |  |  |  |  |  |  |  |  |  |  | НШВИ 1.5-5 (КВТ) | 4 | шт
│ | │ | │ | │ | ├ | Провод ПВ-3 1.5 мм2 Красный |  |  |  |  |  |  |  |  |  |  |  |  |  |  |  | 0.25 | м
│ | │ | │ | │ | ├ | Провод ПВ-3 1.5 мм2 Синий |  |  |  |  |  |  |  |  |  |  |  |  |  |  |  | 0.25 | м
│ | │ | │ | │ | └ | ТУТнг-10/5 (КВТ) Черный |  |  |  |  |  |  |  |  |  |  |  |  |  |  |  | 0.15 | м
│ | │ | │ | ├ | Кабель соединительный преобразователь частоты (Output)- мотор (М1) |  |  |  |  |  |  |  |  |  |  |  |  |  |  |  | АЕЖР.685631.146 | 1 | шт
│ | │ | │ | │ | ├ | Клемма кабельная НКИ-2.5-5 (КВТ) |  |  |  |  |  |  |  |  |  |  |  |  |  |  |  | 8 | шт
│ | │ | │ | │ | ├ | Провод ПВ-3 1.5 мм2 Красный |  |  |  |  |  |  |  |  |  |  |  |  |  |  |  | 1.1 | м
│ | │ | │ | │ | ├ | Провод ПВ-3 1.5 мм2 Синий |  |  |  |  |  |  |  |  |  |  |  |  |  |  |  | 1.1 | м
│ | │ | │ | │ | ├ | Провод ПВ-3 1.5 мм2 Коричневый |  |  |  |  |  |  |  |  |  |  |  |  |  |  |  | 1.1 | м
│ | │ | │ | │ | ├ | Провод ПВ-3 1.5 мм2 Желтый |  |  |  |  |  |  |  |  |  |  |  |  |  |  |  | 0.7 | м
│ | │ | │ | │ | ├ | ТУТнг-10/5 (КВТ) Черный |  |  |  |  |  |  |  |  |  |  |  |  |  |  |  | 0.45 | м
│ | │ | │ | │ | └ | ПМЛ 6х10 |  |  |  |  |  |  |  |  |  |  |  |  |  |  |  | 0.4 | м
│ | │ | │ | ├ | Крышка |  |  |  |  |  |  |  |  |  |  |  |  |  |  |  | АЕЖР-01.01.03.001 | 1 | шт
│ | │ | │ | ├ | Пластина |  |  |  |  |  |  |  |  |  |  |  |  |  |  |  | АЕЖР-01.01.03.008 | 1 | шт
│ | │ | │ | ├ | Кронштейн |  |  |  |  |  |  |  |  |  |  |  |  |  |  |  | АЕЖР-01.01.03.009 | 1 | шт
│ | │ | │ | ├ | Винт М4х8 Din 965 - Zn |  |  |  |  |  |  |  |  |  |  |  |  |  |  |  |  | 2 | шт
│ | │ | │ | ├ | Винт М4х10 Din 965 - Zn |  |  |  |  |  |  |  |  |  |  |  |  |  |  |  |  | 2 | шт
│ | │ | │ | ├ | Винт М5х16 Din 965 - Zn |  |  |  |  |  |  |  |  |  |  |  |  |  |  |  |  | 4 | шт
│ | │ | │ | ├ | Винт М4х6 Din 965 - Zn |  |  |  |  |  |  |  |  |  |  |  |  |  |  |  |  | 9 | шт
│ | │ | │ | ├ | Винт М4х8 Din 967 - Zn |  |  |  |  |  |  |  |  |  |  |  |  |  |  |  |  | 8 | шт
│ | │ | │ | ├ | Винт М5х12 Din 967 - Zn |  |  |  |  |  |  |  |  |  |  |  |  |  |  |  |  | 2 | шт
│ | │ | │ | ├ | Винт М5х8 Din 7985 - Zn |  |  |  |  |  |  |  |  |  |  |  |  |  |  |  |  | 2 | шт
│ | │ | │ | ├ | Гайка М4 Din 934 - Zn |  |  |  |  |  |  |  |  |  |  |  |  |  |  |  |  | 2 | шт
│ | │ | │ | ├ | Гайка М5 Din 934 - Zn |  |  |  |  |  |  |  |  |  |  |  |  |  |  |  |  | 4 | шт
│ | │ | │ | ├ | Шайба 4.3 Din 125 - Zn |  |  |  |  |  |  |  |  |  |  |  |  |  |  |  |  | 2 | шт
│ | │ | │ | ├ | Шайба 5.3 Din 125 - Zn |  |  |  |  |  |  |  |  |  |  |  |  |  |  |  |  | 6 | шт
│ | │ | │ | ├ | Шайба 4 Din 127 - Zn |  |  |  |  |  |  |  |  |  |  |  |  |  |  |  |  | 2 | шт
│ | │ | │ | ├ | Шайба 5 Din 127 - Zn |  |  |  |  |  |  |  |  |  |  |  |  |  |  |  |  | 6 | шт
│ | │ | │ | ├ | Втулка предохранительная резиновая 8-8 ГОСТ 19421-74 |  |  |  |  |  |  |  |  |  |  |  |  |  |  |  |  | 1 | шт
│ | │ | │ | ├ | Втулка предохранительная резиновая 10-8 ГОСТ 19421-74 |  |  |  |  |  |  |  |  |  |  |  |  |  |  |  |  | 2 | шт
│ | │ | │ | ├ | Площадка монтажная ПМО 15х10 (Fortisflex) |  |  |  |  |  |  |  |  |  |  |  |  |  |  |  | 62452 | 2 | шт
│ | │ | │ | ├ | Стойка 7мм Никель винт/отв М4 DA7M4x15 |  |  |  |  |  |  |  |  |  |  |  |  |  |  |  |  | 2 | шт
│ | │ | │ | ├ | Скоба металлическая двухлапковая СМД 8-9 |  |  |  |  |  |  |  |  |  |  |  |  |  |  |  |  | 2 | шт
│ | │ | │ | ├ | Решетка вентилятора металл K-MF08E4Ha, Jamicon |  |  |  |  |  |  |  |  |  |  |  |  |  |  |  |  | 2 | шт
│ | │ | │ | ├ | Фильтр ЭМП EPCOS B84113H0000G125, 250 В / 25 А |  |  |  |  |  |  |  |  |  |  |  |  |  |  |  | B84113H0000G125 | 1 | шт | EPCOS |  |  | 25800.00 ₽ |  | стоимость энкодера,B84113H0000G125,VFD022E21A
│ | │ | │ | ├ | PG(M)-13.5, Ввод кабельный металл., IP68 |  |  |  |  |  |  |  |  |  |  |  |  |  |  |  |  | 1 | шт
│ | │ | │ | ├ | Преобразователь частоты VFD022E21A Delta, 2,2 кВт, 1ф |  |  |  |  |  |  |  |  |  |  |  |  |  |  |  | VFD022E21A | 1 | шт | Delta Electronics |  |  | 18501.67 ₽
│ | │ | │ | ├ | Плата энкодера Delta Electronics EME-PG01 |  |  |  |  |  |  |  |  |  |  |  |  |  |  |  | EME-PG01 | 1 | шт | Delta Electronics
│ | │ | │ | ├ | Стяжка кабельная нейлоновая, неоткрываемая 200х5 мм (белая) |  |  |  |  |  |  |  |  |  |  |  |  |  |  |  |  | 2 | шт
│ | │ | │ | ├ | Каркас |  |  |  |  |  |  |  |  |  |  |  |  |  |  |  | АЕЖР-01.01.03.100 | 1
│ | │ | │ | ├ | Шайба |  |  |  |  |  |  |  |  |  |  |  |  |  |  |  | АЕЖР-01.01.03.002 | 4
│ | │ | │ | ├ | Втулка |  |  |  |  |  |  |  |  |  |  |  |  |  |  |  | АЕЖР-01.01.03.003 | 4
│ | │ | │ | ├ | Основание |  |  |  |  |  |  |  |  |  |  |  |  |  |  |  | АЕЖР-01.01.03.101 | 1
│ | │ | │ | ├ | Стенка задняя |  |  |  |  |  |  |  |  |  |  |  |  |  |  |  | АЕЖР-01.01.03.102 | 1
│ | │ | │ | ├ | Боковая стенка |  |  |  |  |  |  |  |  |  |  |  |  |  |  |  | АЕЖР-01.01.03.103 | 1
│ | │ | │ | ├ | Боковая стенка |  |  |  |  |  |  |  |  |  |  |  |  |  |  |  | АЕЖР-01.01.03.104 | 1
│ | │ | │ | ├ | Cердечник ферритовый кольцевой МП-140, 44х28х10.3 |  |  |  |  |  |  |  |  |  |  |  |  |  |  |  |  | 2 |  |  |  |  | 1000.00 ₽
│ | │ | ├ | Шасси платы управления |  |  |  |  |  |  |  |  |  |  |  |  |  |  |  |  | АЕЖР.435221.003 | 1 | шт
│ | │ | │ | ├ | Плата системы управления (Печатный узел) |  |  |  |  |  |  |  |  |  |  |  |  |  |  |  | АЕЖР.468367.501-03 | 1 | шт |  |  |  | 4830.00 ₽
│ | │ | │ | │ | ├ | Механика
│ | │ | │ | │ | │ | ├ | Радиатор
│ | │ | │ | │ | │ | ├ | Радиатор
│ | │ | │ | │ | │ | ├ | Радиатор
│ | │ | │ | │ | │ | ├ | Радиатор
│ | │ | │ | │ | ├ | Система управления АЕЖР, ПО STM32 |  |  |  |  |  |  |  |  |  |  |  |  |  |  | АЕЖР.687253.020-2.12 ПО | 1 | шт
│ | │ | │ | │ | ├ | Плата системы управления |  |  |  |  |  |  |  |  |  |  |  |  |  |  | АЕЖР.687253.020 | 1 | шт
│ | │ | │ | │ | ├ | Керам. ЧИП конд. 220 пФ - 50 В - X7R - 10 % - 0805 |  |  |  |  |  |  |  |  |  |  |  |  |  |  | GRM15XR71H221KA86D | 23 | шт
│ | │ | │ | │ | ├ | Керам. ЧИП конд. 0,022 мкФ - 50 В - X7R - 10 % - 0805 |  |  |  |  |  |  |  |  |  |  |  |  |  |  | CC0805KRX7R9BB223 | 14 | шт
│ | │ | │ | │ | ├ | Конденсатор класс X1, Y1 2200 пФ - 250 В - 4000 В |  |  |  |  |  |  |  |  |  |  |  |  |  |  | DE1E3KX222MA5BA01 | 5 | шт
│ | │ | │ | │ | ├ | Керам. ЧИП конд. 0,1 мкФ - 50 В - X7R - 10 % - 0805 |  |  |  |  |  |  |  |  |  |  |  |  |  |  | GRM21BR71H104KA01L | 19 | шт
│ | │ | │ | │ | ├ | Тант. ЧИП конденсатор 10мкФ - 16 В - тип A |  |  |  |  |  |  |  |  |  |  |  |  |  |  | TR3A106K016C1700 | 2 | шт
│ | │ | │ | │ | ├ | Тант. ЧИП конденсатор 1мкФ - 20 В - тип A |  |  |  |  |  |  |  |  |  |  |  |  |  |  | TR3A105K020C3000 | 1 | шт
│ | │ | │ | │ | ├ | Конденсатор К73-17 1000 пФ - 400 В |  |  |  |  |  |  |  |  |  |  |  |  |  |  | К73-17 1000 пФ - 400 В | 1 | шт
│ | │ | │ | │ | ├ | Конденсатор К73-17 0,01 мкФ - 400 В |  |  |  |  |  |  |  |  |  |  |  |  |  |  | К73-17 0,01 мкФ - 400 В | 1 | шт
│ | │ | │ | │ | ├ | Керам. ЧИП конд. 4,7 мкФ - 25 В - X5R - 10 % - 0805 |  |  |  |  |  |  |  |  |  |  |  |  |  |  | GRM21BR61E475KA12L | 2 | шт
│ | │ | │ | │ | ├ | Керам. ЧИП конд. 0,33 мкФ - 50 В - X7R - 10 % - 0805 |  |  |  |  |  |  |  |  |  |  |  |  |  |  | GRM219R71H334KA88D | 1 | шт
│ | │ | │ | │ | ├ | Тант. ЧИП конденсатор 22 мкФ - 25 В - тип С |  |  |  |  |  |  |  |  |  |  |  |  |  |  | TR3C226K025C0400 | 1 | шт
│ | │ | │ | │ | ├ | Керам. ЧИП конд. 22 пФ - 50 В - C0G - 5 % - 0805 |  |  |  |  |  |  |  |  |  |  |  |  |  |  | GRM2165C1H220JZ01D | 2 | шт
│ | │ | │ | │ | ├ | Керам. ЧИП конд. 2,2 мкФ - 25 В - X5R - 10 % - 0805 |  |  |  |  |  |  |  |  |  |  |  |  |  |  | GRM219R61E225KA12D | 1 | шт
│ | │ | │ | │ | ├ | Керам. ЧИП конд. 1000 пФ - 100 В - C0G - 5 % - 0805 |  |  |  |  |  |  |  |  |  |  |  |  |  |  | GRM2165C2A102JA01D | 1 | шт
│ | │ | │ | │ | ├ | Конденсатор MKT 2,2 мкФ - 40VAC - 63VDC |  |  |  |  |  |  |  |  |  |  |  |  |  |  | B32529D0225K289 | 3 | шт
│ | │ | │ | │ | ├ | Керам. ЧИП конд. 4,7 мкФ - 50 В - X7R - 10 % - 1206 |  |  |  |  |  |  |  |  |  |  |  |  |  |  | CL31B475KBHNNNE | 10 | шт
│ | │ | │ | │ | ├ | Конденсатор SH 1000 мкФ - 35 В (13х20) |  |  |  |  |  |  |  |  |  |  |  |  |  |  | SH035M1000A5S-1320 | 2 | шт
│ | │ | │ | │ | ├ | Конденсатор SH 10 мкФ - 16 В (5х11) |  |  |  |  |  |  |  |  |  |  |  |  |  |  | SH016M0010B2F-0511 | 5 | шт
│ | │ | │ | │ | ├ | Керам. ЧИП конд. 0,01 мкФ - 100 В - X7R - 10 % - 0805 |  |  |  |  |  |  |  |  |  |  |  |  |  |  | CC0805KRX7R0BB103 | 23 | шт
│ | │ | │ | │ | ├ | Конденсатор CA 100 мкФ - 50 В (8х10) |  |  |  |  |  |  |  |  |  |  |  |  |  |  | CA050M0100REF-0810 | 2 | шт
│ | │ | │ | │ | ├ | Конденсатор SH 330 мкФ - 35 В (10х15) |  |  |  |  |  |  |  |  |  |  |  |  |  |  | SH035M0330A5S-1015 | 1 | шт
│ | │ | │ | │ | ├ | Конденсатор SJ 470 мкФ - 16 В (8х15) |  |  |  |  |  |  |  |  |  |  |  |  |  |  | SJ016M0470B3F-0815 | 1 | шт
│ | │ | │ | │ | ├ | Конденсатор CB 100 мкФ - 35 В (6х7) |  |  |  |  |  |  |  |  |  |  |  |  |  |  | CB035M0100RSH-0607 | 2 | шт
│ | │ | │ | │ | ├ | Конденсатор MKP 0,47 мкФ - 305 В |  |  |  |  |  |  |  |  |  |  |  |  |  |  | B32922C3474M | 2 | шт
│ | │ | │ | │ | ├ | Керам. ЧИП конд. 4,7 мкФ - 100 В - X7S - 20 % - 1206 |  |  |  |  |  |  |  |  |  |  |  |  |  |  | 12061Z475MAT2A | 2 | шт
│ | │ | │ | │ | ├ | Оптопара ILD206T, SOIC-8 |  |  |  |  |  |  |  |  |  |  |  |  |  |  | ILD206T, SOIC-8 | 8 | шт
│ | │ | │ | │ | ├ | Микросхема AD8541ART, SOT-23-5 |  |  |  |  |  |  |  |  |  |  |  |  |  |  | AD8541ART, SOT-23-5 | 1 | шт
│ | │ | │ | │ | ├ | Преобразователь JCH1024S24, 24 В / 24 В, 416 мА |  |  |  |  |  |  |  |  |  |  |  |  |  |  | JCH1024S24 | 1 | шт
│ | │ | │ | │ | ├ | Преобразователь PSD1-A-2405E, SMD(1Wt) |  |  |  |  |  |  |  |  |  |  |  |  |  |  | PSD1-A-2405E | 2 | шт
│ | │ | │ | │ | ├ | Преобразователь JCJ0824S05, 24 В / 5 В, 1,5 А |  |  |  |  |  |  |  |  |  |  |  |  |  |  | JCJ0824S05 | 1 | шт
│ | │ | │ | │ | ├ | Микросхема LD1117S33TR, SOT-223 |  |  |  |  |  |  |  |  |  |  |  |  |  |  | LD1117S33TR, SOT-223 | 1 | шт
│ | │ | │ | │ | ├ | Микросхема TL431ACDBVT, SOT-23-5 |  |  |  |  |  |  |  |  |  |  |  |  |  |  | TL431ACDBVT | 1 | шт
│ | │ | │ | │ | ├ | Оптосимистор MOC3023, DIP6 |  |  |  |  |  |  |  |  |  |  |  |  |  |  | MOC3023 | 1 | шт
│ | │ | │ | │ | ├ | Оптопара PC817, DIP-4 |  |  |  |  |  |  |  |  |  |  |  |  |  |  | PC817, DIP-4 | 1 | шт
│ | │ | │ | │ | ├ | Микросхема MAX485ESA, SO-8 |  |  |  |  |  |  |  |  |  |  |  |  |  |  | MAX485ESA, SO-8 | 1 | шт
│ | │ | │ | │ | ├ | Микросхема OPA2244, SOIC8 |  |  |  |  |  |  |  |  |  |  |  |  |  |  | OPA2244, SOIC8 | 1 | шт
│ | │ | │ | │ | ├ | Микросхема LIS3LV02DL, LGA-16 |  |  |  |  |  |  |  |  |  |  |  |  |  |  | LIS3LV02DL, LGA-16 | 1 | шт
│ | │ | │ | │ | ├ | Оптопара VO617A-3X007T, SMD4 |  |  |  |  |  |  |  |  |  |  |  |  |  |  | VO617A-3X007T, SMD4 | 3 | шт
│ | │ | │ | │ | ├ | Микросхема MAX3232EID, SOIC-D |  |  |  |  |  |  |  |  |  |  |  |  |  |  | MAX3232EID, SOIC-D | 1 | шт
│ | │ | │ | │ | ├ | Микросхема M24C04-WMN6TP, SO-8 |  |  |  |  |  |  |  |  |  |  |  |  |  |  | M24C04-WMN6TP, SO-8 | 1 | шт
│ | │ | │ | │ | ├ | Микросхема STM32F103RСT6, LQFP-64, 256 KBytes Flash, 48 KBytes SRAM |  |  |  |  |  |  |  |  |  |  |  |  |  |  | STM32F103RСT6, LQFP-64 | 1 | шт
│ | │ | │ | │ | ├ | Паяемая перемычка |  |  |  |  |  |  |  |  |  |  |  |  |  |  | SOLDER_JUMPER | 2 | шт
│ | │ | │ | │ | ├ | Реле IM07GR, 24VDC / 2А |  |  |  |  |  |  |  |  |  |  |  |  |  |  | IM07GR | 1 | шт
│ | │ | │ | │ | ├ | Реле RT424024, 24VDC / 8А |  |  |  |  |  |  |  |  |  |  |  |  |  |  | RT424024 | 1 | шт
│ | │ | │ | │ | ├ | Дроссель BLM21 - 220 Ом - 2 А - 0805 |  |  |  |  |  |  |  |  |  |  |  |  |  |  | BLM21PG221SN1 | 2 | шт
│ | │ | │ | │ | ├ | Дроссель двухобмоточный 2х1000 Ом - 200 В |  |  |  |  |  |  |  |  |  |  |  |  |  |  | CPFC74NP-CB10M4 | 2 | шт
│ | │ | │ | │ | ├ | Дроссель LQM21 - 10 мкГн - 60 мА - 0805 |  |  |  |  |  |  |  |  |  |  |  |  |  |  | LQM21FN100N00L | 1 | шт
│ | │ | │ | │ | ├ | Дроссель LQM21 - 4,7 мкГн - 80 мА - 0805 |  |  |  |  |  |  |  |  |  |  |  |  |  |  | LQM21FN4R7N | 1 | шт
│ | │ | │ | │ | ├ | Дроссель двухобмоточный 200 мкГн - Ethernet |  |  |  |  |  |  |  |  |  |  |  |  |  |  | ACT45L-201-2P-TL000 | 8 | шт
│ | │ | │ | │ | ├ | Дроссель двухобмоточный 90 Ом - 330 мА |  |  |  |  |  |  |  |  |  |  |  |  |  |  | DLW21SN900SQ2 | 1 | шт
│ | │ | │ | │ | ├ | Дроссель двухобмоточный 2х250 мкГн - 1,2 А - 80 В |  |  |  |  |  |  |  |  |  |  |  |  |  |  | SRF0905-251Y | 3 | шт
│ | │ | │ | │ | ├ | Дроссель двухобмоточный 350 Ом - 2,0 А - 50 В |  |  |  |  |  |  |  |  |  |  |  |  |  |  | DLW5BSN351SQ2L | 1 | шт
│ | │ | │ | │ | ├ | Дроссель двухобмоточный 190 Ом - 5,0 А - 50 В |  |  |  |  |  |  |  |  |  |  |  |  |  |  | DLW5BSN191SQ2L | 1 | шт
│ | │ | │ | │ | ├ | Дроссель LQM21 - 10 мкГн - 0,1 А - 0805 |  |  |  |  |  |  |  |  |  |  |  |  |  |  | LQM21FN100M70L | 2 | шт
│ | │ | │ | │ | ├ | Дроссель LQH32 - 10 мкГн - 0,3 А |  |  |  |  |  |  |  |  |  |  |  |  |  |  | LQH32CN100K23L | 2 | шт
│ | │ | │ | │ | ├ | Индуктивность 100 мкГн - 2,1 А - 20 % - SMD |  |  |  |  |  |  |  |  |  |  |  |  |  |  | CDRH127-LDNP-101MC | 2 | шт
│ | │ | │ | │ | ├ | Дроссель PLY10AN1521R6R2 |  |  |  |  |  |  |  |  |  |  |  |  |  |  | PLY10AN1521R6R2 | 1 | шт
│ | │ | │ | │ | ├ | Кварцевый резонатор KX-9A, 8,000 МГц, SMD |  |  |  |  |  |  |  |  |  |  |  |  |  |  | KX-9A | 1 | шт
│ | │ | │ | │ | ├ | Чип резистор 2,2 кОм - 0,25 Вт - 5% - 1206 |  |  |  |  |  |  |  |  |  |  |  |  |  |  | RC1206JR-0712K2L | 10 | шт
│ | │ | │ | │ | ├ | Чип резистор 1,2 кОм - 0,25 Вт - 5% - 1206 |  |  |  |  |  |  |  |  |  |  |  |  |  |  | RC1206JR-071K2L | 6 | шт
│ | │ | │ | │ | ├ | Чип резистор 4,7 кОм - 0,25 Вт - 5% - 1206 |  |  |  |  |  |  |  |  |  |  |  |  |  |  | RC1206JR-074K7L | 6 | шт
│ | │ | │ | │ | ├ | Чип резистор 680 Ом - 0,125 Вт - 5% - 0805 |  |  |  |  |  |  |  |  |  |  |  |  |  |  | RC0805JR-07680RL | 14 | шт
│ | │ | │ | │ | ├ | Чип резистор 180 Ом - 0,125 Вт - 5% - 0805 |  |  |  |  |  |  |  |  |  |  |  |  |  |  | RC0805JR-07180RL | 9 | шт
│ | │ | │ | │ | ├ | Чип резистор 300 Ом - 0,125 Вт - 1% - 0805 |  |  |  |  |  |  |  |  |  |  |  |  |  |  | RC0805FR-07300RL | 1 | шт
│ | │ | │ | │ | ├ | Чип резистор 2,7 кОм - 0,125 Вт - 1% - 0805 |  |  |  |  |  |  |  |  |  |  |  |  |  |  | RC0805FR-072K7L | 1 | шт
│ | │ | │ | │ | ├ | Чип резистор 10 кОм - 0,125 Вт - 5% - 0805 |  |  |  |  |  |  |  |  |  |  |  |  |  |  | RC0805JR-0710KL | 5 | шт
│ | │ | │ | │ | ├ | Чип резистор 10,0 кОм - 0,125 Вт - 1% - 0805 |  |  |  |  |  |  |  |  |  |  |  |  |  |  | RC0805FR-0710KL | 4 | шт
│ | │ | │ | │ | ├ | Чип резистор 100 Ом - 0,125 Вт - 5% - 0805 |  |  |  |  |  |  |  |  |  |  |  |  |  |  | RC0805JR-07100RL | 3 | шт
│ | │ | │ | │ | ├ | Чип резистор 510 Ом - 0,125 Вт - 5% - 0805 |  |  |  |  |  |  |  |  |  |  |  |  |  |  | RC0805JR-07510RL | 1 | шт
│ | │ | │ | │ | ├ | Резистор С1-4 - 0,5 Вт - 5% - 300 Ом |  |  |  |  |  |  |  |  |  |  |  |  |  |  | CF-50 (С1-4) 0.5 Вт, 300 Ом | 1 | шт
│ | │ | │ | │ | ├ | Резистор С1-4 - 0,5 Вт - 5% - 30 кОм |  |  |  |  |  |  |  |  |  |  |  |  |  |  | CF-50 (С1-4) 0.5 Вт, 30 кОм | 1 | шт
│ | │ | │ | │ | ├ | Резистор С1-4 - 0,5 Вт - 5% - 39 Ом |  |  |  |  |  |  |  |  |  |  |  |  |  |  | CF-50 (С1-4) 0.5 Вт, 39 Ом | 1 | шт
│ | │ | │ | │ | ├ | Резистор проволочный SQP 100 кОм - 5Вт - 5% |  |  |  |  |  |  |  |  |  |  |  |  |  |  | SQP5-100K | 2 | шт
│ | │ | │ | │ | ├ | Чип резистор 4,7 кОм - 0,125 Вт - 5 % - 0805 |  |  |  |  |  |  |  |  |  |  |  |  |  |  | RC0805JR-074K7L | 2 | шт
│ | │ | │ | │ | ├ | Чип резистор 1,0 кОм - 0,125 Вт - 5 % - 0805 |  |  |  |  |  |  |  |  |  |  |  |  |  |  | RC0805JR-071KL | 5 | шт
│ | │ | │ | │ | ├ | Чип резистор 330 Ом - 0,125 Вт - 5% - 0805 |  |  |  |  |  |  |  |  |  |  |  |  |  |  | RC0805JR-07330RL | 1 | шт
│ | │ | │ | │ | ├ | Чип резистор 324 Ом - 0,125 Вт - 1% - 0805 |  |  |  |  |  |  |  |  |  |  |  |  |  |  | RC0805FR-07324RL | 1 | шт
│ | │ | │ | │ | ├ | Чип резистор 100 кОм - 0,125 Вт - 5% - 0805 |  |  |  |  |  |  |  |  |  |  |  |  |  |  | RC0805JR-07100KL | 2 | шт
│ | │ | │ | │ | ├ | Чип резистор 536 Ом - 0,125 Вт - 1% - 0805 |  |  |  |  |  |  |  |  |  |  |  |  |  |  | RC0805FR-07536RL | 1 | шт
│ | │ | │ | │ | ├ | Чип резистор 0,1 Ом - 1,0 Вт - 1% - 2512 |  |  |  |  |  |  |  |  |  |  |  |  |  |  | RL2512FK-070R1L | 2 | шт
│ | │ | │ | │ | ├ | Чип резистор 120 Ом - 0,125 Вт - 5% - 0805 |  |  |  |  |  |  |  |  |  |  |  |  |  |  | RC0805JR-07120RL | 1 | шт
│ | │ | │ | │ | ├ | Чип резистор 560 Ом - 0,125 Вт - 5% - 0805 |  |  |  |  |  |  |  |  |  |  |  |  |  |  | RC0805JR-07560RL | 2 | шт
│ | │ | │ | │ | ├ | Чип резистор 2,2 кОм - 0,125 Вт - 5% - 0805 |  |  |  |  |  |  |  |  |  |  |  |  |  |  | RC0805JR-072K2L | 2 | шт
│ | │ | │ | │ | ├ | Чип резистор 1,0 МОм - 0,125 Вт - 5 % - 0805 |  |  |  |  |  |  |  |  |  |  |  |  |  |  | RC0805JR-071ML | 1 | шт
│ | │ | │ | │ | ├ | Чип резистор 1,2 кОм - 0,125 Вт - 5 % - 0805 |  |  |  |  |  |  |  |  |  |  |  |  |  |  | RC0805JR-071K2L | 2 | шт
│ | │ | │ | │ | ├ | Чип резистор 100 кОм - 0,125 Вт - 1% - 0805 |  |  |  |  |  |  |  |  |  |  |  |  |  |  | RC0805FR-07100KL | 2 | шт
│ | │ | │ | │ | ├ | Чип резистор 2,7 кОм - 0,125 Вт - 5% - 0805 |  |  |  |  |  |  |  |  |  |  |  |  |  |  | RC0805JR-072K7L | 1 | шт
│ | │ | │ | │ | ├ | Чип резистор 3,3 кОм - 0,125 Вт - 1% - 0805 |  |  |  |  |  |  |  |  |  |  |  |  |  |  | RC0805FR-073K3L | 1 | шт
│ | │ | │ | │ | ├ | Чип резистор 51 Ом - 0,125 Вт - 5% - 0805 |  |  |  |  |  |  |  |  |  |  |  |  |  |  | RC0805JR-0751RL | 1 | шт
│ | │ | │ | │ | ├ | Чип резистор 1 кОм - 0,25 Вт - 5% - 1206 |  |  |  |  |  |  |  |  |  |  |  |  |  |  | RC1206JR-071KL | 12 | шт
│ | │ | │ | │ | ├ | Чип резистор 270 Ом - 0,25 Вт - 5% - 1206 |  |  |  |  |  |  |  |  |  |  |  |  |  |  | RC1206JR-07270RL | 2 | шт
│ | │ | │ | │ | ├ | Диод SM24-02HTG, SOT-23 |  |  |  |  |  |  |  |  |  |  |  |  |  |  | SM24-02HTG, SOT-23 | 15 | шт
│ | │ | │ | │ | ├ | Мост диодный DB207, DB-S |  |  |  |  |  |  |  |  |  |  |  |  |  |  | DB207, DB-S | 1 | шт
│ | │ | │ | │ | ├ | Диод US1M, SMA |  |  |  |  |  |  |  |  |  |  |  |  |  |  | US1M, SMA | 2 | шт
│ | │ | │ | │ | ├ | Диод SM712.TCT, SOT-23 |  |  |  |  |  |  |  |  |  |  |  |  |  |  | SM712.TCT, SOT-23 | 1 | шт
│ | │ | │ | │ | ├ | Симистор BTA12-600SWRG, TO-220-3 |  |  |  |  |  |  |  |  |  |  |  |  |  |  | BTA12-600SWRG, TO-220-3 | 1 | шт
│ | │ | │ | │ | ├ | Транзистор BC847С, SOT-23 |  |  |  |  |  |  |  |  |  |  |  |  |  |  | BC847С, SOT-23 | 9 | шт
│ | │ | │ | │ | ├ | Транзистор BCR533, SOT-23 |  |  |  |  |  |  |  |  |  |  |  |  |  |  | BCR533, SOT-23 | 1 | шт
│ | │ | │ | │ | ├ | Транзистор BC857С, SOT-23 |  |  |  |  |  |  |  |  |  |  |  |  |  |  | BC857С, SOT-23 | 1 | шт
│ | │ | │ | │ | ├ | Транзистор TIP142, TO-247 |  |  |  |  |  |  |  |  |  |  |  |  |  |  | TIP142, TO-247 | 1 | шт
│ | │ | │ | │ | ├ | Транзистор STD65N55F3, D-PAK |  |  |  |  |  |  |  |  |  |  |  |  |  |  | STD65N55F3 | 1 | шт
│ | │ | │ | │ | ├ | Разъем на плату Mini-SPOX PCB Header 10 Circuits |  |  |  |  |  |  |  |  |  |  |  |  |  |  | 22035105 | 1 | шт | MOLEX | https://www.molex.com/molex/products/part-detail/pcb_headers/0022035105
│ | │ | │ | │ | ├ | Разъем на плату Mini-SPOX PCB Header 3 Circuits |  |  |  |  |  |  |  |  |  |  |  |  |  |  | 22035035 | 8 | шт | MOLEX | https://www.molex.com/molex/products/part-detail/pcb_headers/0022035035
│ | │ | │ | │ | ├ | Разъем на плату Mini-SPOX PCB Header 2 Circuits |  |  |  |  |  |  |  |  |  |  |  |  |  |  | 22035025 | 5 | шт | MOLEX | https://www.molex.com/molex/products/part-detail/pcb_headers/0022035025
│ | │ | │ | │ | ├ | Разъем на плату Mini-SPOX PCB Header 5 Circuits |  |  |  |  |  |  |  |  |  |  |  |  |  |  | 22035055 | 4 | шт | MOLEX | https://www.molex.com/molex/products/part-detail/pcb_headers/0022035055
│ | │ | │ | │ | ├ | Вилка на плату 15EDGVC-3.81-03P-14-00A(H) |  |  |  |  |  |  |  |  |  |  |  |  |  |  | 15EDGVC-3.81-03P-14-00A(H) | 1 | шт
│ | │ | │ | │ | ├ | Вилка на плату 5EHDV-02P |  |  |  |  |  |  |  |  |  |  |  |  |  |  | 5EHDV-02P | 4 | шт
│ | │ | │ | │ | ├ | Вилка на плату PLL1.27-5S |  |  |  |  |  |  |  |  |  |  |  |  |  |  | PLL1.27-5S | 1 | шт
│ | │ | │ | │ | └ | Клемма винтовая на плату K13, M4 - DEGSON |  |  |  |  |  |  |  |  |  |  |  |  |  |  | K13-M4 screw | 1 | шт
│ | │ | │ | ├ | Основание |  |  |  |  |  |  |  |  |  |  |  |  |  |  |  | АЕЖР-01.01.02.001 | 1 | шт
│ | │ | │ | │ | ├ | Винт М5х16 Din 7985 |  |  |  |  |  |  |  |  |  |  |  |  |  |  |  | 4 | шт
│ | │ | │ | │ | ├ | Шайба 5 Din 125 |  |  |  |  |  |  |  |  |  |  |  |  |  |  |  | 4 | шт
│ | │ | │ | │ | └ | Шайба 5 Din 127 |  |  |  |  |  |  |  |  |  |  |  |  |  |  |  | 4 | шт
│ | │ | │ | ├ | Винт М3х12 Din 7985 - Zn |  |  |  |  |  |  |  |  |  |  |  |  |  |  |  |  | 9 | шт
│ | │ | │ | ├ | Винт М4х12 Din 965 - Zn |  |  |  |  |  |  |  |  |  |  |  |  |  |  |  |  | 1 | шт
│ | │ | │ | ├ | Винт М3х12 Din 965 - Zn |  |  |  |  |  |  |  |  |  |  |  |  |  |  |  |  | 1 | шт
│ | │ | │ | ├ | Гайка М3 Din 934 - Zn |  |  |  |  |  |  |  |  |  |  |  |  |  |  |  |  | 4 | шт
│ | │ | │ | ├ | Шайба 3.2 Din 125 - Zn |  |  |  |  |  |  |  |  |  |  |  |  |  |  |  |  | 13 | шт
│ | │ | │ | ├ | Шайба 3 Din 127 - Zn |  |  |  |  |  |  |  |  |  |  |  |  |  |  |  |  | 13 | шт
│ | │ | │ | ├ | PCHSN-10, Стойка для печатных плат 10mm М3, латунь, шестигранная |  |  |  |  |  |  |  |  |  |  |  |  |  |  |  |  | 4 | шт
│ | │ | │ | ├ | Блок питания 220 В - 24 В - 4,2 А - ECS100US24-B XPPower |  |  |  |  |  |  |  |  |  |  |  |  |  |  |  | ECS100US24-B | 1 | шт |  |  |  | 4397.26 ₽ |  | Либо XP Power ECM100US24 в случае невозможности заказа
│ | │ | │ | └ | Площадка монтажная ПМО 15х10 (Fortisflex) |  |  |  |  |  |  |  |  |  |  |  |  |  |  |  | 62452 | 6 | шт
│ | │ | ├ | Энкодер оптический |  |  |  |  |  |  |  |  |  |  |  |  |  |  |  |  | АЕЖР.468157.501 | 1 | шт
│ | │ | │ | ├ | Основание |  |  |  |  |  |  |  |  |  |  |  |  |  |  |  | АЕЖР-01.01.13.001 | 1 | шт
│ | │ | │ | ├ | Стойки |  |  |  |  |  |  |  |  |  |  |  |  |  |  |  |  | 4 | шт
│ | │ | │ | └ | Плата энкодера оптического (Печатный узел) |  |  |  |  |  |  |  |  |  |  |  |  |  |  |  | АЕЖР.468157.001-03 | 1 | шт
│ | │ | │ |  | ├ | Плата энкодера оптического ПП |  |  |  |  |  |  |  |  |  |  |  |  |  |  | АЕЖР.687252.009-03 | 1 | шт
│ | │ | │ |  | ├ | Тант. ЧИП конденсатор 10 мкФ - 50 В - тип D |  |  |  |  |  |  |  |  |  |  |  |  |  |  | TR3D106K050D0700 | 1 | шт
│ | │ | │ |  | ├ | Оптопара щелевая TCST1202 |  |  |  |  |  |  |  |  |  |  |  |  |  |  | TCST1202 | 1 | шт
│ | │ | │ |  | ├ | Микросхема TLV172IDBVR (TLV172IDBVT), SOT-23-5 |  |  |  |  |  |  |  |  |  |  |  |  |  |  | TLV172IDBV, SOT-23-5 | 1 | шт |  |  |  |  |  | замена старой OPA244NA, SOT-23-5
│ | │ | │ |  | ├ | Чип резистор 1 кОм - 0,75 Вт - 5% - 2010 |  |  |  |  |  |  |  |  |  |  |  |  |  |  | RC2010JK-071KL | 1 | шт
│ | │ | │ |  | ├ | Чип резистор 5,1 кОм - 0,125 Вт - 5% - 0805 |  |  |  |  |  |  |  |  |  |  |  |  |  |  | RC0805JR-075K1L | 1 | шт
│ | │ | │ |  | ├ | Чип резистор 7,68 кОм - 0,125 Вт - 1% - 0805 |  |  |  |  |  |  |  |  |  |  |  |  |  |  | RC0805FR-077K68L | 1 | шт
│ | │ | │ |  | ├ | Чип резистор 5,1 кОм - 0,125 Вт - 1% - 0805 |  |  |  |  |  |  |  |  |  |  |  |  |  |  | RC0805FR-075K1L | 2 | шт
│ | │ | │ |  | ├ | Чип резистор 22 кОм - 0,125 Вт - 5% - 0805 |  |  |  |  |  |  |  |  |  |  |  |  |  |  | RC0805JR-0722KL | 1 | шт
│ | │ | │ |  | ├ | Чип резистор 2,7 кОм - 0,125 Вт - 5% - 0805 |  |  |  |  |  |  |  |  |  |  |  |  |  |  | RC0805JR-072K7L | 1 | шт
│ | │ | │ |  | ├ | Транзистор BC817-40, SOT-23 |  |  |  |  |  |  |  |  |  |  |  |  |  |  | BC817-40, SOT-23 | 1 | шт
│ | │ | │ |  | └ | Разъем на плату Mini-SPOX PCB Header 4 Circuits |  |  |  |  |  |  |  |  |  |  |  |  |  |  | 22035045 | 1 | шт | MOLEX | https://www.molex.com/molex/products/part-detail/pcb_headers/0022035045
│ | │ | ├ | Кабель соединительный вилка блочная - клеммы проходные |  |  |  |  |  |  |  |  |  |  |  |  |  |  |  |  | АЕЖР.685631.124 | 1 | шт
│ | │ | │ | ├ | Наконечник кабельный НШВИ 1.5-8 (КВТ) |  |  |  |  |  |  |  |  |  |  |  |  |  |  |  | НШВИ 1.5-8 (КВТ) | 3 | шт
│ | │ | │ | ├ | Вилка блочная FQ24-4ZJ-S, 3p, 400 В, 10 А |  |  |  |  |  |  |  |  |  |  |  |  |  |  |  |  | 1 | шт |  |  |  |  |  | Разъем питания сетевой
│ | │ | │ | ├ | Провод ПВ-3 1.5 мм2 Красный |  |  |  |  |  |  |  |  |  |  |  |  |  |  |  |  | 0.25 | м
│ | │ | │ | ├ | Провод ПВ-3 1.5 мм2 Синий |  |  |  |  |  |  |  |  |  |  |  |  |  |  |  |  | 0.25 | м
│ | │ | │ | ├ | Провод ПВ-3 1.5 мм2 Желтый |  |  |  |  |  |  |  |  |  |  |  |  |  |  |  |  | 0.25 | м
│ | │ | │ | ├ | ТУТнг-16/8 (КВТ) Черный |  |  |  |  |  |  |  |  |  |  |  |  |  |  |  |  | 0.16 | м
│ | │ | │ | └ | ТУТнг-4/2 (КВТ) Черный |  |  |  |  |  |  |  |  |  |  |  |  |  |  |  |  | 0.1 | м
│ | │ | ├ | Кабель соединительный клеммы проходные-Блок питания 220В-24В-4,2 А ECS100US24-B XPPower |  |  |  |  |  |  |  |  |  |  |  |  |  |  |  |  | АЕЖР.685631.125 | 1 | шт
│ | │ | │ | ├ | Розетка на кабель PHU-3 (DS1072-3 F) |  |  |  |  |  |  |  |  |  |  |  |  |  |  |  | PHU-3 (DS1072-3 F) | 1 | шт
│ | │ | │ | ├ | Наконечник кабельный НШВИ 1.5-8 (КВТ) |  |  |  |  |  |  |  |  |  |  |  |  |  |  |  | НШВИ 1.5-8 (КВТ) | 2 | шт
│ | │ | │ | ├ | Провод ПВ-3 1.5 мм2 Красный |  |  |  |  |  |  |  |  |  |  |  |  |  |  |  |  | 0.65 | м
│ | │ | │ | ├ | Провод ПВ-3 1.5 мм2 Синий |  |  |  |  |  |  |  |  |  |  |  |  |  |  |  |  | 0.65 | м
│ | │ | │ | └ | ТУТнг-8/4 (КВТ) Черный |  |  |  |  |  |  |  |  |  |  |  |  |  |  |  |  | 0.58 | м
│ | │ | ├ | Жгут соединительный система управления АЕЖР (Х19)- розетка блочная(Х4)- блок питания |  |  |  |  |  |  |  |  |  |  |  |  |  |  |  |  | АЕЖР.685621.032 | 1 | шт
│ | │ | │ | ├ | Розетка на кабель 2EDGK-5.0-02P-14-00A(H) |  |  |  |  |  |  |  |  |  |  |  |  |  |  |  | 2EDGK-5.0-02P-14-00A(H) | 1 | шт
│ | │ | │ | ├ | Розетка на кабель PHU-4 (DS1072-4 F) |  |  |  |  |  |  |  |  |  |  |  |  |  |  |  | PHU-4 (DS1072-4 F) | 1 | шт
│ | │ | │ | ├ | Наконечник кабельный НШВИ 1.5-8 (КВТ) |  |  |  |  |  |  |  |  |  |  |  |  |  |  |  | НШВИ 1.5-8 (КВТ) | 2 | шт
│ | │ | │ | ├ | Провод ПВ-3 1.5 мм2 Красный |  |  |  |  |  |  |  |  |  |  |  |  |  |  |  |  | 1.4 | м
│ | │ | │ | ├ | Провод ПВ-3 1.5 мм2 Синий |  |  |  |  |  |  |  |  |  |  |  |  |  |  |  |  | 1.4 | м
│ | │ | │ | └ | ТУТнг-8/4 (КВТ) Черный |  |  |  |  |  |  |  |  |  |  |  |  |  |  |  |  | 1.2 | м
│ | │ | ├ | Кабель соединительный реле с колодкой 24v DC(А2-А1)- система управления АЕЖР (Х11) |  |  |  |  |  |  |  |  |  |  |  |  |  |  |  |  | АЕЖР.685631.133 | 1 | шт
│ | │ | │ | ├ | Розетка кабельная Mini-SPOX 2 Circuits |  |  |  |  |  |  |  |  |  |  |  |  |  |  |  | 50375023 | 1 | шт | MOLEX | https://www.molex.com/molex/products/part-detail/crimp_housings/0050375023 |  | 2.50 ₽
│ | │ | │ | ├ | Mini-SPOX Female Crimp Terminal, 22-28 AWG, Reel |  |  |  |  |  |  |  |  |  |  |  |  |  |  |  | 08701039 | 2 | шт | MOLEX | https://www.molex.com/molex/search/partSearch?pQuery=&sType=s&query=5263
│ | │ | │ | ├ | Наконечник кабельный НШВИ 0.5-8 (КВТ) |  |  |  |  |  |  |  |  |  |  |  |  |  |  |  | НШВИ 0.5-8 (КВТ) | 2 | шт
│ | │ | │ | ├ | Провод ПВ-3 0.5 мм2 Красный |  |  |  |  |  |  |  |  |  |  |  |  |  |  |  |  | 0.75 | м
│ | │ | │ | ├ | Провод ПВ-3 0.5 мм2 Синий |  |  |  |  |  |  |  |  |  |  |  |  |  |  |  |  | 0.75 | м
│ | │ | │ | └ | ТУТнг-6/3 (КВТ) Черный |  |  |  |  |  |  |  |  |  |  |  |  |  |  |  |  | 0.65 | м
│ | │ | ├ | Кабель соединительный плата системы разгрузки(Х3) - led индикатор |  |  |  |  |  |  |  |  |  |  |  |  |  |  |  |  | АЕЖР.685631.135 | 1 | шт
│ | │ | │ | ├ | Розетка на кабель 2p, 300В, 8А, 3.81мм |  |  |  |  |  |  |  |  |  |  |  |  |  |  |  | 15EDGK-3.81-02P-14-00A(H) | 1 | шт | DEGSON |  |  | 83.16 ₽
│ | │ | │ | ├ | Наконечник кабельный НШВИ 0.5-8 (КВТ) |  |  |  |  |  |  |  |  |  |  |  |  |  |  |  | НШВИ 0.5-8 (КВТ) | 2 | шт
│ | │ | │ | ├ | Индикатор блочный |  |  |  |  |  |  |  |  |  |  |  |  |  |  |  | 19210000 | 1 | шт | CML | https://www.elitan.ru/price/item9471140 |  | 630.89 ₽
│ | │ | │ | ├ | Провод ПВ-3 0.5 мм2 Красный |  |  |  |  |  |  |  |  |  |  |  |  |  |  |  |  | 0.5 | м
│ | │ | │ | ├ | Провод ПВ-3 0.5 мм2 Синий |  |  |  |  |  |  |  |  |  |  |  |  |  |  |  |  | 0.5 | м
│ | │ | │ | └ | ТУТнг-6/3 (КВТ) Черный |  |  |  |  |  |  |  |  |  |  |  |  |  |  |  |  | 0.45 | м
│ | │ | ├ | Кабель соединительный система управления АЕЖР (Х13)- клеммы проходные |  |  |  |  |  |  |  |  |  |  |  |  |  |  |  |  | АЕЖР.685631.138 | 1 | шт
│ | │ | │ | ├ | Розетка на кабель 2EDGK-5.0-02P-14-00A(H) |  |  |  |  |  |  |  |  |  |  |  |  |  |  |  | 2EDGK-5.0-02P-14-00A(H) | 1 | шт
│ | │ | │ | ├ | Наконечник кабельный НШВИ 1-8 (КВТ) |  |  |  |  |  |  |  |  |  |  |  |  |  |  |  | НШВИ 1.5-8 (КВТ) | 4 | шт
│ | │ | │ | ├ | Провод ПВ-3 1 мм2 Красный |  |  |  |  |  |  |  |  |  |  |  |  |  |  |  |  | 0.6 | м
│ | │ | │ | ├ | Провод ПВ-3 1 мм2 Синий |  |  |  |  |  |  |  |  |  |  |  |  |  |  |  |  | 0.6 | м
│ | │ | │ | └ | ТУТнг-6/3 (КВТ) Черный |  |  |  |  |  |  |  |  |  |  |  |  |  |  |  |  | 0.55 | м
│ | │ | ├ | Кабель соединительный плата системы разгрузки (Х2) - розетка блочная (Х7) |  |  |  |  |  |  |  |  |  |  |  |  |  |  |  |  | АЕЖР.685631.139 | 1 | шт
│ | │ | │ | ├ | Розетка на кабель 2p, 300В, 8А, 3.81мм |  |  |  |  |  |  |  |  |  |  |  |  |  |  |  | 15EDGK-3.81-02P-14-00A(H) | 1 | шт | DEGSON |  |  | 83.16 ₽
│ | │ | │ | ├ | Наконечник кабельный НШВИ 1.5-8 (КВТ) |  |  |  |  |  |  |  |  |  |  |  |  |  |  |  | НШВИ 1.5-8 (КВТ) | 2 | шт
│ | │ | │ | ├ | Розетка блочная FQ18-4ZK-S, 4p, 400В, 10А |  |  |  |  |  |  |  |  |  |  |  |  |  |  |  | FQ18-4ZK-S | 1 | шт | Dafa | http://www.rct.ru/warehouse/80004122/80006219.html |  | 218.00 ₽ |  | Система разгрузки
│ | │ | │ | ├ | Провод ПВ-3 1.5 мм2 Красный |  |  |  |  |  |  |  |  |  |  |  |  |  |  |  |  | 1 | м
│ | │ | │ | ├ | Провод ПВ-3 1.5 мм2 Синий |  |  |  |  |  |  |  |  |  |  |  |  |  |  |  |  | 1 | м
│ | │ | │ | ├ | ТУТнг-8/4 (КВТ) Черный |  |  |  |  |  |  |  |  |  |  |  |  |  |  |  |  | 0.9 | м
│ | │ | │ | └ | ТУТнг-3/1.5 (КВТ) Черный |  |  |  |  |  |  |  |  |  |  |  |  |  |  |  |  | 0.1 | м
│ | │ | ├ | Жгут соединительный система управления АЕЖР (Х1)- розетка блочная(Х8)- плата системы разгрузки(Х4) |  |  |  |  |  |  |  |  |  |  |  |  |  |  |  |  | АЕЖР.685621.034 | 1 | шт
│ | │ | │ | ├ | Розетка на кабель 3p, 300В, 8А, 3.81мм |  |  |  |  |  |  |  |  |  |  |  |  |  |  |  | 15EDGK-3.81-03P-14-00A(H) | 1 | шт | DEGSON |  |  | 17.71 ₽
│ | │ | │ | ├ | Розетка кабельная Mini-SPOX 10 Circuits |  |  |  |  |  |  |  |  |  |  |  |  |  |  |  | 50375103 | 1 | шт | MOLEX | https://www.molex.com/molex/products/part-detail/crimp_housings/0050375103 |  | 1.13 ₽
│ | │ | │ | ├ | Mini-SPOX Female Crimp Terminal, 22-28 AWG, Reel |  |  |  |  |  |  |  |  |  |  |  |  |  |  |  | 08701039 | 10 | шт | MOLEX | https://www.molex.com/molex/search/partSearch?pQuery=&sType=s&query=5263
│ | │ | │ | ├ | Наконечник кабельный НШВИ 0.5-8 (КВТ) |  |  |  |  |  |  |  |  |  |  |  |  |  |  |  | НШВИ 0.5-8 (КВТ) | 2 | шт
│ | │ | │ | ├ | Наконечник кабельный НШВИ 1-8 (КВТ) |  |  |  |  |  |  |  |  |  |  |  |  |  |  |  | НШВИ 1-8 (КВТ) | 1 | шт
│ | │ | │ | ├ | Провод ПВ-3 0.5 мм2 Черный |  |  |  |  |  |  |  |  |  |  |  |  |  |  |  |  | 5.8 | м
│ | │ | │ | ├ | Провод ПВ-3 0.5 мм2 Красный |  |  |  |  |  |  |  |  |  |  |  |  |  |  |  |  | 1 | м
│ | │ | │ | ├ | Провод ПВ-3 0.5 мм2 Синий |  |  |  |  |  |  |  |  |  |  |  |  |  |  |  |  | 1.4 | м
│ | │ | │ | ├ | ТУТнг-8/4 (КВТ) Черный |  |  |  |  |  |  |  |  |  |  |  |  |  |  |  |  | 1 | м
│ | │ | │ | ├ | ТУТнг-10/5 (КВТ) Черный |  |  |  |  |  |  |  |  |  |  |  |  |  |  |  |  | 0.7 | м
│ | │ | │ | └ | ТУТнг-3/1.5 (КВТ) Черный |  |  |  |  |  |  |  |  |  |  |  |  |  |  |  |  | 0.6 | м
│ | │ | ├ | Кабель соединительный система управления АЕЖР (Х8, х18)- розетка блочная |  |  |  |  |  |  |  |  |  |  |  |  |  |  |  |  | АЕЖР.685631.140 | 1 | шт
│ | │ | │ | ├ | Розетка кабельная Mini-SPOX 5 Circuits |  |  |  |  |  |  |  |  |  |  |  |  |  |  |  | 50375053 | 1 | шт | MOLEX | https://www.molex.com/molex/products/part-detail/crimp_housings/0050375053 |  | 4.17 ₽
│ | │ | │ | ├ | Розетка кабельная Mini-SPOX 3 Circuits |  |  |  |  |  |  |  |  |  |  |  |  |  |  |  | 50375033 | 1 | шт | MOLEX | https://www.molex.com/molex/products/part-detail/crimp_housings/0050375033 |  | 3.33 ₽
│ | │ | │ | ├ | Mini-SPOX Female Crimp Terminal, 22-28 AWG, Reel |  |  |  |  |  |  |  |  |  |  |  |  |  |  |  | 08701039 | 8 | шт | MOLEX | https://www.molex.com/molex/search/partSearch?pQuery=&sType=s&query=5263
│ | │ | │ | ├ | Розетка блочная 6к |  |  |  |  |  |  |  |  |  |  |  |  |  |  |  | FQ18-6ZK-S | 1 | шт | Dafa |  |  | 154.00 ₽ |  | Графическая панель ХМИ
│ | │ | │ | ├ | Провод ПВ-3 0.5 мм2 Красный |  |  |  |  |  |  |  |  |  |  |  |  |  |  |  |  | 1 | м
│ | │ | │ | ├ | Провод ПВ-3 0.5 мм2 Синий |  |  |  |  |  |  |  |  |  |  |  |  |  |  |  |  | 1 | м
│ | │ | │ | ├ | Провод ПВ-3 0.5 мм2 Желтый |  |  |  |  |  |  |  |  |  |  |  |  |  |  |  |  | 0.65 | м
│ | │ | │ | ├ | ТУТнг-6/3 (КВТ) Черный |  |  |  |  |  |  |  |  |  |  |  |  |  |  |  |  | 0.3 | м
│ | │ | │ | ├ | ТУТнг-8/4 (КВТ) Черный |  |  |  |  |  |  |  |  |  |  |  |  |  |  |  |  | 0.6 | м
│ | │ | │ | └ | ТУТнг-3/1.5 (КВТ) Черный |  |  |  |  |  |  |  |  |  |  |  |  |  |  |  |  | 0.2 | м
│ | │ | ├ | Провод заземления блок питания (Х3) - клемма проходная |  |  |  |  |  |  |  |  |  |  |  |  |  |  |  |  | АЕЖР.685611.048 | 1 | шт
│ | │ | │ | ├ | Клемма ножевая РПИ-М 2.5-(4.8) (КВТ) |  |  |  |  |  |  |  |  |  |  |  |  |  |  |  | РПИ-М 2.5-(4.8) (КВТ) | 1 | шт | КВТ |  |  | 5.00 ₽
│ | │ | │ | ├ | Наконечник кабельный НШВИ 1.5-8 (КВТ) |  |  |  |  |  |  |  |  |  |  |  |  |  |  |  | НШВИ 1.5-8 (КВТ) | 1 | шт
│ | │ | │ | └ | Провод ПВ-3 1.5 мм2 Желтый |  |  |  |  |  |  |  |  |  |  |  |  |  |  |  |  | 0.8 | м
│ | │ | ├ | Провод заземления система управления (х29) - клемма проходная |  |  |  |  |  |  |  |  |  |  |  |  |  |  |  |  | АЕЖР.685611.049 | 1 | шт
│ | │ | │ | ├ | Клемма кабельная НКИ 2.5-5 (КВТ) |  |  |  |  |  |  |  |  |  |  |  |  |  |  |  | НКИ 2.5-5 (КВТ) | 1 | шт | КВТ |  |  | 20.00 ₽
│ | │ | │ | ├ | Наконечник кабельный НШВИ 1.5-8 (КВТ) |  |  |  |  |  |  |  |  |  |  |  |  |  |  |  | НШВИ 1.5-8 (КВТ) | 1 | шт
│ | │ | │ | └ | Провод ПВ-3 1.5 мм2 Желтый |  |  |  |  |  |  |  |  |  |  |  |  |  |  |  |  | 0.7 | м
│ | │ | ├ | Провод заземления болт заземления - клемма проходная |  |  |  |  |  |  |  |  |  |  |  |  |  |  |  |  | АЕЖР.685611.050 | 1 | шт
│ | │ | │ | ├ | Клемма кабельная НКИ 6.0-6 (КВТ) |  |  |  |  |  |  |  |  |  |  |  |  |  |  |  | НКИ 6.0-6 (КВТ) | 1 | шт | КВТ |  |  | 13.00 ₽
│ | │ | │ | ├ | Наконечник кабельный НШВИ 1.5-8 (КВТ) |  |  |  |  |  |  |  |  |  |  |  |  |  |  |  | НШВИ 1.5-8 (КВТ) | 1 | шт
│ | │ | │ | └ | Провод ПВ-3 1.5 мм2 Желтый |  |  |  |  |  |  |  |  |  |  |  |  |  |  |  |  | 0.2 | м
│ | │ | ├ | Модификация наконечников актуатора LA31-6000N24V-4.3A-LINAK |  |  |  |  |  |  |  |  |  |  |  |  |  |  |  |  | АЕЖР.483219.001 | 1 | шт
│ | │ | │ | ├ | Розетка на кабель 2p, 300В, 8А, 3.81мм |  |  |  |  |  |  |  |  |  |  |  |  |  |  |  | 15EDGK-3.81-02P-14-00A(H) | 1 | шт | DEGSON |  |  | 83.16 ₽
│ | │ | │ | ├ | Наконечник кабельный НШВИ 1.5-8 (КВТ) |  |  |  |  |  |  |  |  |  |  |  |  |  |  |  | НШВИ 1.5-8 (КВТ) | 2 | шт
│ | │ | │ | └ | Актуатор LA31 - 6000 N - 24 V - 4,3A (ход 250мм) |  |  |  |  |  |  |  |  |  |  |  |  |  |  |  | LA310302500000В4-2220004230СS000 | 1 | шт | LINAK |  |  | 5021.00 ₽
│ | │ | ├ | Кабель соединительный реле с колодкой 24V DC- система управления АЕЖР (Х10) |  |  |  |  |  |  |  |  |  |  |  |  |  |  |  |  | АЕЖР.685631.126 | 1 | шт
│ | │ | │ | ├ | Розетка кабельная Mini-SPOX 2 Circuits |  |  |  |  |  |  |  |  |  |  |  |  |  |  |  | 50375023 | 1 | шт | MOLEX | https://www.molex.com/molex/products/part-detail/crimp_housings/0050375023 |  | 2.50 ₽
│ | │ | │ | ├ | Mini-SPOX Female Crimp Terminal, 22-28 AWG, Reel |  |  |  |  |  |  |  |  |  |  |  |  |  |  |  | 08701039 | 2 | шт | MOLEX | https://www.molex.com/molex/search/partSearch?pQuery=&sType=s&query=5263
│ | │ | │ | ├ | Наконечник кабельный НШВИ 0.5-8 (КВТ) |  |  |  |  |  |  |  |  |  |  |  |  |  |  |  | НШВИ 0.5-8 (КВТ) | 2 | шт
│ | │ | │ | ├ | Провод ПВ-3 0.5 мм2 Красный |  |  |  |  |  |  |  |  |  |  |  |  |  |  |  |  | 0.19 | м
│ | │ | │ | ├ | Провод ПВ-3 0.5 мм2 Синий |  |  |  |  |  |  |  |  |  |  |  |  |  |  |  |  | 0.19 | м
│ | │ | │ | └ | ТУТнг-6/3 (КВТ) Черный |  |  |  |  |  |  |  |  |  |  |  |  |  |  |  |  | 0.11 | м
│ | │ | ├ | Кабель соединительный система управления АЕЖР (Х17)- переходник RJ блочный(Х5) |  |  |  |  |  |  |  |  |  |  |  |  |  |  |  |  | АЕЖР.685631.127 | 1 | шт
│ | │ | │ | ├ | Вилка кабельная TP-8P8C (RJ45) |  |  |  |  |  |  |  |  |  |  |  |  |  |  |  | TP-8P8C (RJ45) | 1 | шт
│ | │ | │ | ├ | Розетка кабельная Mini-SPOX 3 Circuits |  |  |  |  |  |  |  |  |  |  |  |  |  |  |  | 50375033 | 1 | шт | MOLEX | https://www.molex.com/molex/products/part-detail/crimp_housings/0050375033 |  | 3.33 ₽
│ | │ | │ | ├ | Mini-SPOX Female Crimp Terminal, 22-28 AWG, Reel |  |  |  |  |  |  |  |  |  |  |  |  |  |  |  | 08701039 | 3 | шт | MOLEX | https://www.molex.com/molex/search/partSearch?pQuery=&sType=s&query=5263
│ | │ | │ | ├ | Провод ПВ-3 0.5 мм2 Черный |  |  |  |  |  |  |  |  |  |  |  |  |  |  |  |  | 2.3 | м
│ | │ | │ | └ | ТУТнг-6/3 (КВТ) Черный |  |  |  |  |  |  |  |  |  |  |  |  |  |  |  |  | 0.68 | м
│ | │ | ├ | Кабель соединительный плата системы разгрузки - система управления АЕЖР (Х12) - розетка блочная |  |  |  |  |  |  |  |  |  |  |  |  |  |  |  |  | АЕЖР.685631.128 | 1 | шт
│ | │ | │ | ├ | Розетка на кабель 2p, 300В, 8А, 3.81мм |  |  |  |  |  |  |  |  |  |  |  |  |  |  |  | 15EDGK-3.81-02P-14-00A(H) | 1 | шт | DEGSON |  |  | 83.16 ₽
│ | │ | │ | ├ | Розетка кабельная Mini-SPOX 2 Circuits |  |  |  |  |  |  |  |  |  |  |  |  |  |  |  | 50375023 | 1 | шт | MOLEX | https://www.molex.com/molex/products/part-detail/crimp_housings/0050375023 |  | 2.50 ₽
│ | │ | │ | ├ | Mini-SPOX Female Crimp Terminal, 22-28 AWG, Reel |  |  |  |  |  |  |  |  |  |  |  |  |  |  |  | 08701039 | 2 | шт | MOLEX | https://www.molex.com/molex/search/partSearch?pQuery=&sType=s&query=5263
│ | │ | │ | ├ | Наконечник кабельный НШВИ 0.5-8 (КВТ) |  |  |  |  |  |  |  |  |  |  |  |  |  |  |  | НШВИ 0.5-8 (КВТ) | 2 | шт
│ | │ | │ | ├ | Провод ПВ-3 0.5 мм2 Черный |  |  |  |  |  |  |  |  |  |  |  |  |  |  |  |  | 1.5 | м
│ | │ | │ | ├ | Провод ПВ-3 0.5 мм2 Синий |  |  |  |  |  |  |  |  |  |  |  |  |  |  |  |  | 2.1 | м
│ | │ | │ | └ | ТУТнг-6/3 (КВТ) Черный |  |  |  |  |  |  |  |  |  |  |  |  |  |  |  |  | 1.7 | м
│ | │ | ├ | Кабель соединительный система управления АЕЖР (Х15)- вентилятор мотора |  |  |  |  |  |  |  |  |  |  |  |  |  |  |  |  | АЕЖР.685631.130 | 1 | шт
│ | │ | │ | ├ | Розетка на кабель 2EDGK-5.0-02P-14-00A(H) |  |  |  |  |  |  |  |  |  |  |  |  |  |  |  | 2EDGK-5.0-02P-14-00A(H) | 1 | шт
│ | │ | │ | ├ | Наконечник кабельный НШВИ 0.5-8 (КВТ) |  |  |  |  |  |  |  |  |  |  |  |  |  |  |  | НШВИ 0.5-8 (КВТ) | 2 | шт
│ | │ | │ | ├ | Вентилятор FA20060B22HLAC 200x200x60, FANOVER |  |  |  |  |  |  |  |  |  |  |  |  |  |  |  | FA20060B22HLAC | 1 | шт |  |  |  | 2615.33 ₽ |  | PD200B-220 230В - 70Вт - 200х200, Salzer
│ | │ | │ | ├ | Провод ПВ-3 0.5 мм2 Черный |  |  |  |  |  |  |  |  |  |  |  |  |  |  |  |  | 0.7 | м
│ | │ | │ | ├ | ТУТнг-3/1.5 (КВТ) Черный |  |  |  |  |  |  |  |  |  |  |  |  |  |  |  |  | 0.1 | м
│ | │ | │ | └ | ТУТнг-6/3 (КВТ) Черный |  |  |  |  |  |  |  |  |  |  |  |  |  |  |  |  | 0.45 | м
│ | │ | ├ | Кабель соединительный плата системы разгрузки (Х6 ) - аккумуляторные батареи |  |  |  |  |  |  |  |  |  |  |  |  |  |  |  |  | АЕЖР.685631.131 | 1 | шт
│ | │ | │ | ├ | Розетка на кабель 2EDGK-5.0-02P-14-00A(H) |  |  |  |  |  |  |  |  |  |  |  |  |  |  |  | 2EDGK-5.0-02P-14-00A(H) | 1 | шт
│ | │ | │ | ├ | Наконечник кабельный НШВИ 1.5-8 (КВТ) |  |  |  |  |  |  |  |  |  |  |  |  |  |  |  | НШВИ 1.5-8 (КВТ) | 2 | шт
│ | │ | │ | ├ | Клемма ножевая РПИ-М 1.5-(4.8) (КВТ) |  |  |  |  |  |  |  |  |  |  |  |  |  |  |  | РПИ-М 2.5-(4.8) (КВТ) | 2 | шт | КВТ |  |  | 5.00 ₽
│ | │ | │ | └ | Провод ПВ-3 1.5 мм2 Красный |  |  |  |  |  |  |  |  |  |  |  |  |  |  |  |  | 0.35 | м
│ | │ | ├ | Втулка |  |  |  |  |  |  |  |  |  |  |  |  |  |  |  |  | АЕЖР-01.01.00.002 | 4 | шт
│ | │ | ├ | Пластина |  |  |  |  |  |  |  |  |  |  |  |  |  |  |  |  | АЕЖР-01.01.00.005 | 4 | шт
│ | │ | ├ | Втулка |  |  |  |  |  |  |  |  |  |  |  |  |  |  |  |  | АЕЖР-01.01.00.007 | 4 | шт
│ | │ | ├ | Виброопора |  |  |  |  |  |  |  |  |  |  |  |  |  |  |  |  | АЕЖР-01.01.00.008 | 2 | шт
│ | │ | ├ | Скоба |  |  |  |  |  |  |  |  |  |  |  |  |  |  |  |  | АЕЖР-01.01.00.018 | 1 | шт
│ | │ | ├ | Разъемы для периферии. Информационная наклейка. |  |  |  |  |  |  |  |  |  |  |  |  |  |  |  |  | АЕЖР.305435.007-12 | 1 | шт
│ | │ | ├ | Кабель питания и клемма заземления изделия. Информационная наклейка |  |  |  |  |  |  |  |  |  |  |  |  |  |  |  |  | АЕЖР.305435.007-13 | 1 | шт
│ | │ | ├ | изделие серии «Пусто», модификация по скорости 10 км / ч, без системы разгрузки. Информационная наклейка |  |  |  |  |  |  |  |  |  |  |  |  |  |  |  |  | АЕЖР.305435.007-10 | 1 | шт
│ | │ | ├ | Разъемы панели управления. Информационная наклейка. |  |  |  |  |  |  |  |  |  |  |  |  |  |  |  |  | АЕЖР.305435.030-02 | 1 | шт
│ | │ | ├ | Винт M3х8 Din 7985 - Zn |  |  |  |  |  |  |  |  |  |  |  |  |  |  |  |  |  | 24 | шт
│ | │ | ├ | Винт M4х8 Din 7985 - Zn |  |  |  |  |  |  |  |  |  |  |  |  |  |  |  |  |  | 16 | шт
│ | │ | ├ | Винт M4х20 Din 7985 - Zn |  |  |  |  |  |  |  |  |  |  |  |  |  |  |  |  |  | 2 | шт
│ | │ | ├ | Винт M6х30 Din 7985 |  |  |  |  |  |  |  |  |  |  |  |  |  |  |  |  |  | 4 | шт
│ | │ | ├ | Винт 10х45 Din 931 - Zn |  |  |  |  |  |  |  |  |  |  |  |  |  |  |  |  |  | 4 | шт
│ | │ | ├ | Винт 6х20 Din 933 - Zn |  |  |  |  |  |  |  |  |  |  |  |  |  |  |  |  |  | 2 | шт
│ | │ | ├ | Болт M6х30 Din 933 - CuZn |  |  |  |  |  |  |  |  |  |  |  |  |  |  |  |  |  | 1 | шт
│ | │ | ├ | Болт M10х65 Din 933 |  |  |  |  |  |  |  |  |  |  |  |  |  |  |  |  |  | 1 | шт
│ | │ | ├ | Болт M10х60 Din 933 |  |  |  |  |  |  |  |  |  |  |  |  |  |  |  |  |  | 1 | шт
│ | │ | ├ | Винт M5х16 Din 912 - Zn |  |  |  |  |  |  |  |  |  |  |  |  |  |  |  |  |  | 1 | шт
│ | │ | ├ | Винт M6х20 Din 912 - Zn |  |  |  |  |  |  |  |  |  |  |  |  |  |  |  |  |  | 3 | шт
│ | │ | ├ | Винт M8х30 Din 912 - Zn |  |  |  |  |  |  |  |  |  |  |  |  |  |  |  |  |  | 12 | шт
│ | │ | ├ | Винт M10х30 Din 912 - Zn |  |  |  |  |  |  |  |  |  |  |  |  |  |  |  |  |  | 12 | шт
│ | │ | ├ | Винт M3х8 Din 965 - Zn |  |  |  |  |  |  |  |  |  |  |  |  |  |  |  |  |  | 2 | шт
│ | │ | ├ | Винт M4х10 Din 965 - Zn |  |  |  |  |  |  |  |  |  |  |  |  |  |  |  |  |  | 4 | шт
│ | │ | ├ | Винт M5х16 Din 967 |  |  |  |  |  |  |  |  |  |  |  |  |  |  |  |  |  | 4 | шт
│ | │ | ├ | Шайба 3.2 Din 125 - Zn |  |  |  |  |  |  |  |  |  |  |  |  |  |  |  |  |  | 24 | шт
│ | │ | ├ | Шайба 4.3 Din 125 - Zn |  |  |  |  |  |  |  |  |  |  |  |  |  |  |  |  |  | 16 | шт
│ | │ | ├ | Шайба 5.3 Din 125 - Zn |  |  |  |  |  |  |  |  |  |  |  |  |  |  |  |  |  | 5 | шт
│ | │ | ├ | Шайба 6.4 Din 125 - Zn |  |  |  |  |  |  |  |  |  |  |  |  |  |  |  |  |  | 15 | шт
│ | │ | ├ | Шайба 6 Din 125 - CuZn |  |  |  |  |  |  |  |  |  |  |  |  |  |  |  |  |  | 3 | шт
│ | │ | ├ | Шайба 10.5 Din 125 - Zn |  |  |  |  |  |  |  |  |  |  |  |  |  |  |  |  |  | 12 | шт
│ | │ | ├ | Шайба 2 Din 127 - Zn |  |  |  |  |  |  |  |  |  |  |  |  |  |  |  |  |  | 8 | шт
│ | │ | ├ | Шайба 3 Din 127 - Zn |  |  |  |  |  |  |  |  |  |  |  |  |  |  |  |  |  | 24 | шт
│ | │ | ├ | Шайба 4 Din 127 - Zn |  |  |  |  |  |  |  |  |  |  |  |  |  |  |  |  |  | 34 | шт
│ | │ | ├ | Шайба 5 Din 127 - Zn |  |  |  |  |  |  |  |  |  |  |  |  |  |  |  |  |  | 5 | шт
│ | │ | ├ | Шайба 6 Din 127 - Zn |  |  |  |  |  |  |  |  |  |  |  |  |  |  |  |  |  | 11 | шт
│ | │ | ├ | Шайба 6 Din 127 - CuZn |  |  |  |  |  |  |  |  |  |  |  |  |  |  |  |  |  | 2 | шт
│ | │ | ├ | Шайба 8 Din 127 - Zn |  |  |  |  |  |  |  |  |  |  |  |  |  |  |  |  |  | 8 | шт
│ | │ | ├ | Шайба 10 Din 127 - Zn |  |  |  |  |  |  |  |  |  |  |  |  |  |  |  |  |  | 14 | шт
│ | │ | ├ | Verzle Din 985 - M4 |  |  |  |  |  |  |  |  |  |  |  |  |  |  |  |  |  | 2 | шт
│ | │ | ├ | Гайка Din 985 - M6 |  |  |  |  |  |  |  |  |  |  |  |  |  |  |  |  |  | 2 | шт
│ | │ | ├ | Гайка M6 Din 934 - CuZn |  |  |  |  |  |  |  |  |  |  |  |  |  |  |  |  |  | 3 | шт
│ | │ | ├ | Verzle Din 985 - M10 |  |  |  |  |  |  |  |  |  |  |  |  |  |  |  |  |  | 4 | шт
│ | │ | ├ | Гайка Din 934 M10 |  |  |  |  |  |  |  |  |  |  |  |  |  |  |  |  |  | 2 | шт
│ | │ | ├ | Крепление ПМО 15х10 |  |  |  |  |  |  |  |  |  |  |  |  |  |  |  |  | 62452 | 4 | шт
│ | │ | ├ | Техпластина ТМКЩ 1,0 мм 30х18 мм |  |  |  |  |  |  |  |  |  |  |  |  |  |  |  |  |  | 8 | шт
│ | │ | ├ | Техпластина ТМКЩ 1,0 мм 139х139 мм |  |  |  |  |  |  |  |  |  |  |  |  |  |  |  |  |  | 1 | шт
│ | │ | ├ | Техпластина ТМКЩ 1,0 мм 165х40 мм |  |  |  |  |  |  |  |  |  |  |  |  |  |  |  |  |  | 1 | шт
│ | │ | ├ | Панельный разъем Стресс системы RJ-45 |  |  |  |  |  |  |  |  |  |  |  |  |  |  |  |  | CP30220M, RS Pro Cat5e, UTP FT Series либо RJ45 RS 907-5652 | 1 | шт | RS pro | https://ru.rsdelivers.com/product/rs-pro/rs30220m/rs-pro-%D0%B0%D0%B4%D0%B0%D0%BF%D1%82%D0%B5%D1%80/9075652 |  | 530.00 ₽ |  | Внешняя стресс система
│ | │ | ├ | Стяжка кабельная нейлоновая неоткрываемая 150х4 (белая) |  |  |  |  |  |  |  |  |  |  |  |  |  |  |  |  |  | 10 | шт
│ | │ | ├ | Короб перфорированный 25х30 RL75 2 серый QUADRO |  |  |  |  |  |  |  |  |  |  |  |  |  |  |  |  |  | 1.2 | м |  | https://www.etm.ru/cat/nn/1338839/ |  | 98.78 ₽ |  | Замена коробу RL75 15x18 серый QUADRO
│ | │ | ├ | Втулка 6-6 ГОСТ 19421-74 |  |  |  |  |  |  |  |  |  |  |  |  |  |  |  |  |  | 5 | шт
│ | │ | ├ | Розетка блочная FQ18-5ZK-S, 5p, 400 В, 10 А |  |  |  |  |  |  |  |  |  |  |  |  |  |  |  |  | FQ18-5ZK-S | 1 | шт | Dafa | http://www.rct.ru/warehouse/80004122/80033287.html |  | 168.00 ₽ |  | Кнопка аварийной остановки
│ | │ | ├ | Розетка блочная FQ18-12ZK-S, 12p, 400 В, 10 А |  |  |  |  |  |  |  |  |  |  |  |  |  |  |  |  | FQ18-12ZK-S | 1 | шт | Dafa | http://www.rct.ru/warehouse/80004122/80027959.html |  | 158.13 ₽ |  | Ручной пульт управления
│ | │ | ├ | Розетка блочная FQ18-3ZK-S, 3p, 400 В, 10 А |  |  |  |  |  |  |  |  |  |  |  |  |  |  |  |  | FQ18-3ZK-S | 1 | шт | Dafa | http://www.rct.ru/warehouse/80004122/80018179.html |  | 255.94 ₽ |  | Лазерный нивелир
│ | │ | └ | Розетка блочная FQ18-4ZK-S, 4p, 400 В, 10 А |  |  |  |  |  |  |  |  |  |  |  |  |  |  |  |  | FQ24-4ZJ-S | 1 | шт | POL-SUN | http://connector.su/parts/170/fq24-4zj-s-1780.html |  | 216.92 ₽ |  | Кабель питания
│ | ├ | Комплект оптических датчиков заступа за край полотна |  |  |  |  |  |  |  |  |  |  |  |  |  |  |  |  |  | АЕЖР.402254.510 | 1 | шт
│ | │ | ├ | Изолента 0,13х15мм черная Valsten V02-7B-13x15-10 |  |  |  |  |  |  |  |  |  |  |  |  |  |  |  |  |  | 0.5 | м | REXANT
│ | │ | ├ | Труба автомобильная гофрированая 4,6мм Полипропилен разрезная |  |  |  |  |  |  |  |  |  |  |  |  |  |  |  |  |  | 2 | м | REXANT
│ | │ | ├ | Труба автомобильная гофрированая 4,6мм Полипропилен разрезная |  |  |  |  |  |  |  |  |  |  |  |  |  |  |  |  |  | 1.5 | м | REXANT
│ | │ | ├ | Труба автомобильная гофрированая 6,8мм Полипропилен разрезная |  |  |  |  |  |  |  |  |  |  |  |  |  |  |  |  |  | 1.1 | м | REXANT
│ | │ | ├ | Винт M4х8 Din 7985 - Zn |  |  |  |  |  |  |  |  |  |  |  |  |  |  |  |  |  | 22 | шт
│ | │ | ├ | Шайба 4.3 Din 125 - Zn |  |  |  |  |  |  |  |  |  |  |  |  |  |  |  |  |  | 22 | шт
│ | │ | ├ | Шайба 4 Din 127 - Zn |  |  |  |  |  |  |  |  |  |  |  |  |  |  |  |  |  | 22 | шт
│ | │ | ├ | Хомут для кабеля под винт 4,6мм D=9.5мм |  |  |  |  |  |  |  |  |  |  |  |  |  |  |  |  | KLS8-0402-UC-2 | 4 | шт
│ | │ | ├ | Хомут для кабеля под винт 4,6мм D=6.35мм |  |  |  |  |  |  |  |  |  |  |  |  |  |  |  |  | KLS8-0402-UC-1 | 18 | шт
│ | │ | ├ | Пластина |  |  |  |  |  |  |  |  |  |  |  |  |  |  |  |  | АЕЖР-01.01.00.005 | 4 | шт
│ | │ | ├ | Винт М4х12 Din 7985 |  |  |  |  |  |  |  |  |  |  |  |  |  |  |  |  |  | 8 | шт
│ | │ | ├ | Шайба 4.3 Din 125 |  |  |  |  |  |  |  |  |  |  |  |  |  |  |  |  |  | 8 | шт
│ | │ | ├ | Шайба 4 Din 127 |  |  |  |  |  |  |  |  |  |  |  |  |  |  |  |  |  | 8 | шт
│ | │ | ├ | Винт М2х12 Din 7985 - Zn |  |  |  |  |  |  |  |  |  |  |  |  |  |  |  |  |  | 8 | шт |  |  |  |  |  | В комплекте с датчиками, не заказывать
│ | │ | ├ | Шайба 2 Din 127 |  |  |  |  |  |  |  |  |  |  |  |  |  |  |  |  |  | 8 | шт |  |  |  |  |  | В комплекте с датчиками, не заказывать
│ | │ | ├ | Кабель соединительный оптический датчик А8 - система управления АЕЖР (Х2) |  |  |  |  |  |  |  |  |  |  |  |  |  |  |  |  | АЕЖР.685631.141 | 1 | шт
│ | │ | │ | ├ | Датчик оптический (приемник) BTS1M-TDTD (in) |  |  |  |  |  |  |  |  |  |  |  |  |  |  |  | BTS1M-TDTD | 1 | шт | Autonics | http://kipstore.ru/bts1m-tdtd/ |  | 4020.00 ₽ |  | Тип TDTD (т.к. Необходим выбор датчика NPN типа Dark ON (открытый коллектор) При пересечении луча транзистор открывается. Возможные ситуации при этом: - 1 Обрыв питания датчика 24В - закрывается выходной транзистор, плата подтягивает выход к питанию, выводит сообщение о заступе. - 2 КЗ питания датчика на землю - срабатывание преда на плате, далее как 1. - 3 Обрыв выхода датчика - плата подтягивает выход к питанию, выводит сообщение о заступе. - 4 КЗ выхода датчика на землю - не возможно отследить, будет считаться нормальным режимом без заступа. - 5 Обрыв земли датчика - закрывается выходной транзистор, плата подтягивает выход к питанию, выводит сообщение о заступе. Возможные ситуации при выборе датчика Light ON: - 1 Обрыв питания датчика 24В - не возможно отследить, будет считаться нормальным режимом без заступа. - 2 КЗ питания датчика на землю - не возможно отследить, будет считаться нормальным режимом без заступа. - 3 Обрыв выхода датчика - не возможно отследить, будет считаться нормальным режимом без заступа. - 4 КЗ выхода датчика на землю - выводит сообщение о заступе. - 5 Обрыв земли датчика - не возможно отследить, будет считаться нормальным режимом без заступа.
│ | │ | │ | ├ | Розетка кабельная Mini-SPOX 3 Circuits |  |  |  |  |  |  |  |  |  |  |  |  |  |  |  | 50375033 | 1 | шт | MOLEX | https://www.molex.com/molex/products/part-detail/crimp_housings/0050375033 |  | 3.33 ₽
│ | │ | │ | └ | Mini-SPOX Female Crimp Terminal, 22-28 AWG, Reel |  |  |  |  |  |  |  |  |  |  |  |  |  |  |  | 08701039 | 3 | шт | MOLEX | https://www.molex.com/molex/search/partSearch?pQuery=&sType=s&query=5263
│ | │ | ├ | Кабель соединительный оптический датчик А9 - система управления АЕЖР (Х3) |  |  |  |  |  |  |  |  |  |  |  |  |  |  |  |  | АЕЖР.685631.144 | 1 | шт
│ | │ | │ | ├ | Датчик оптический (приемник) BTS1M-TDTD (in) |  |  |  |  |  |  |  |  |  |  |  |  |  |  |  | BTS1M-TDTD | 1 | шт | Autonics | http://kipstore.ru/bts1m-tdtd/ |  | 4020.00 ₽ |  | Тип TDTD (т.к. Необходим выбор датчика NPN типа Dark ON (открытый коллектор) Возможные ситуации при этом: - 1 Обрыв питания датчика 24В - закрывается выходной транзистор, плата подтягивает выход к питанию, выводит сообщение о заступе. - 2 КЗ питания датчика на землю - срабатывание преда на плате, далее как 1. - 3 Обрыв выхода датчика - плата подтягивает выход к питанию, выводит сообщение о заступе. - 4 КЗ выхода датчика на землю - не возможно отследить, будет считаться нормальным режимом без заступа. - 5 Обрыв земли датчика - закрывается выходной транзистор, плата подтягивает выход к питанию, выводит сообщение о заступе. Возможные ситуации при выборе датчика Light ON: - 1 Обрыв питания датчика 24В - не возможно отследить, будет считаться нормальным режимом без заступа. - 2 КЗ питания датчика на землю - не возможно отследить, будет считаться нормальным режимом без заступа. - 3 Обрыв выхода датчика - не возможно отследить, будет считаться нормальным режимом без заступа. - 4 КЗ выхода датчика на землю - выводит сообщение о заступе. - 5 Обрыв земли датчика - не возможно отследить, будет считаться нормальным режимом без заступа.
│ | │ | │ | ├ | Розетка кабельная Mini-SPOX 3 Circuits |  |  |  |  |  |  |  |  |  |  |  |  |  |  |  | 50375033 | 1 | шт | MOLEX | https://www.molex.com/molex/products/part-detail/crimp_housings/0050375033 |  | 3.33 ₽
│ | │ | │ | ├ | Mini-SPOX Female Crimp Terminal, 22-28 AWG, Reel |  |  |  |  |  |  |  |  |  |  |  |  |  |  |  | 08701039 | 3 | шт | MOLEX | https://www.molex.com/molex/search/partSearch?pQuery=&sType=s&query=5263
│ | │ | │ | ├ | Провод ПВ-3 0.5 мм2 Коричневый |  |  |  |  |  |  |  |  |  |  |  |  |  |  |  |  | 0.9 | м
│ | │ | │ | ├ | Провод ПВ-3 0.5 мм2 Черный |  |  |  |  |  |  |  |  |  |  |  |  |  |  |  |  | 0.9 | м
│ | │ | │ | ├ | Провод ПВ-3 0.5 мм2 Синий |  |  |  |  |  |  |  |  |  |  |  |  |  |  |  |  | 0.9 | м
│ | │ | │ | ├ | ТУТнг-8/4 (КВТ) Черный |  |  |  |  |  |  |  |  |  |  |  |  |  |  |  |  | 0.9 | м
│ | │ | │ | └ | ТУТнг-3/1.5 (КВТ) Черный |  |  |  |  |  |  |  |  |  |  |  |  |  |  |  |  | 0.1 | м
│ | │ | └ | Кабель соединительный оптический датчик А6 -оптический датчик А7 - система управления АЕЖР (Х4) |  |  |  |  |  |  |  |  |  |  |  |  |  |  |  |  | АЕЖР.685631.145 | 1 | шт
│ | │ |  | ├ | Датчик оптический (передатчик) BTS1M-TDTD (in) (Входит в комплект приемника) |  |  |  |  |  |  |  |  |  |  |  |  |  |  |  | BTS1M-TDTD | 0 | шт | Autonics | http://kipstore.ru/bts1m-tdtd/ |  | 4020.00 ₽ |  | Тип TDTD (т.к. Необходим выбор датчика NPN типа Dark ON (открытый коллектор) Возможные ситуации при этом: - 1 Обрыв питания датчика 24В - закрывается выходной транзистор, плата подтягивает выход к питанию, выводит сообщение о заступе. - 2 КЗ питания датчика на землю - срабатывание преда на плате, далее как 1. - 3 Обрыв выхода датчика - плата подтягивает выход к питанию, выводит сообщение о заступе. - 4 КЗ выхода датчика на землю - не возможно отследить, будет считаться нормальным режимом без заступа. - 5 Обрыв земли датчика - закрывается выходной транзистор, плата подтягивает выход к питанию, выводит сообщение о заступе. Возможные ситуации при выборе датчика Light ON: - 1 Обрыв питания датчика 24В - не возможно отследить, будет считаться нормальным режимом без заступа. - 2 КЗ питания датчика на землю - не возможно отследить, будет считаться нормальным режимом без заступа. - 3 Обрыв выхода датчика - не возможно отследить, будет считаться нормальным режимом без заступа. - 4 КЗ выхода датчика на землю - выводит сообщение о заступе. - 5 Обрыв земли датчика - не возможно отследить, будет считаться нормальным режимом без заступа.
│ | │ |  | ├ | Розетка кабельная Mini-SPOX 2 Circuits |  |  |  |  |  |  |  |  |  |  |  |  |  |  |  | 50375023 | 1 | шт | MOLEX | https://www.molex.com/molex/products/part-detail/crimp_housings/0050375023 |  | 2.50 ₽
│ | │ |  | ├ | Mini-SPOX Female Crimp Terminal, 22-28 AWG, Reel |  |  |  |  |  |  |  |  |  |  |  |  |  |  |  | 08701039 | 2 | шт | MOLEX | https://www.molex.com/molex/search/partSearch?pQuery=&sType=s&query=5263
│ | │ |  | ├ | Провод ПВ-3 0.5 мм2 Коричневый |  |  |  |  |  |  |  |  |  |  |  |  |  |  |  |  | 0.45 | м
│ | │ |  | ├ | Провод ПВ-3 0.5 мм2 Синий |  |  |  |  |  |  |  |  |  |  |  |  |  |  |  |  | 0.45 | м
│ | │ |  | ├ | ТУТнг-3/1.5 (КВТ) Черный |  |  |  |  |  |  |  |  |  |  |  |  |  |  |  |  | 0.1 | м
│ | │ |  | └ | ТУТнг-6/3 (КВТ) Черный |  |  |  |  |  |  |  |  |  |  |  |  |  |  |  |  | 0.4 | м
│ | ├ | Система адаптации скорости (САС) полотна |  |  |  |  |  |  |  |  |  |  |  |  |  |  |  |  |  | АЕЖР.421455.001 | 1 | шт
│ | ├ | Ручной пульт управления 6кн. (модификация без сист. Разгрузки) |  |  |  |  |  |  |  |  |  |  |  |  |  |  |  |  |  | АЕЖР.422411.001 | 1 | шт |  |  | 1.26
│ | │ | ├ | Панель лицевая пульта управления |  |  |  |  |  |  |  |  |  |  |  |  |  |  |  |  | АЕЖР.301412.001 | 1 | шт
│ | │ | └ | Ручной пульт управления |  |  |  |  |  |  |  |  |  |  |  |  |  |  |  |  | АЕЖР.422411.001 | 1 | шт
│ | │ |  | ├ | Вилка кабельная 12к |  |  |  |  |  |  |  |  |  |  |  |  |  |  |  | FQ18-12TJ-6 | 1 | шт | Dafa | http://www.rct.ru/warehouse/80004122/80027958.html |  | 240.54 ₽
│ | │ |  | ├ | LAP4-3-G, 6 кнопок (Hiwin) |  |  |  |  |  |  |  |  |  |  |  |  |  |  |  | LAP4-3-G | 1 | шт | Hiwin | https://shop.antrieb.ru/produkcija/aktuatory_linejnye_privody/linejnye_aktuatory_hiwin/kontrolery_i_pdu/lap_4.htm |  | 4497.00 ₽
│ | │ |  | └ | ТУТнг-6/3 (КВТ) Черный |  |  |  |  |  |  |  |  |  |  |  |  |  |  |  |  | 0.05 | м |  |  |  | 0.00 ₽
│ | ├ | Кнопка аварийной остановки |  |  |  |  |  |  |  |  |  |  |  |  |  |  |  |  |  | АЕЖР.303659.001 | 1 | шт
│ | │ | ├ | Механика |  |  |  |  |  |  |  |  |  |  |  |  |  |  |  |  |  |  | шт
│ | │ | │ | ├ | Кронштейн |  |  |  |  |  |  |  |  |  |  |  |  |  |  |  | АЕЖР-01.09.00.001 | 1 | шт | REATECH
│ | │ | │ | ├ | Кронштейн |  |  |  |  |  |  |  |  |  |  |  |  |  |  |  | АЕЖР-01.09.00.002 | 1 | шт | REATECH
│ | │ | │ | ├ | Пластина |  |  |  |  |  |  |  |  |  |  |  |  |  |  |  | АЕЖР-01.09.00.003 | 1 | шт | REATECH
│ | │ | │ | └ | Крепеж |  |  |  |  |  |  |  |  |  |  |  |  |  |  |  |  |  | шт
│ | │ | │ |  | ├ | Рукоятка звездообразная Din6336 K0152.24008 |  |  |  |  |  |  |  |  |  |  |  |  |  |  | Din6336 K0152.24008 | 2 | шт
│ | │ | │ |  | ├ | Винт М4x10 Din 965 - Zn |  |  |  |  |  |  |  |  |  |  |  |  |  |  | Din 965 - Zn | 4 | шт
│ | │ | │ |  | ├ | Винт М8х85 Din 965 Z - Zn |  |  |  |  |  |  |  |  |  |  |  |  |  |  | Din 965 Z - Zn | 2 | шт
│ | │ | │ |  | ├ | Гайка М4 Din 934 |  |  |  |  |  |  |  |  |  |  |  |  |  |  | Din 934 | 4 | шт
│ | │ | │ |  | ├ | Шайба 4 Din 127 |  |  |  |  |  |  |  |  |  |  |  |  |  |  | Din 127 | 4 | шт
│ | │ | │ |  | └ | Шайба 4.3 Din 125 |  |  |  |  |  |  |  |  |  |  |  |  |  |  | Din 125 | 4 | шт
│ | │ | ├ | Кнопка "Экстренная остановка". Наклейка. |  |  |  |  |  |  |  |  |  |  |  |  |  |  |  |  | АЕЖР.305435.041 | 1 | шт
│ | │ | ├ | Кнопка LAY5-BS542, аварийная, с фиксацией поворотная |  |  |  |  |  |  |  |  |  |  |  |  |  |  |  |  | LAY5-BS542 | 1 | шт | IEK | https://www.etm.ru/cat/nn/9880145/ |  | 248.75 ₽
│ | │ | ├ | Блок контактный 1р |  |  |  |  |  |  |  |  |  |  |  |  |  |  |  |  | BDK11 | 1 | шт | IEK | https://www.etm.ru/cat/nn/1780431/ |  | 41.52 ₽
│ | │ | ├ | Корпус кнопочный 1 кнопка |  |  |  |  |  |  |  |  |  |  |  |  |  |  |  |  | КП101 | 1 | шт | EKF | https://www.etm.ru/cat/nn/9861121/ |  | 76.20 ₽
│ | │ | └ | Кабель кнопки авария |  |  |  |  |  |  |  |  |  |  |  |  |  |  |  |  | АЕЖР.685631.149 | 1 | шт | REATECH
│ | │ |  | ├ | Вилка для монтажа на кабель FQ18-5TJ-10, 10А |  |  |  |  |  |  |  |  |  |  |  |  |  |  |  | FQ18-5TJ-10 | 1 | шт | Dafa | http://www.rct.ru/warehouse/80004122/80033285.html |  | 282.00 ₽
│ | │ |  | ├ | Кабельный ввод MGB12-P-6G |  |  |  |  |  |  |  |  |  |  |  |  |  |  |  | MGB12-P-6G | 1 | шт |  | https://www.chipdip.ru/product/mgb12-p-6g |  | 48.00 ₽
│ | │ |  | ├ | Наконечник кабельный НВИ 1.5-3 (КВТ) |  |  |  |  |  |  |  |  |  |  |  |  |  |  |  | НВИ-1.5-3 | 4 | шт
│ | │ |  | ├ | Спиральный кабель ÖLFLEX® SPIRAL 400 P (цвет:серый) |  |  |  |  |  |  |  |  |  |  |  |  |  |  |  | 70002634 | 1 | шт | ÖLFLEX | https://products.lappgroup.com/online-catalogue/power-and-control-cables/oelflex-connect-systems-solutions/spiralised/oelflex-spiral-400-p.html |  | 2664.62 ₽
│ | │ |  | └ | ТУТнг-6/3 (КВТ) Черный |  |  |  |  |  |  |  |  |  |  |  |  |  |  |  |  | 0.08 | м |  |  |  | 0.00 ₽
│ | ├ | Встроенный пульт управления (Графическая панель HMI) |  |  |  |  |  |  |  |  |  |  |  |  |  |  |  |  |  | АЕЖР.431294.001 СБ и СП | 1 | шт |  |  | 1.25 |  | 27324.33 ₽
│ | │ | ├ | Печатная плата HMI (Печатный узел) |  |  |  |  |  |  |  |  |  |  |  |  |  |  |  |  | АЕЖР.468366.001 | 1 | шт |  |  |  |  | 8156.51 ₽
│ | │ | │ | ├ | Печатная плата ХМИ |  |  |  |  |  |  |  |  |  |  |  |  |  |  |  | АЕЖР.687254.006-01 | 1 | шт |  |  |  | 3000.00 ₽ | 3000.00 ₽
│ | │ | │ | ├ | Конд. Керам. 22пФ 50В 5% 0805 C0G |  |  |  |  |  |  |  |  |  |  |  |  |  |  |  | GRM2165C1H220JZ01D | 2 | шт |  |  |  | 0.28 ₽ | 0.56 ₽
│ | │ | │ | ├ | Конд. Керам. 10мкФ 6.3В 10% 0805 X5R |  |  |  |  |  |  |  |  |  |  |  |  |  |  |  | CC0805KKX5R5BB106 | 2 | шт |  |  |  | 0.77 ₽ | 1.54 ₽
│ | │ | │ | ├ | Конд. Керам. 1мкФ 16В 5% 0805 X7R |  |  |  |  |  |  |  |  |  |  |  |  |  |  |  | C0805C105J4RAC | 6 | шт |  |  |  | 2.91 ₽ | 17.46 ₽
│ | │ | │ | ├ | Конд. Керам. 100нФ 50В 5% 0805 X7R |  |  |  |  |  |  |  |  |  |  |  |  |  |  |  | C0805C104J5RAC7210 | 31 | шт |  |  |  | 4.47 ₽ | 138.57 ₽
│ | │ | │ | ├ | Конд. Керам. 4.7мкФ 16В 5% 0805 X7R |  |  |  |  |  |  |  |  |  |  |  |  |  |  |  | C0805C475J4RACAUTO7210 | 10 | шт |  |  |  | 17.50 ₽ | 175.00 ₽
│ | │ | │ | ├ | Конд. Алюм. 100мкФ 50В 20% |  |  |  |  |  |  |  |  |  |  |  |  |  |  |  | MAL215097101E3 | 2 | шт |  |  |  | 53.00 ₽ | 106.00 ₽
│ | │ | │ | ├ | Конд. Керам. 1мкФ 50В 5% 1812 X7R |  |  |  |  |  |  |  |  |  |  |  |  |  |  |  | VJ1812Y105JXAAR | 5 | шт |  |  |  | 10.20 ₽ | 51.00 ₽
│ | │ | │ | ├ | Конд. Керам. 10нФ 50В 5% 0805 X7R |  |  |  |  |  |  |  |  |  |  |  |  |  |  |  | C0805C103J5RACTU | 6 | шт |  |  |  | 0.51 ₽ | 3.06 ₽
│ | │ | │ | ├ | Конд. Керам. 47мкФ 16В 10% 1210 X5R |  |  |  |  |  |  |  |  |  |  |  |  |  |  |  | GRM32ER61C476KE15L | 1 | шт |  |  |  | 13.50 ₽ | 13.50 ₽
│ | │ | │ | ├ | Конд. Алюм. 470мкФ 16В 20% |  |  |  |  |  |  |  |  |  |  |  |  |  |  |  | MAL215097501E3 | 1 | шт |  |  |  | 60.30 ₽ | 60.30 ₽
│ | │ | │ | ├ | Конд. Керам. 220пФ 50В 5% 0805 X7R |  |  |  |  |  |  |  |  |  |  |  |  |  |  |  | VJ0805A221JXAAC | 1 | шт |  |  |  | 2.05 ₽ | 2.05 ₽
│ | │ | │ | ├ | Конд. Алюм. 220мкФ 35В 20% |  |  |  |  |  |  |  |  |  |  |  |  |  |  |  | MAL215097001E3 | 1 | шт |  |  |  | 45.60 ₽ | 45.60 ₽
│ | │ | │ | ├ | Конд. Керам. 3.3нФ 50В 5% 0805 X7R |  |  |  |  |  |  |  |  |  |  |  |  |  |  |  | C0805C332J5GAC | 2 | шт |  |  |  | 0.83 ₽ | 1.66 ₽
│ | │ | │ | ├ | Проходной Конд. Керам. 1.5мкФ 25В 6А 20% 1806 |  |  |  |  |  |  |  |  |  |  |  |  |  |  |  | NFM41PC155B1E3L | 3 | шт |  |  |  | 27.80 ₽ | 83.40 ₽
│ | │ | │ | ├ | Защитный диод 36.7 - 40.6В 1мкА 11.3А 53.3V |  |  |  |  |  |  |  |  |  |  |  |  |  |  |  | SMBJ33A | 1 | шт |  |  |  | 3.43 ₽ | 3.43 ₽
│ | │ | │ | ├ | Диод 50В 4/8А 570мВ |  |  |  |  |  |  |  |  |  |  |  |  |  |  |  | V8PAL50-M3/I | 2 | шт |  |  |  | 25.80 ₽ | 51.60 ₽
│ | │ | │ | ├ | Защитный диод 5.2 - 6.0В 600мкА 43.8А 8V |  |  |  |  |  |  |  |  |  |  |  |  |  |  |  | PTVS3V3S1UR | 1 | шт |  |  |  | 5.32 ₽ | 5.32 ₽
│ | │ | │ | ├ | Защитный диод 6.4 - 7.07В 800мкА 65.2А 9.2V |  |  |  |  |  |  |  |  |  |  |  |  |  |  |  | SMBJ5.0A | 1 | шт |  |  |  | 1.99 ₽ | 1.99 ₽
│ | │ | │ | ├ | ИОН TL431ACDBZT, SOT-23_3 |  |  |  |  |  |  |  |  |  |  |  |  |  |  |  | TL431ACDBZT, SOT-23_3 | 1 | шт |  |  |  | 28.30 ₽ | 28.30 ₽
│ | │ | │ | ├ | Операционный усил. 2.2-36В |  |  |  |  |  |  |  |  |  |  |  |  |  |  |  | OPA244NA/250 | 1 | шт |  |  |  | 55.00 ₽ | 55.00 ₽
│ | │ | │ | ├ | Часы RTC с I2C |  |  |  |  |  |  |  |  |  |  |  |  |  |  |  | DS3231SN, SOIC-16 | 1 | шт |  |  |  | 131.00 ₽ | 131.00 ₽
│ | │ | │ | ├ | Контроллер USB 2.0 4-PORT хаб IC |  |  |  |  |  |  |  |  |  |  |  |  |  |  |  | FE1.1s, SSOP-28 | 1 | шт |  |  |  | 25.80 ₽ | 25.80 ₽
│ | │ | │ | ├ | Приемопередатчик интерфейса RS-232 |  |  |  |  |  |  |  |  |  |  |  |  |  |  |  | MAX3232EID, SOIC-16 | 1 | шт |  |  |  | 56.10 ₽ | 56.10 ₽
│ | │ | │ | ├ | Конвертер HDMI to ParallelBusDVI |  |  |  |  |  |  |  |  |  |  |  |  |  |  |  | TFP401A | 1 | шт |  |  |  | 336.00 ₽ | 336.00 ₽
│ | │ | │ | ├ | Конвертер ParallelBusDVI to 2 chanel LVDS |  |  |  |  |  |  |  |  |  |  |  |  |  |  |  | DS90C387A | 1 | шт |  |  |  | 352.00 ₽ | 352.00 ₽
│ | │ | │ | ├ | Single Cell Li-Ion and Li-Pol Battery Charger 0.8A 3.5-28Vin |  |  |  |  |  |  |  |  |  |  |  |  |  |  |  | bq21040 | 1 | шт |  |  |  | 40.90 ₽ | 40.90 ₽
│ | │ | │ | ├ | И.диод 1.7-5.5В 50мΩ 4А |  |  |  |  |  |  |  |  |  |  |  |  |  |  |  | LTC4415IMSE | 1 | шт |  |  |  | 409.00 ₽ | 409.00 ₽
│ | │ | │ | ├ | Аудио усилитель 2Вт моно 5В |  |  |  |  |  |  |  |  |  |  |  |  |  |  |  | TPA2000D1 | 1 | шт |  |  |  | 99.10 ₽ | 99.10 ₽
│ | │ | │ | ├ | Конвертер 2.5V to 5.5V Step Down Dual-Out 3.3V/1.8V 1A, 12-Pin, WDFN EP T/R |  |  |  |  |  |  |  |  |  |  |  |  |  |  |  | PAM2306AYPKE | 1 | шт |  |  |  | 30.80 ₽ | 30.80 ₽
│ | │ | │ | ├ | Супервизор adj |  |  |  |  |  |  |  |  |  |  |  |  |  |  |  | TPS3701DDCT | 3 | шт |  |  |  | 87.50 ₽ | 262.50 ₽
│ | │ | │ | ├ | Пред. 15В 0.5А 1812 |  |  |  |  |  |  |  |  |  |  |  |  |  |  |  | MF-MSMF050-2 | 3 | шт |  |  |  | 3.01 ₽ | 9.03 ₽
│ | │ | │ | ├ | Пред. 16В 2.5А 1812 |  |  |  |  |  |  |  |  |  |  |  |  |  |  |  | MF-MSMF250/16-2 | 2 | шт |  |  |  | 134.00 ₽ | 268.00 ₽
│ | │ | │ | ├ | Пред. 60В 750mА 1812 |  |  |  |  |  |  |  |  |  |  |  |  |  |  |  | MF-SM075/60 | 1 | шт |  |  |  | 14.10 ₽ | 14.10 ₽
│ | │ | │ | ├ | Пред. 24В 1.1А 1812 |  |  |  |  |  |  |  |  |  |  |  |  |  |  |  | MF-MSMF110/24X | 1 | шт |  |  |  | 6.09 ₽ | 6.09 ₽
│ | │ | │ | ├ | Батарейный отсек CR2032 |  |  |  |  |  |  |  |  |  |  |  |  |  |  |  | S8421-45R | 1 | шт |  |  |  | 53.10 ₽ | 53.10 ₽
│ | │ | │ | ├ | Кнопка 24В 50мА 100мΩ TYCO; FSM16JH 100ks |  |  |  |  |  |  |  |  |  |  |  |  |  |  |  | 3-1825910-1 | 1 | шт |  |  |  | 5.73 ₽ | 5.73 ₽
│ | │ | │ | ├ | Ферит бусина 4А Z=470 Ω R=0,02 Ω 1206 |  |  |  |  |  |  |  |  |  |  |  |  |  |  |  | BLM31KN471SN1L _1 | 14 | шт |  |  |  | 9.22 ₽ | 129.08 ₽
│ | │ | │ | ├ | Ферит бусина 2.2А Z=220 Ω R=0,05 Ω 0603 |  |  |  |  |  |  |  |  |  |  |  |  |  |  |  | MPZ1608S221 | 5 | шт |  |  |  | 0.80 ₽ | 4.00 ₽
│ | │ | │ | ├ | EMI фильтр. Частота среза 3.5GHz Recomended: HDMI до 36bit/color 1.11GHz |  |  |  |  |  |  |  |  |  |  |  |  |  |  |  | ACM2012D-900-2P | 9 | шт |  |  |  | 26.80 ₽ | 241.20 ₽
│ | │ | │ | ├ | Дроссель 39uH 20% 3.5A |  |  |  |  |  |  |  |  |  |  |  |  |  |  |  | CDRH127/LDNP-390M | 1 | шт |  |  |  | 33.50 ₽ | 33.50 ₽
│ | │ | │ | ├ | Дроссель 4.7uH 20% 2.1A |  |  |  |  |  |  |  |  |  |  |  |  |  |  |  | XFL4030-472ME | 2 | шт |  |  |  | 64.10 ₽ | 128.20 ₽
│ | │ | │ | ├ | Дроссель 68uH 20% 2.6A |  |  |  |  |  |  |  |  |  |  |  |  |  |  |  | CDRH127/LDNP-680M | 1 | шт |  |  |  | 34.70 ₽ | 34.70 ₽
│ | │ | │ | ├ | Кварц 12Мгц SMD |  |  |  |  |  |  |  |  |  |  |  |  |  |  |  | KX-9AT 12.0 MHz | 1 | шт |  |  |  | 56.10 ₽ | 56.10 ₽
│ | │ | │ | ├ | Резистор 10 кΩ 125мВт 1% 0805 200ppm |  |  |  |  |  |  |  |  |  |  |  |  |  |  |  | RC0805FR-0710KL | 7 | шт |  |  |  | 0.18 ₽ | 1.26 ₽
│ | │ | │ | ├ | Резистор 1 кΩ 125мВт 1% 0805 200ppm |  |  |  |  |  |  |  |  |  |  |  |  |  |  |  | RC0805FR-071KL | 7 | шт |  |  |  | 0.15 ₽ | 1.05 ₽
│ | │ | │ | ├ | Резистор 1 MΩ 125мВт 1% 0805 200ppm |  |  |  |  |  |  |  |  |  |  |  |  |  |  |  | RC0805FR-071ML | 5 | шт |  |  |  | 0.17 ₽ | 0.85 ₽
│ | │ | │ | ├ | Резистор 0 Ω 125мВт 1% 0805 200ppm |  |  |  |  |  |  |  |  |  |  |  |  |  |  |  | AC0805FR-070RL | 7 | шт |  |  |  | 0.13 ₽ | 0.91 ₽
│ | │ | │ | ├ | Резистор 100 кΩ 125мВт 1% 0805 200ppm |  |  |  |  |  |  |  |  |  |  |  |  |  |  |  | RC0805FR-07100KL | 5 | шт |  |  |  | 0.16 ₽ | 0.80 ₽
│ | │ | │ | ├ | Резистор 510 Ω 125мВт 1% 0805 |  |  |  |  |  |  |  |  |  |  |  |  |  |  |  | RC0805FR-07510RL | 2 | шт |  |  |  | 0.10 ₽ | 0.20 ₽
│ | │ | │ | ├ | Резистор 30.1 кΩ 125мВт 1% 0805 200ppm |  |  |  |  |  |  |  |  |  |  |  |  |  |  |  | RC0805FR-0730K1L | 3 | шт |  |  |  | 0.13 ₽ | 0.39 ₽
│ | │ | │ | ├ | Резистор 100 Ω 125мВт 1% 0805 200ppm |  |  |  |  |  |  |  |  |  |  |  |  |  |  |  | RC0805FR-07100RL | 6 | шт |  |  |  | 0.15 ₽ | 0.90 ₽
│ | │ | │ | ├ | Резистор 2.7 кΩ 125мВт 1% 0805 100ppm |  |  |  |  |  |  |  |  |  |  |  |  |  |  |  | RC0805FR-072K7L | 4 | шт |  |  |  | 0.12 ₽ | 0.48 ₽
│ | │ | │ | ├ | Резистор 20 Ω 125мВт 1% 0805 200ppm |  |  |  |  |  |  |  |  |  |  |  |  |  |  |  | RC0805FR-0720RL | 3 | шт |  |  |  | 0.18 ₽ | 0.54 ₽
│ | │ | │ | ├ | Резистор 3.6 кΩ 125мВт 1% 0805 |  |  |  |  |  |  |  |  |  |  |  |  |  |  |  | RC0805FR-073K6L | 2 | шт |  |  |  | 0.10 ₽ | 0.20 ₽
│ | │ | │ | ├ | Резистор 12 кΩ 125мВт 1% 0805 |  |  |  |  |  |  |  |  |  |  |  |  |  |  |  | RC0805FR-0712KL | 2 | шт |  |  |  | 0.10 ₽ | 0.20 ₽
│ | │ | │ | ├ | Резистор 2 кΩ 125мВт 1% 0805 100ppm |  |  |  |  |  |  |  |  |  |  |  |  |  |  |  | RC0805FR-072KL | 1 | шт |  |  |  | 0.10 ₽ | 0.10 ₽
│ | │ | │ | ├ | Резистор 33 кΩ 125мВт 1% 0805 |  |  |  |  |  |  |  |  |  |  |  |  |  |  |  | RC0805FR-0733KL | 1 | шт |  |  |  | 0.10 ₽ | 0.10 ₽
│ | │ | │ | ├ | Резистор 4.7 кΩ 125мВт 1% 0805 |  |  |  |  |  |  |  |  |  |  |  |  |  |  |  | RC0805FR-074K7L | 3 | шт |  |  |  | 0.10 ₽ | 0.30 ₽
│ | │ | │ | ├ | Резистор 10 Ω 125мВт 1% 0805 200ppm |  |  |  |  |  |  |  |  |  |  |  |  |  |  |  | RC0805FR-0710RL | 1 | шт |  |  |  | 0.12 ₽ | 0.12 ₽
│ | │ | │ | ├ | Резистор 120 кΩ 125мВт 1% 0805 200ppm |  |  |  |  |  |  |  |  |  |  |  |  |  |  |  | RC0805FR-07120KL | 1 | шт |  |  |  | 0.10 ₽ | 0.10 ₽
│ | │ | │ | ├ | Резистор 56 кΩ 125мВт 1% 0805 200ppm |  |  |  |  |  |  |  |  |  |  |  |  |  |  |  | RC0805FR-0756KL | 1 | шт |  |  |  | 0.12 ₽ | 0.12 ₽
│ | │ | │ | ├ | Резистор 15 кΩ 125мВт 1% 0805 200ppm |  |  |  |  |  |  |  |  |  |  |  |  |  |  |  | RC0805FR-0715KL | 2 | шт |  |  |  | 0.09 ₽ | 0.18 ₽
│ | │ | │ | ├ | Резистор 62 кΩ 125мВт 1% 0805 200ppm |  |  |  |  |  |  |  |  |  |  |  |  |  |  |  | RC0805FR-0762KL | 2 | шт |  |  |  | 0.10 ₽ | 0.20 ₽
│ | │ | │ | ├ | Резистор 5.1 кΩ 125мВт 1% 0805 |  |  |  |  |  |  |  |  |  |  |  |  |  |  |  | RC0805FR-075K1L | 1 | шт |  |  |  | 0.10 ₽ | 0.10 ₽
│ | │ | │ | ├ | Резистор 2 Ω 125мВт 1% 0805 200ppm |  |  |  |  |  |  |  |  |  |  |  |  |  |  |  | RC0805FR-072RL | 2 | шт |  |  |  | 0.17 ₽ | 0.34 ₽
│ | │ | │ | ├ | Vin=8-40V 3A 260kHz Eff=94% |  |  |  |  |  |  |  |  |  |  |  |  |  |  |  | LM2676S-ADJ | 2 | шт |  |  |  | 243.00 ₽ | 486.00 ₽
│ | │ | │ | ├ | Светодиод, GREEN |  |  |  |  |  |  |  |  |  |  |  |  |  |  |  | KPG1-1608VGC-TT-5MAV, 1608 | 4 | шт |  |  |  | 33.40 ₽ | 133.60 ₽
│ | │ | │ | ├ | MOSFET P-Channel -20В -18А 8.0мΩ |  |  |  |  |  |  |  |  |  |  |  |  |  |  |  | FDMC510P | 1 | шт |  |  |  | 47.20 ₽ | 47.20 ₽
│ | │ | │ | ├ | Разъем USB Type A SMT |  |  |  |  |  |  |  |  |  |  |  |  |  |  |  | 629104190121 | 2 | шт |  |  |  | 82.10 ₽ | 164.20 ₽
│ | │ | │ | ├ | Разъем FPC 10pin 0.5mm |  |  |  |  |  |  |  |  |  |  |  |  |  |  |  | XF2M-1015-1A | 1 | шт |  |  |  | 78.50 ₽ | 78.50 ₽
│ | │ | │ | ├ | Разъем USB Type A 2x4 Vertcl Dual Feml |  |  |  |  |  |  |  |  |  |  |  |  |  |  |  | 614008235023 | 1 | шт |  |  |  | 161.00 ₽ | 161.00 ₽
│ | │ | │ | ├ | Разъем 40p 0.5мм LLC |  |  |  |  |  |  |  |  |  |  |  |  |  |  |  | 0512964094 | 1 | шт |  |  |  | 94.10 ₽ | 94.10 ₽
│ | │ | │ | ├ | Разъем на плату угловой 103635-2 |  |  |  |  |  |  |  |  |  |  |  |  |  |  |  | 103635-2 | 1 | шт |  |  |  | 65.70 ₽ | 65.70 ₽
│ | │ | │ | ├ | Разъем на плату угловой 103635-1 |  |  |  |  |  |  |  |  |  |  |  |  |  |  |  | 103635-1 | 1 | шт |  |  |  | 40.20 ₽ | 40.20 ₽
│ | │ | │ | ├ | Разъем на плату угловой 103635-4 |  |  |  |  |  |  |  |  |  |  |  |  |  |  |  | 103635-4 | 1 | шт |  |  |  | 73.40 ₽ | 73.40 ₽
│ | │ | │ | ├ | Разъем SD Micro ATTEND |  |  |  |  |  |  |  |  |  |  |  |  |  |  |  | 112C-TBAR-R02 | 1 | шт |  |  |  | 48.80 ₽ | 48.80 ₽
│ | │ | │ | └ | Разъем DDR2 SODIMM 200p |  |  |  |  |  |  |  |  |  |  |  |  |  |  |  | DDR2 SODIMM | 1 | шт |  |  |  | 183.00 ₽ | 183.00 ₽
│ | │ | ├ | Модификация наконечников аккумулятора HMI |  |  |  |  |  |  |  |  |  |  |  |  |  |  |  |  | АЕЖР.563511.001 СБ и СП | 1 | шт |  |  |  |  | 934.00 ₽
│ | │ | ├ | ├ | Aккумулятор Li-Pol 103454 3,7В 2Ач |  |  |  |  |  |  |  |  |  |  |  |  |  |  |  | LP103454LC-PCM-LD | 1 | шт | EEMB | https://www.compel.ru/infosheet/EEMB/LP103454LC-PCM-LD |  | 841.00 ₽ | 841.00 ₽
│ | │ | ├ | ├ | Разъем кабельный 3pin |  |  |  |  |  |  |  |  |  |  |  |  |  |  |  | 104257-2 (TYCO) | 1 | шт |  | https://www.elitan.ru/price/item306194 |  | 24.00 ₽ | 24.00 ₽
│ | │ | ├ | └ | Wire-to-Board Connector Contacts |  |  |  |  |  |  |  |  |  |  |  |  |  |  |  | 1-104480-6 (TYCO) | 3 | шт |  | https://www.elitan.ru/price/item298913 |  | 23.00 ₽ | 69.00 ₽
│ | │ | ├ | Кабель питания к плате HMI-панели |  |  |  |  |  |  |  |  |  |  |  |  |  |  |  |  | АЕЖР.685631.160 СБ и СП | 1 | шт |  |  |  |  | 2364.00 ₽
│ | │ | │ | ├ | Разъем HMI панельный |  |  |  |  |  |  |  |  |  |  |  |  |  |  |  | SACC-EC-M12FS-5CON-PG 9/0,5 VA - 1554652 | 1 | шт | Феникс панельный | https://www.phoenixcontact.com/online/portal/ru?uri=pxc-oc-itemdetail:pid=1554652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 |  | 2219.00 ₽ | 2219.00 ₽
│ | │ | │ | ├ | Разъем кабельный 5pin |  |  |  |  |  |  |  |  |  |  |  |  |  |  |  | 104257-4 (TYCO) | 1 | шт |  | https://www.elitan.ru/price/item471151 |  | 30.00 ₽ | 30.00 ₽
│ | │ | ├ | └ | Wire-to-Board Connector Contacts |  |  |  |  |  |  |  |  |  |  |  |  |  |  |  | 1-104480-6 (TYCO) | 5 | шт |  | https://www.elitan.ru/price/item298913 |  | 23.00 ₽ | 115.00 ₽
│ | │ | ├ | Печатная плата Рамка TouchScreen |  |  |  |  |  |  |  |  |  |  |  |  |  |  |  |  | АЕЖР.687242.002 | 1 | шт |  |  |  | 500.00 ₽ | 500.00 ₽
│ | │ | ├ | Динамик HMI |  |  |  |  |  |  |  |  |  |  |  |  |  |  |  |  | АЕЖР.757883.001 СБ и СП | 1 | шт |  |  |  |  | 734.97 ₽
│ | │ | ├ | ├ | Динамическая головка 8Ом 4Вт |  |  |  |  |  |  |  |  |  |  |  |  |  |  |  | CMS0321KLX | 1 | шт |  | https://www.elitan.ru/price/index.php?find=CMS0321KLX&delay=-1&mfg=all&seenform=y |  | 668.00 ₽ | 668.00 ₽
│ | │ | ├ | ├ | Разъем кабельный 2pin |  |  |  |  |  |  |  |  |  |  |  |  |  |  |  | 104257-1 (TYCO) | 1 | шт |  | https://www.elitan.ru/price/item306193 |  | 19.00 ₽ | 19.00 ₽
│ | │ | ├ | ├ | Wire-to-Board Connector Contacts |  |  |  |  |  |  |  |  |  |  |  |  |  |  |  | 1-104480-6 (TYCO) | 2 | шт |  | https://www.elitan.ru/price/item298913 |  | 23.00 ₽ | 46.00 ₽
│ | │ | ├ | ├ | Провод ПВ-3 0.5 мм2 Красный |  |  |  |  |  |  |  |  |  |  |  |  |  |  |  |  | 0.17 | м |  |  |  | 3.90 ₽ | 0.66 ₽
│ | │ | ├ | ├ | Провод ПВ-3 0.5 мм2 Синий |  |  |  |  |  |  |  |  |  |  |  |  |  |  |  |  | 0.17 | м |  |  |  | 3.90 ₽ | 0.66 ₽
│ | │ | ├ | └ | ТУТнг-2/1 (КВТ) Черный |  |  |  |  |  |  |  |  |  |  |  |  |  |  |  |  | 0.16 | м |  |  |  | 4.00 ₽ | 0.64 ₽
│ | │ | ├ | Матрица |  |  |  |  |  |  |  |  |  |  |  |  |  |  |  |  | АЕЖР.943119.007 СБ и СП | 1 | шт |  |  |  |  | 2107.00 ₽
│ | │ | │ | ├ | Матрица без ушей |  |  |  |  |  |  |  |  |  |  |  |  |  |  |  | HSD101PWW1-A00 | 1 | шт |  |  |  | 1790.00 ₽ | 1790.00 ₽ | Подходящие замены: M101NWW4 R0; M101NWW4 R2; B101EVN02.0; B101EVN02.1; B101EW05 V.0; HSD101PWW1-H00; HSD101PWW1-G00; HSD101PWW1-G10; LP101WX1(SL)(N2)
│ | │ | │ | └ | Разъем 40p 0.5мм LLC |  |  |  |  |  |  |  |  |  |  |  |  |  |  |  | 512964094 | 1 | шт |  |  |  | 317.00 ₽ | 317.00 ₽
│ | │ | ├ | Пластина |  |  |  |  |  |  |  |  |  |  |  |  |  |  |  |  | АЕЖР-01.12.00.001 | 2 | шт |  |  |  | 80.00 ₽ | 160.00 ₽
│ | │ | ├ | Пластина |  |  |  |  |  |  |  |  |  |  |  |  |  |  |  |  | АЕЖР-01.12.00.002 | 1 | шт |  |  |  | 250.00 ₽ | 250.00 ₽
│ | │ | ├ | Корпус |  |  |  |  |  |  |  |  |  |  |  |  |  |  |  |  | АЕЖР-01.12.00.004 | 1 | шт |  |  |  | 100.00 ₽ | 100.00 ₽ | Фрезеровка
│ | │ | │ | └ | Корпус Front panel ABS, IFT L |  |  |  |  |  |  |  |  |  |  |  |  |  |  |  | B4146107 | 1 | шт | OKW | https://www.okw.com.ru/ru/Interface-Terminal/B4146107.htm |  | 1174.98 ₽ | 1174.98 ₽
│ | │ | ├ | Скоба |  |  |  |  |  |  |  |  |  |  |  |  |  |  |  |  | АЕЖР-01.12.00.010 СБ | 1 | шт |  |  |  | 50.00 ₽ | 50.00 ₽
│ | │ | ├ | Панель ХМИ. Информационная наклейка. |  |  |  |  |  |  |  |  |  |  |  |  |  |  |  |  | АЕЖР.305435.053 | 1 | шт |  |  |  | 150.00 ₽ | 150.00 ₽
│ | │ | ├ | ХМИ Разъем питания. Информационная наклейка. |  |  |  |  |  |  |  |  |  |  |  |  |  |  |  |  | АЕЖР.305435.058 | 1 | шт |  |  |  | 150.00 ₽ | 150.00 ₽
│ | │ | ├ | ХМИ Разъем USB. Информационная наклейка. |  |  |  |  |  |  |  |  |  |  |  |  |  |  |  |  | АЕЖР.305435.059 | 1 | шт |  |  |  | 150.00 ₽ | 150.00 ₽
│ | │ | ├ | Винт M3х10 Din 965 - Zn |  |  |  |  |  |  |  |  |  |  |  |  |  |  |  |  |  | 5 | шт |  |  |  | 3.00 ₽ | 15.00 ₽
│ | │ | ├ | Винт M3х8 Din 7985 - Zn |  |  |  |  |  |  |  |  |  |  |  |  |  |  |  |  |  | 2 | шт |  |  |  | 3.00 ₽ | 6.00 ₽
│ | │ | ├ | Винт самонарезающий с потайной головкой для термопластов 3x10 A2 9090 |  |  |  |  |  |  |  |  |  |  |  |  |  |  |  |  | 3x10 A2 9090 | 12 | шт |  | https://www.superbolt.ru/product/samorez_s_potaynoy_golovkoy_dlya_plastika_s_tupym_kontsom_pod_krest/ |  | 5.00 ₽ | 60.00 ₽
│ | │ | ├ | Саморез для пластика, полукруглая головка 3x10 A2 9091 |  |  |  |  |  |  |  |  |  |  |  |  |  |  |  |  | 3x10 A2 9091 | 12 | шт |  | https://www.superbolt.ru/catalog/samorezy/samorez_s_polukrugloy_golovkoy_dlya_plastika_s_tupym_kontsom_pod_krest/ |  | 5.00 ₽ | 60.00 ₽ | 4шт. Возможно входят в комплект корпуса
│ | │ | ├ | Шайба 3.2 Din 125 - Zn |  |  |  |  |  |  |  |  |  |  |  |  |  |  |  |  |  | 5 | шт |  |  |  | 0.50 ₽ | 2.50 ₽
│ | │ | ├ | Шайба 3 Din 127 - Zn |  |  |  |  |  |  |  |  |  |  |  |  |  |  |  |  |  | 5 | шт |  |  |  | 0.30 ₽ | 1.50 ₽
│ | │ | ├ | Гайка M3 Din 934 - Zn |  |  |  |  |  |  |  |  |  |  |  |  |  |  |  |  |  | 3 | шт |  |  |  | 5.00 ₽ | 15.00 ₽
│ | │ | ├ | Заклепка с потайной головкой 5x16 Din 661 |  |  |  |  |  |  |  |  |  |  |  |  |  |  |  |  |  | 3 | шт |  |  |  | 2.00 ₽ | 6.00 ₽
│ | │ | ├ | Стойка латунная для печатной платы M3 круглая D=5мм (KLS) |  |  |  |  |  |  |  |  |  |  |  |  |  |  |  |  | PCSN-12 | 3 | шт |  |  |  | 30.00 ₽ | 90.00 ₽
│ | │ | ├ | Hardkernel Bluetooth Module 2 (модуль Bluetooth) |  |  |  |  |  |  |  |  |  |  |  |  |  |  |  |  | OD2305 | 1 | шт |  | https://www.onpad.ru/catalog/cubie/odroid/acc_odroid/2115.html |  | 430.00 ₽ | 430.00 ₽ | Адаптер USB Buro BU-BT40A Bluetooth 4.0+EDR class 1.5 20м черный
│ | │ | ├ | Сенсорное стекло черное |  |  |  |  |  |  |  |  |  |  |  |  |  |  |  |  | PB101JG2084 | 1 | шт |  |  |  | 890.00 ₽ | 890.00 ₽
│ | │ | ├ | Флешкарта microSD |  |  |  |  |  |  |  |  |  |  |  |  |  |  |  |  | SDSQUNS-016G-GN3MA | 1 | шт |  | https://www.citilink.ru/catalog/computers_and_notebooks/media/flashcards/1007548/ |  | 290.00 ₽ | 290.00 ₽
│ | │ | ├ | Батарея CR2032 |  |  |  |  |  |  |  |  |  |  |  |  |  |  |  |  | CR2032 | 1 | шт |  | https://www.elitan.ru/price/item71572 |  | 47.50 ₽ | 47.50 ₽
│ | │ | ├ | Raspberry Pi Compute Module 3 Lite |  |  |  |  |  |  |  |  |  |  |  |  |  |  |  |  |  | 1 | шт |  | https://www.compel.ru/infosheet/RASPBERR/Raspberry%20Pi%20Compute%20Module%203%20Lite |  | 2350.00 ₽ | 2350.00 ₽
│ | │ | ├ | Корпус Bottom part flat, IFT L |  |  |  |  |  |  |  |  |  |  |  |  |  |  |  |  | B4046717 | 1 | шт | OKW | https://www.okw.com.ru/ru/Interface-Terminal/B4046717.htm |  | 686.29 ₽ | 686.29 ₽
│ | │ | ├ | Алюминиевая клейкая лента 5001 с лайнером, 50мкр |  |  |  |  |  |  |  |  |  |  |  |  |  |  |  |  |  | 0.12 | м |  |  |  | 390.00 ₽ | 46.80 ₽
│ | │ | ├ | Клеепереносящая лента 9472-10-55; 3М ATG 987; 3М ATG 904 |  |  |  |  |  |  |  |  |  |  |  |  |  |  |  |  |  | 0.9 | м |  | https://nn.vseinstrumenti.ru/krepezh/montazhnye-lenty/kleikaya-lenta/dvuhstoronnyaya/3m-/bezosnovnaya-lenta-atg-904-prozrachnaya-3m-12-mm-x-33-m-7000042431/ |  | 122.00 ₽ | 109.80 ₽
│ | │ | ├ | Лента монтажная, поролон LU 15х5мм или Лента вентиляционная ERA поролон LU |  |  |  |  |  |  |  |  |  |  |  |  |  |  |  |  |  | 0.08 | м |  | https://www.obi.ru/ventilyacionnye-kanaly-i-fitingi/lenta-ventilyacionnaya-era-porolon-lu/p/4207460 |  | 165.00 ₽ | 13.20 ₽
│ | │ | ├ | Стержни для термоклей-пистолетов |  |  |  |  |  |  |  |  |  |  |  |  |  |  |  |  |  | 0.05 | м |  |  |  | 85.60 ₽ | 4.28 ₽
│ | │ | ├ | Кронштейн |  |  |  |  |  |  |  |  |  |  |  |  |  |  |  |  |  | 1 | шт |  |  |  |  | 0.00 ₽
│ | │ | │ | ├ | Крепление RAM® 95 мм муфта под шары 25 мм (1"), алюминий. |  |  |  |  |  |  |  |  |  |  |  |  |  |  |  | RAM-B-201U | 1 | шт |  | https://navi-expert.ru/p42195665-kreplenie-ram-mufta.html |  | 1491.00 ₽ | 1491.00 ₽
│ | │ | │ | ├ | Крепление RAM® круглая площадка 64 мм с отверстиями AMPS. Шар 25 мм (1"), алюминий. |  |  |  |  |  |  |  |  |  |  |  |  |  |  |  | RAM-B-202U | 1 | шт |  | https://navi-expert.ru/p43448377-kreplenie-ram-kruglaya.html |  | 795.00 ₽ | 795.00 ₽
│ | │ | │ | ├ | шар RAM® Pin-Lock™ 25 мм (1") с круглым основанием и сквозным отверстием для крепления |  |  |  |  |  |  |  |  |  |  |  |  |  |  |  | RAP-B-397BNHU | 1 | шт |  | https://navi-expert.ru/p370618084-rap-397bnhu-shar.html |  | 759.00 ₽ | 759.00 ₽
│ | │ | │ | ├ | Подшипник |  |  |  |  |  |  |  |  |  |  |  |  |  |  |  | F 6-12 M | 1 | шт |  | https://www.prombearing.ru/catalog/upornye-oDinarnye/f-6-12-m/ |  | 96.00 ₽ | 96.00 ₽
│ | │ | │ | ├ | Шайба фторопласт |  |  |  |  |  |  |  |  |  |  |  |  |  |  |  |  | 1 | шт |  |  |  | 10.00 ₽ | 10.00 ₽
│ | │ | │ | └ | Болт M6х60 Din7985 |  |  |  |  |  |  |  |  |  |  |  |  |  |  |  |  | 1 | шт |  |  |  | 10.00 ₽ | 10.00 ₽
│ | │ | ├ | Радиатор ICK BGA 14х14х10 |  |  |  |  |  |  |  |  |  |  |  |  |  |  |  |  |  | 1 | шт | FISCHER ELEKTRONIK | https://www.tme.eu/ru/details/ickbga14x14x10/radiatory/fischer-elektronik/ick-bga-14-x-14-x-10/ |  |  | 0.00 ₽ | не заказывать
│ | │ | ├ | Радиатор ICK BGA 14х14х6 |  |  |  |  |  |  |  |  |  |  |  |  |  |  |  |  |  | 1 | шт | FISCHER ELEKTRONIK | https://www.tme.eu/ru/details/ickbga14x14/radiatory/fischer-elektronik/ |  |  | 0.00 ₽ | не заказывать
│ | │ | ├ | Радиатор ICK BGA 10х10х10 |  |  |  |  |  |  |  |  |  |  |  |  |  |  |  |  |  | 1 | шт | FISCHER ELEKTRONIK | https://www.tme.eu/ru/details/ickbga10x10x10/radiatory/fischer-elektronik/ick-bga-10-x-10-x-10/ |  |  | 0.00 ₽ | не заказывать
│ | │ | ├ | Феритовый фильтр на шлейф LVDS |  |  |  |  |  |  |  |  |  |  |  |  |  |  |  |  | 7427225 | 2 | шт | Wurth Elektronik | http://www.alfa-elektronik.com/php/wurth/emc/cable_fer/flat.php |  | 350.00 ₽ | 700.00 ₽
│ | │ | ├ | Шлейф пленочный шаг 0,5мм прямой под разъем |  |  |  |  |  |  |  |  |  |  |  |  |  |  |  |  | FPC-0,5-40-100 | 1 | шт |  | https://neokt.ru/ru/katalog/shlejf-pljonochnyj-shag-0-5mm-pod-raz-jom/fpc-0-5-40-100 |  | 100.00 ₽ | 100.00 ₽
│ | │ | ├ | USB 2.0 WiFi Adapter 300Mbps 802.11N/G/B |  |  |  |  |  |  |  |  |  |  |  |  |  |  |  |  | RASP1884 | 1 | шт |  | https://www.onpad.ru/catalog/cubie/raspberrypi/Accessories/1994.html |  | 1240.00 ₽ | 1240.00 ₽
│ | │ | └ | Дистанционная защелка FIX-MAD-2.2 |  |  |  |  |  |  |  |  |  |  |  |  |  |  |  |  | FIX-MAD-2.2 | 2 | шт | https://nn.terraelectronica.ru/product/3495359 | https://www.tme.eu/ru/details/fix-mad-2.2/diubeli-plastmassovye/fix-fasten/ |  | 9.00 ₽ | 18.00 ₽
│ | ├ | Комплект фиксированных больших поручней для изделия без кронштейна для встроенного пульта управления |  |  |  |  |  |  |  |  |  |  |  |  |  |  |  |  |  | АЕЖР.305111.002 | 1 | шт |  |  | 1.2
│ | │ | └ | Комплект фиксированных больших поручней для изделия без кронштейна для встроенного пульта управления (исполнение без подготовки под модуль СМ ЧСС) |  |  |  |  |  |  |  |  |  |  |  |  |  |  |  |  | АЕЖР.305111.009 | 1 | шт
│ | │ |  | ├ | Левый фиксированный большой поручень |  |  |  |  |  |  |  |  |  |  |  |  |  |  |  | АЕЖР-01.02.01.000 | 1 | шт
│ | │ |  | │ | └ | Фиксированный большой поручень левый. Принадлежность. |  |  |  |  |  |  |  |  |  |  |  |  |  |  | АЕЖР.305435.031-02 | 1 | шт
│ | │ |  | └ | Правый фиксированный большой поручень без кронштейна для встроенного пульта управления (исполнение без подготовки под модуль СМ ЧСС) |  |  |  |  |  |  |  |  |  |  |  |  |  |  |  | АЕЖР.305111.021-01 | 1 | шт
│ | │ |  |  | └ | Фиксированный большой поручень правый. Принадлежность. |  |  |  |  |  |  |  |  |  |  |  |  |  |  | АЕЖР.305435.031-01 | 1 | шт
│ | ├ | Комплект фиксированных малых поручней для изделия без кронштейна для встроенного пульта управления |  |  |  |  |  |  |  |  |  |  |  |  |  |  |  |  |  | АЕЖР.305111.003 | 1 | шт |  |  | 1.3
│ | │ | └ | Комплект фиксированных малых поручней для изделия без кронштейна для встроенного пульта управления (исполнение без подготовки под модуль СМ ЧСС) |  |  |  |  |  |  |  |  |  |  |  |  |  |  |  |  | АЕЖР.305111.011 | 1 | шт
│ | │ |  | ├ | Левый фиксированный малый поручень |  |  |  |  |  |  |  |  |  |  |  |  |  |  |  | АЕЖР-01.03.01.000 | 1 | шт
│ | │ |  | │ | └ | Фиксированный малый поручень левый. Принадлежность. |  |  |  |  |  |  |  |  |  |  |  |  |  |  | АЕЖР.305435.032-02 | 1 | шт
│ | │ |  | └ | Правый фиксированный малый поручень без кронштейна для встроенного пульта управления (исполнение без подготовки под модуль СМ ЧСС) |  |  |  |  |  |  |  |  |  |  |  |  |  |  |  | АЕЖР.305111.022-01 | 1 | шт
│ | │ |  |  | └ | Фиксированный малый поручень правый. Принадлежность. |  |  |  |  |  |  |  |  |  |  |  |  |  |  | АЕЖР.305435.032-01 | 1 | шт
│ | ├ | Комплект регулируемых поручней для изделия без кронштейна для встроенного пульта управления |  |  |  |  |  |  |  |  |  |  |  |  |  |  |  |  |  | АЕЖР.305111.004 | 1 | шт |  |  | 1.4
│ | │ | └ | Комплект регулируемых поручней для изделия без кронштейна для встроенного пульта управления (исполнение без подготовки под модуль СМ ЧСС) |  |  |  |  |  |  |  |  |  |  |  |  |  |  |  |  | АЕЖР.305111.013 | 1 | шт
│ | │ |  | ├ | Левый регулируемый поручень |  |  |  |  |  |  |  |  |  |  |  |  |  |  |  | АЕЖР-01.04.01.000 | 1 | шт
│ | │ |  | │ | └ | Регулируемый поручень левый. Принадлежность. |  |  |  |  |  |  |  |  |  |  |  |  |  |  | АЕЖР.305435.033-02 | 1 | шт
│ | │ |  | └ | Правый регулируемый поручень без кронштейна для встроенного пульта управления (исполнение без подготовки под модуль СМ ЧСС) |  |  |  |  |  |  |  |  |  |  |  |  |  |  |  | АЕЖР.305111.023-01 | 1 | шт
│ | │ |  |  | └ | Регулируемый поручень правый. Принадлежность. |  |  |  |  |  |  |  |  |  |  |  |  |  |  | АЕЖР.305435.033-01 | 1 | шт
│ | ├ | Комплект регулируемых малых (детских) поручней для изделия без кронштейна для встроенного пульта управления |  |  |  |  |  |  |  |  |  |  |  |  |  |  |  |  |  | АЕЖР.305111.033 | 1 | шт |  |  | 1.5
│ | ├ | Комплект фиксированных больших поручней для изделия с кронштейном для встроенного пульта управления |  |  |  |  |  |  |  |  |  |  |  |  |  |  |  |  |  | АЕЖР.305111.005 | 1 | шт |  |  | 1.6
│ | │ | └ | Комплект фиксированных больших поручней для изделия с кронштейном для встроенного пульта управления (исполнение без подготовки под модуль СМ ЧСС) |  |  |  |  |  |  |  |  |  |  |  |  |  |  |  |  | АЕЖР.305111.015 | 1 | шт
│ | │ |  | ├ | Левый фиксированный большой поручень |  |  |  |  |  |  |  |  |  |  |  |  |  |  |  | АЕЖР-01.02.01.000 | 1 | шт
│ | │ |  | │ | └ | Фиксированный большой поручень левый. Принадлежность. |  |  |  |  |  |  |  |  |  |  |  |  |  |  | АЕЖР.305435.031-04 | 1 | шт
│ | │ |  | └ | Правый фиксированный большой поручень с кронштейном для встроенного пульта управления (исполнение без подготовки под модуль СМ ЧСС) |  |  |  |  |  |  |  |  |  |  |  |  |  |  |  | АЕЖР.305111.021-02 | 1 | шт
│ | │ |  |  | ├ | Правый фиксированный большой поручень с кронштейном для встроенного пульта управления (исполнение без подготовки под модуль СМ ЧСС) |  |  |  |  |  |  |  |  |  |  |  |  |  |  | АЕЖР-01.02.02.100 | 1 | шт
│ | │ |  |  | ├ | Кабель ХМИ |  |  |  |  |  |  |  |  |  |  |  |  |  |  | АЕЖР.685631.148 | 1 | шт
│ | │ |  |  | │ | ├ | Кабель встроенного пульта управления. Информационная наклейка. |  |  |  |  |  |  |  |  |  |  |  |  |  | АЕЖР.305435.067-01 | 1 | шт
│ | │ |  |  | │ | ├ | Кабель универсальный 2м |  |  |  |  |  |  |  |  |  |  |  |  |  | LAPP KABEL X05VV-F 5G0.5 | 2 | м |  | https://www.etm.ru/cat/nn/607080/ |  | 22.23 ₽
│ | │ |  |  | │ | ├ | Вилка кабельная 6к |  |  |  |  |  |  |  |  |  |  |  |  |  | FQ18-6TJ-6 | 1 | шт | Dafa | http://connector.su/parts/165/fq18-6tj-6-3699.html
│ | │ |  |  | │ | ├ | Разъем HMI кабельный |  |  |  |  |  |  |  |  |  |  |  |  |  | SACC-M12MR-5PL SH - 1424659 | 1 | шт | Феникс кабель папа угловой | https://www.phoenixcontact.com/online/portal/ru?uri=pxc-oc-itemdetail:pid=1424659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 |  | 1943.84 ₽
│ | │ |  |  | │ | └ | ТУТнг-6/3 (КВТ) Черный |  |  |  |  |  |  |  |  |  |  |  |  |  |  | 0.1 | м
│ | │ |  |  | └ | Фиксированный большой поручень правый с кронштейном. Принадлежность. |  |  |  |  |  |  |  |  |  |  |  |  |  |  | АЕЖР.305435.031-05 | 1 | шт
│ | ├ | Комплект фиксированных малых поручней для изделия с кронштейном для встроенного пульта управления |  |  |  |  |  |  |  |  |  |  |  |  |  |  |  |  |  | АЕЖР.305111.006 | 1 | шт |  |  | 1.7
│ | │ | └ | Комплект фиксированных малых поручней для изделия с кронштейном для встроенного пульта управления (исполнение без подготовки под модуль СМ ЧСС) |  |  |  |  |  |  |  |  |  |  |  |  |  |  |  |  | АЕЖР.305111.017 | 1 | шт
│ | │ |  | ├ | Левый фиксированный малый поручень |  |  |  |  |  |  |  |  |  |  |  |  |  |  |  | АЕЖР-01.03.01.000 | 1 | шт
│ | │ |  | │ | └ | Фиксированный малый поручень левый. Принадлежность. |  |  |  |  |  |  |  |  |  |  |  |  |  |  | АЕЖР.305435.032-04 | 1 | шт
│ | │ |  | └ | Правый фиксированный малый поручень с кронштейном для встроенного пульта управления (исполнение без подготовки под модуль СМ ЧСС) (в сборе) |  |  |  |  |  |  |  |  |  |  |  |  |  |  |  | АЕЖР.305111.031 | 1 | шт
│ | │ |  |  | ├ | Правый фиксированный малый поручень с кронштейном для встроенного пульта управления (исполнение без подготовки под модуль СМ ЧСС) |  |  |  |  |  |  |  |  |  |  |  |  |  |  | АЕЖР-01.03.02.100 | 1 | шт
│ | │ |  |  | ├ | Кабель ХМИ |  |  |  |  |  |  |  |  |  |  |  |  |  |  | АЕЖР.685631.148 | 1 | шт
│ | │ |  |  | │ | ├ | Кабель встроенного пульта управления. Информационная наклейка. |  |  |  |  |  |  |  |  |  |  |  |  |  | АЕЖР.305435.067-01 | 1 | шт
│ | │ |  |  | │ | ├ | Кабель универсальный 2м |  |  |  |  |  |  |  |  |  |  |  |  |  | LAPP KABEL X05VV-F 5G0.5 | 2 | м |  | https://www.etm.ru/cat/nn/607080/ |  | 22.23 ₽
│ | │ |  |  | │ | ├ | Вилка кабельная 6к |  |  |  |  |  |  |  |  |  |  |  |  |  | FQ18-6TJ-6 | 1 | шт | Dafa | http://connector.su/parts/165/fq18-6tj-6-3699.html
│ | │ |  |  | │ | ├ | Разъем HMI кабельный |  |  |  |  |  |  |  |  |  |  |  |  |  | SACC-M12MR-5PL SH - 1424659 | 1 | шт | Феникс кабель папа угловой | https://www.phoenixcontact.com/online/portal/ru?uri=pxc-oc-itemdetail:pid=1424659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 |  | 1943.84 ₽
│ | │ |  |  | │ | └ | ТУТнг-6/3 (КВТ) Черный |  |  |  |  |  |  |  |  |  |  |  |  |  |  | 0.1 | м
│ | │ |  |  | └ | Фиксированный малый поручень правый с кронштейном. Принадлежность. |  |  |  |  |  |  |  |  |  |  |  |  |  |  | АЕЖР.305435.032-05 | 1 | шт
│ | ├ | Комплект регулируемых поручней для изделия с кронштейном для встроенного пульта управления |  |  |  |  |  |  |  |  |  |  |  |  |  |  |  |  |  | АЕЖР.305111.007 | 1 | шт |  |  | 1.8
│ | │ | └ | Комплект регулируемых поручней для изделия с кронштейном для встроенного пульта управления (исполнение без подготовки под модуль СМ ЧСС) |  |  |  |  |  |  |  |  |  |  |  |  |  |  |  |  | АЕЖР.305111.019 | 1 | шт
│ | │ |  | ├ | Левый регулируемый поручень |  |  |  |  |  |  |  |  |  |  |  |  |  |  |  | АЕЖР-01.04.01.000 | 1 | шт
│ | │ |  | │ | └ | Регулируемый поручень левый. Принадлежность. |  |  |  |  |  |  |  |  |  |  |  |  |  |  | АЕЖР.305435.033-04 | 1 | шт
│ | │ |  | └ | Правый регулируемый поручень с кронштейном для встроенного пульта управления (исполнение без подготовки под модуль СМ ЧСС) (в сборе) |  |  |  |  |  |  |  |  |  |  |  |  |  |  |  | АЕЖР.305111.032 | 1 | шт
│ | │ |  |  | ├ | Правый регулируемый поручень с кронштейном для встроенного пульта управления (исполнение без подготовки под модуль СМ ЧСС) |  |  |  |  |  |  |  |  |  |  |  |  |  |  | АЕЖР-01.04.02.100 | 1 | шт
│ | │ |  |  | ├ | Кабель ХМИ |  |  |  |  |  |  |  |  |  |  |  |  |  |  | АЕЖР.685631.148 | 1 | шт
│ | │ |  |  | │ | ├ | Кабель встроенного пульта управления. Информационная наклейка. |  |  |  |  |  |  |  |  |  |  |  |  |  | АЕЖР.305435.067-01 | 1 | шт
│ | │ |  |  | │ | ├ | Кабель универсальный 2м |  |  |  |  |  |  |  |  |  |  |  |  |  | LAPP KABEL X05VV-F 5G0.5 | 2 | м |  | https://www.etm.ru/cat/nn/607080/ |  | 22.23 ₽
│ | │ |  |  | │ | ├ | Вилка кабельная 6к |  |  |  |  |  |  |  |  |  |  |  |  |  | FQ18-6TJ-6 | 1 | шт | Dafa | http://connector.su/parts/165/fq18-6tj-6-3699.html
│ | │ |  |  | │ | ├ | Разъем HMI кабельный |  |  |  |  |  |  |  |  |  |  |  |  |  | SACC-M12MR-5PL SH - 1424659 | 1 | шт | Феникс кабель папа угловой | https://www.phoenixcontact.com/online/portal/ru?uri=pxc-oc-itemdetail:pid=1424659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 |  | 1943.84 ₽
│ | │ |  |  | │ | └ | ТУТнг-6/3 (КВТ) Черный |  |  |  |  |  |  |  |  |  |  |  |  |  |  | 0.1 | м
│ | │ |  |  | └ | Регулируемый поручень правый с кронштейном. Принадлежность. |  |  |  |  |  |  |  |  |  |  |  |  |  |  | АЕЖР.305435.033-05 | 1 | шт
│ | ├ | Комплект регулируемых малых (детских) поручней для изделия с кронштейном для встроенного пульта управления |  |  |  |  |  |  |  |  |  |  |  |  |  |  |  |  |  | АЕЖР.305111.034 | 1 | шт |  |  | 1.9
│ | ├ | Передняя дуга безопасности для фиксированных поручней |  |  |  |  |  |  |  |  |  |  |  |  |  |  |  |  |  | АЕЖР.305111.001 АЕЖР-01.08.00.000 -Дуга без. фикс. Пор | 1 | шт |  |  | 1.10
│ | │ | └ | Дуга безопасности фикс. Принадлежность. |  |  |  |  |  |  |  |  |  |  |  |  |  |  |  |  | АЕЖР.305435.034-01 | 1 | шт
│ | ├ | Передняя дуга безопасности для регулируемых поручней |  |  |  |  |  |  |  |  |  |  |  |  |  |  |  |  |  | АЕЖР.305111.008 АЕЖР-01.07.00.000 - Дуга безопасности для рег. Пор | 1 | шт |  |  | 1.11
│ | │ | └ | Дуга безопасности рег. Принадлежность |  |  |  |  |  |  |  |  |  |  |  |  |  |  |  |  | АЕЖР.305435.034-02 | 1 | шт
│ | ├ | Рампа для въезда инвалидной коляски |  |  |  |  |  |  |  |  |  |  |  |  |  |  |  |  |  | АЕЖР.305165.001 АЕЖР-01.05.00.000 - Рампа (Пандус) | 1 | шт |  |  | 1.12
│ | │ | ├ | Рампа |  |  |  |  |  |  |  |  |  |  |  |  |  |  |  |  | АЕЖР-01.05.00.100 | 1 | шт
│ | │ | ├ | Кронштейн |  |  |  |  |  |  |  |  |  |  |  |  |  |  |  |  | АЕЖР-01.05.00.200 | 1 | шт
│ | │ | ├ | Кронштейн |  |  |  |  |  |  |  |  |  |  |  |  |  |  |  |  | АЕЖР-01.05.00.200-01 | 1 | шт
│ | │ | └ | Рампа для инв. коляски. Принадлежность. |  |  |  |  |  |  |  |  |  |  |  |  |  |  |  |  | АЕЖР.305435.035 | 1 | шт
│ | ├ | Комплект дополнительных регулируемых упоров для рук |  |  |  |  |  |  |  |  |  |  |  |  |  |  |  |  |  | АЕЖР.301319.001 АЕЖР-01.10.00.000 - Доп. регулируемые упоры | 1 | шт |  |  | 1.13
│ | │ | ├ | Упор левый |  |  |  |  |  |  |  |  |  |  |  |  |  |  |  |  |  | 1 | шт
│ | │ | ├ | Упор для рук левый. Принадлежность. |  |  |  |  |  |  |  |  |  |  |  |  |  |  |  |  | АЕЖР.305435.036-02 | 1 | шт
│ | │ | ├ | Упор правый |  |  |  |  |  |  |  |  |  |  |  |  |  |  |  |  |  | 1 | шт
│ | │ | └ | Упор для рук правый. Принадлежность. |  |  |  |  |  |  |  |  |  |  |  |  |  |  |  |  | АЕЖР.305435.036-01 | 1 | шт
│ | ├ | Дополнительная перемычка |  |  |  |  |  |  |  |  |  |  |  |  |  |  |  |  |  | АЕЖР.305111.035 АЕЖР-01.04.09.000 | 1 | шт |  |  | 1.14
│ | ├ | Опора верёвочная |  |  |  |  |  |  |  |  |  |  |  |  |  |  |  |  |  | АЕЖР.305111.036 АЕЖР-01.04.08.000 | 1 | шт |  |  | 1.15
│ | ├ | Трансформатор разделительный 2,5 кВА |  |  |  |  |  |  |  |  |  |  |  |  |  |  |  |  |  | АЕЖР.436228.002 | 1 | шт |  |  | 1.27
│ | │ | ├ | Плата мягкого пуска трансформатора (Печатный узел) |  |  |  |  |  |  |  |  |  |  |  |  |  |  |  |  | АЕЖР.436222.001-01 | 1 | шт | REATECH |  |  | 1100.00 ₽
│ | │ | │ | ├ | Плата мягкого пуска трансформатора |  |  |  |  |  |  |  |  |  |  |  |  |  |  |  | АЕЖР.687253.013-01 | 1 | шт
│ | │ | │ | ├ | Конденсатор JFB 1,0 мкФ - 630 В (JB capacitors) |  |  |  |  |  |  |  |  |  |  |  |  |  |  |  | JFB02J105K275000B | 1 | шт
│ | │ | │ | ├ | Конденсатор SH 470 мкФ - 35 В (10х15) |  |  |  |  |  |  |  |  |  |  |  |  |  |  |  | SH035M0470A5S-1015 | 1 | шт
│ | │ | │ | ├ | Керам. ЧИП конд. 0,1 мкФ - 50 В - X7R - 10 % - 0805 |  |  |  |  |  |  |  |  |  |  |  |  |  |  |  | GRM21BR71H104KA01L | 2 | шт
│ | │ | │ | ├ | Тант. ЧИП конденсатор 10 мкФ - 50 В - тип D |  |  |  |  |  |  |  |  |  |  |  |  |  |  |  | TR3D106K050D0700 | 1 | шт
│ | │ | │ | ├ | Микросхема LM78L12AC, TO-92 |  |  |  |  |  |  |  |  |  |  |  |  |  |  |  | LM78L12AC, TO-92 | 1 | шт
│ | │ | │ | ├ | Микросхема NE555D, SO-8 |  |  |  |  |  |  |  |  |  |  |  |  |  |  |  | NE555D, SO-8 | 1 | шт
│ | │ | │ | ├ | Резистор проволочный SQP 300 Ом - 10Вт - 5% |  |  |  |  |  |  |  |  |  |  |  |  |  |  |  | SQP10-300R | 1 | шт
│ | │ | │ | ├ | Резистор 270 кОм - 3,0 Вт - 5% |  |  |  |  |  |  |  |  |  |  |  |  |  |  |  | PR03000202703JAC00 | 1 | шт
│ | │ | │ | ├ | Термистор NTC 0.5Ом - 50А - 900Дж |  |  |  |  |  |  |  |  |  |  |  |  |  |  |  | MS35 0R550 | 1 | шт
│ | │ | │ | ├ | Чип резистор 1,2 кОм - 0,125 Вт - 5 % - 0805 |  |  |  |  |  |  |  |  |  |  |  |  |  |  |  | RC0805JR-071K2L | 1 | шт
│ | │ | │ | ├ | Чип резистор 180 кОм - 0,125 Вт - 5% - 0805 |  |  |  |  |  |  |  |  |  |  |  |  |  |  |  | RC0805JR-07180KL | 1 | шт
│ | │ | │ | ├ | Реле электромеханическое G8P1A4P12DC, 12В - 30А, 250В |  |  |  |  |  |  |  |  |  |  |  |  |  |  |  | G8P1A4P12DC | 1 | шт
│ | │ | │ | ├ | Мост диодный DB104, DB-1 |  |  |  |  |  |  |  |  |  |  |  |  |  |  |  | DB104, DB-1 | 1 | шт
│ | │ | │ | ├ | Стабилитрон 1N4746A, DO-41(G) |  |  |  |  |  |  |  |  |  |  |  |  |  |  |  | 1N4746A, DO-41(G) | 1 | шт
│ | │ | │ | ├ | Диод US1M, SMA |  |  |  |  |  |  |  |  |  |  |  |  |  |  |  | US1M, SMA | 2 | шт
│ | │ | │ | ├ | Транзистор BC817-40, SOT-23 |  |  |  |  |  |  |  |  |  |  |  |  |  |  |  | BC817-40, SOT-23 | 1 | шт
│ | │ | │ | └ | Клеммник барьерный DG78C-B-06P-13-00A(H) |  |  |  |  |  |  |  |  |  |  |  |  |  |  |  | DG78C-B-06P-13-00A(H) | 1 | шт
│ | │ | ├ | Модификация наконечников трансформатора |  |  |  |  |  |  |  |  |  |  |  |  |  |  |  |  | АЕЖР.671117.002 | 1 | шт | REATECH
│ | │ | │ | ├ | Трансформатор разделительный (крепление 4-а) (Выводы обмоток длиной 60см без клемника и кронштейна под него)(изол.3,5кВ) |  |  |  |  |  |  |  |  |  |  |  |  |  |  |  | ОСМ Т 220/220-2,5-50 | 1 | шт | ПЗСТ | http://www.inels.ru/item_transformator-shtil-osm-t-220-uvt-2-5-50-dlya-kol-3-4-sht/ |  | 9995.00 ₽
│ | │ | │ | ├ | Наконечник кабельный НВИ 1.5-3 (КВТ) |  |  |  |  |  |  |  |  |  |  |  |  |  |  |  | НВИ 1.5-3 (КВТ) | 2 | шт
│ | │ | │ | ├ | Наконечник кабельный НШВИ 1.5-8 (КВТ) |  |  |  |  |  |  |  |  |  |  |  |  |  |  |  | НШВИ 1.5-8 (КВТ) | 2 | шт
│ | │ | │ | └ | ТУТнг-8/4 (КВТ) Черный |  |  |  |  |  |  |  |  |  |  |  |  |  |  |  |  | 0.35 | м
│ | │ | ├ | Провод заземления розетка блочная - болт заземления |  |  |  |  |  |  |  |  |  |  |  |  |  |  |  |  | АЕЖР.685611.042 | 1 | шт | REATECH
│ | │ | │ | ├ | Провод ПВ-3 1.5 мм2 Желтый |  |  |  |  |  |  |  |  |  |  |  |  |  |  |  |  | 0.13 | м
│ | │ | │ | ├ | Наконечник кабельный РПИ-М 1.5-7-0.8 (КВТ) |  |  |  |  |  |  |  |  |  |  |  |  |  |  |  | РПИ-М 1.5-7-0.8 (КВТ) | 1 | шт
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
