RungeKut/thermocirculator/hardware/3DC-/Панель тцс.dxf

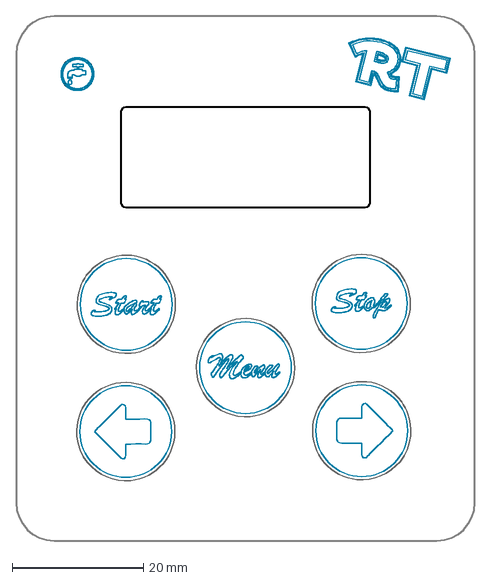
[picture p7: CAD file, 2026-09-17]
hardware/3DC-/Панель тцс.dxf
70.0 x 80.0 mm
