RungeKut/thermocirculator/hardware/Job2.PDF

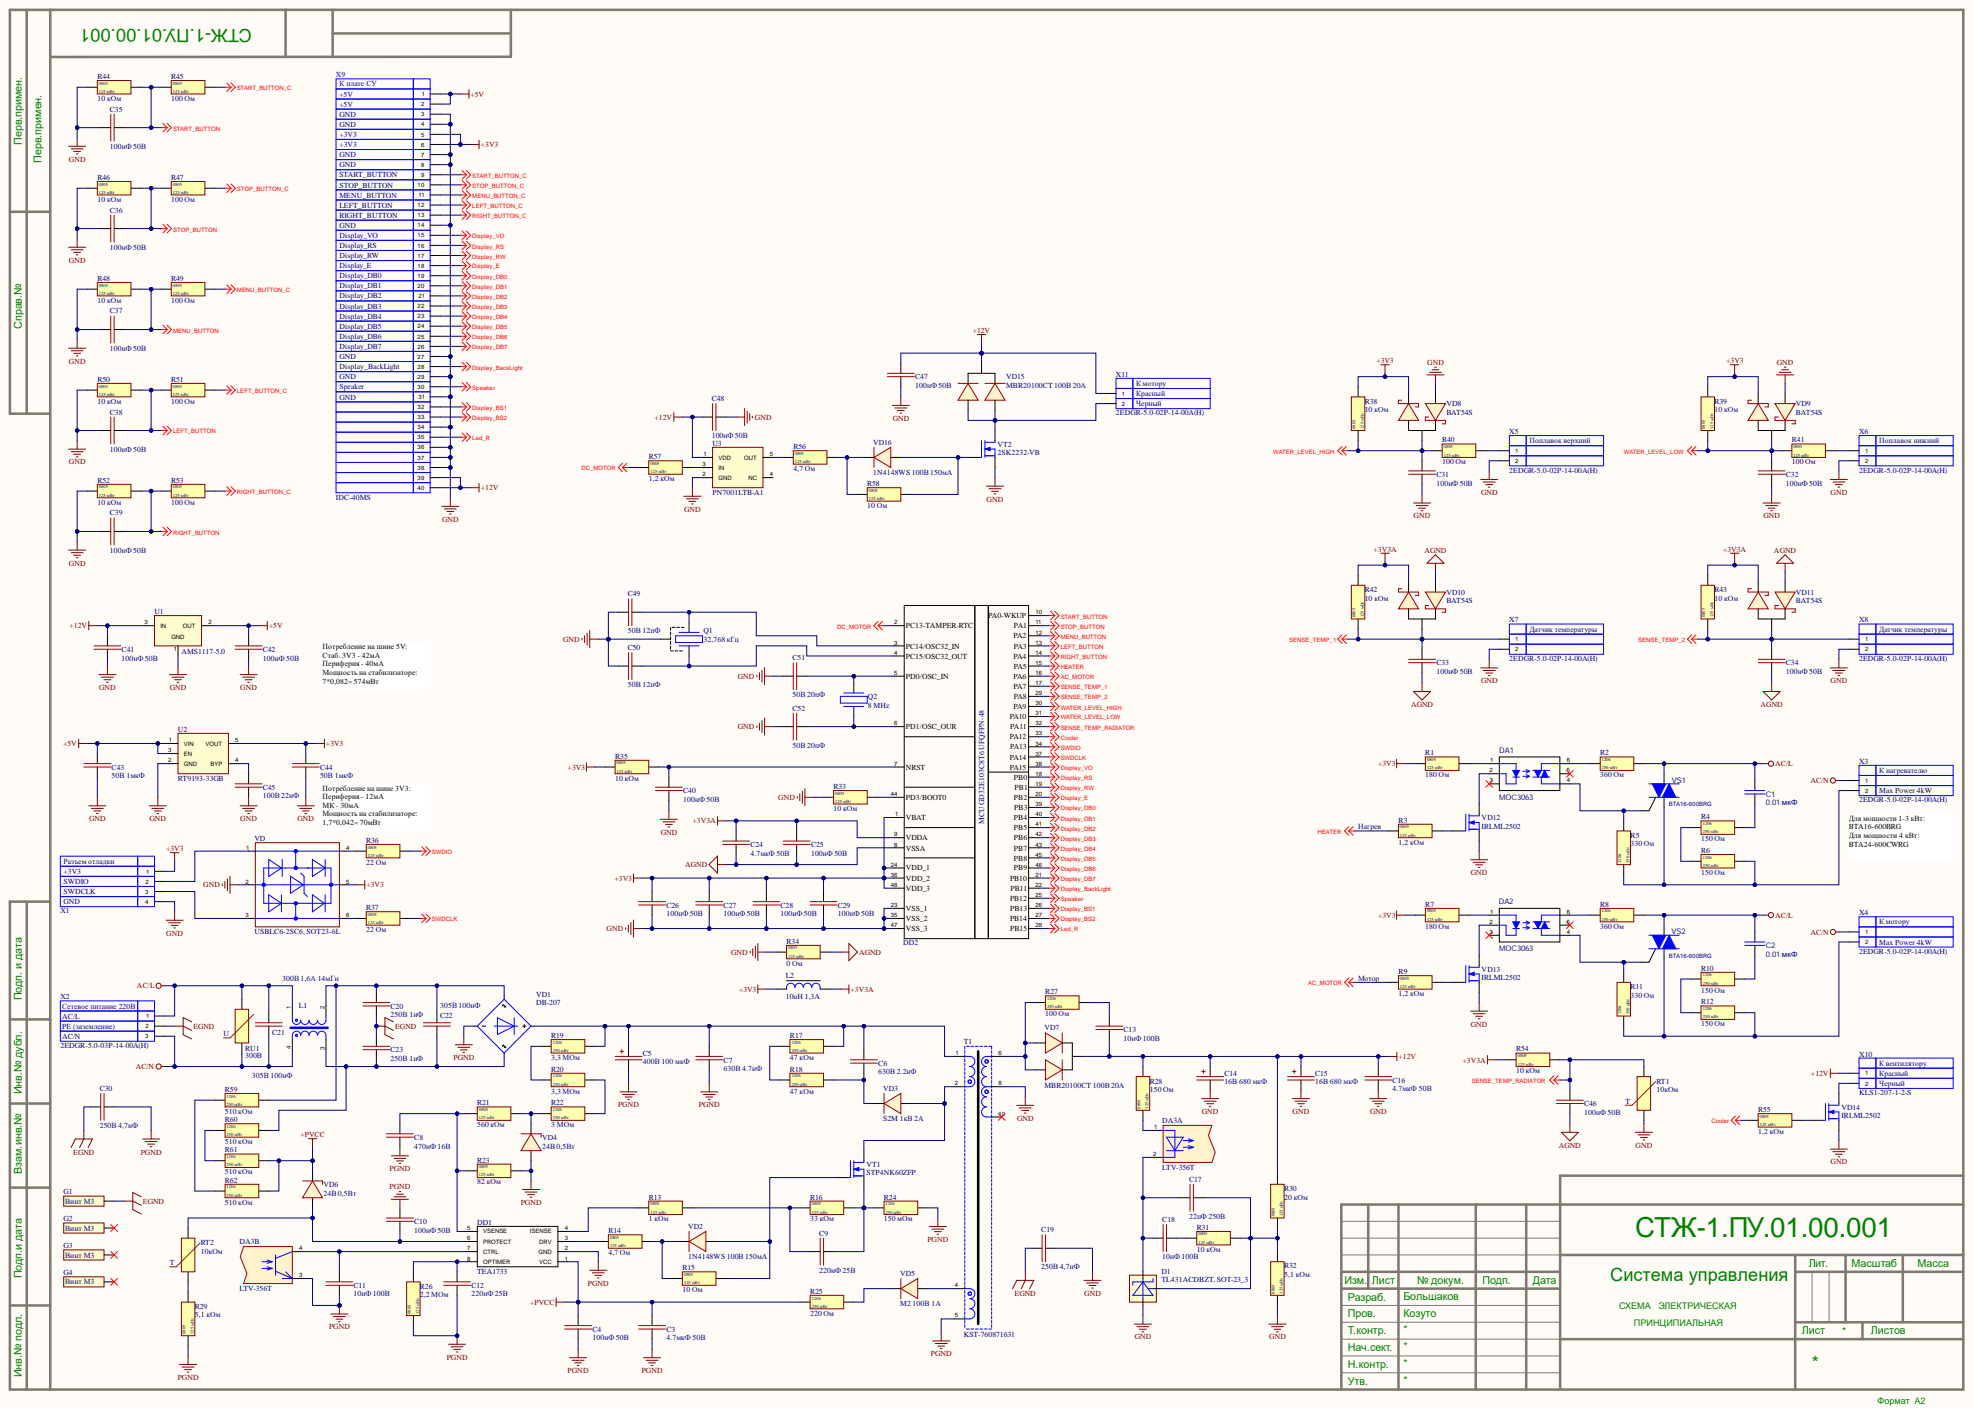
[picture p8: page 1]

+5V | 1
+5V | 2
GND | 3
GND | 4

GND | 8
START_BUTTON | 9

MENU_BUTTON | 11
LEFT_BUTTON | 12
RIGHT_BUTTON | 13
GND | 14

Display_E | 18
Display_DB0 | 19

Display_DB2 | 21
Display_DB3 | 22
Display_DB4 | 23
Display_DB5 | 24

Display_BackLight | 28
GND | 29

К мотору

32
33
34

GND 2

Сетевое питание 220В
AC/L | 1

К вентилятору

л. Подп.и дата Взам.инв.№

Т.контр. | * | Лист * | Листов
Нач.сект. | * | *

Description | Designator | LibRef | Quantity
Конденсатор К73-17, JFA02G104J 0.01мкФ 400 В 5% | C1, C2 | К73-17 0.1мкФ, 400В,
5%, JFA02G104J | 2
Конденсатор 1206 10% 50В 4.7мкФ X7R | C3, C16, C24 | CC1206KKX7R9BB475 | | 3
Конденсатор 0805 10% 50В 100нФ X7R | C4, C10, C25, C26, C27, C28, C29, C31, C32, C33, C34, C35, C36, C37, C38, C39, C40, C41, C42, C46, C47, C48 | GRM21BR71H104KA0 1L | 22
Конденсатор Эл-лит. 20% 400В 100мкФ | C5 | JNE2G101M10002200 250 | | 1
Конденсатор 1206 10% 630В 2.2нФ X7R | C6 | GRM31BR72J222KW0 1L | | 1
Конденсатор 1206 10% 630В 4.7нФ X7R | C7 | GRM31BR72J472KW0 1L | | 1
Конденсатор 0805 10% 16В 470нФ X7R | C8 | GRM219R71C474K | | 1
Конденсатор 0805 10% 25В 220нФ X7R | C9, C12 | GRM219R71E224K | | 2
Конденсатор 0805 10% 100В 10нФ X7R | C11, C13, C18 | GRM21BR72A103KA0 1L | | 3
Конденсатор Эл-лит. 20% 16В 680мкФ | C14, C15 | JRC1C681M035008001 60000B | | 2
Конденсатор 0805 10% 250В 22пФC0G | C17 | GRM21A5C2E220J | | 1
Конденсатор X1/Y1 20% 250В 4,7нФ | C19, C30 | DE1E3KX472MN4AN0 1F | | 2
Конденсатор X1/Y1 20% 250В 1нФ | C20, C23 | DE1E3KX102MA4BN0 1F | | 2
Конденсатор X2 Пропилен 10% 305В 100нФ | C21, C22 | B32922C3104K000 | | 2
Конденсатор 0805 10% 50В 1мкФ X7R | C43, C44 | GRM21BR71H105KA1 2L | | 2
Конденсатор 0805 10% 100В 22нФ X7R | C45 | GRM21BR72A223KA0 1L | | 1
Конденсатор 0603 05% 50В 12пФNP0 | C49, C50 | CC0603JRNPO9BN120 | | 2
Конденсатор 0805 05% 50В 20пФNP0 | C51, C52 | CC0805JRNPO9BN200 | | 2
ИОН TL431ACDBZT, SOT-23_3 | D1 | TL431ACDBZT, SOT-23_3 | | 1
Оптосимистор MOC3063, DIP6 zero-cross | DA1, DA2 | MOC3063 | | 2
Оптрон PC817, DIP-4 | DA3 | LTV-356T | | 1
AC/DC TEA1733, SO8 | DD1 | TEA1733 | | 1
Микроконтроллер | DD2 | GD32E103C8T6 | | 1
Фильтр ЭМП 300В 1,6А 14мГн | L1 | PLY10AN1521R6R2 | | 1
Дроссель 10% 10uH 1,3A | L2 | CD54-100K | | 1
Кварцевый резонатор 32,768 кГц | Q1 | DT-26 | | 1
Кварцевый резонатор 8MHz HC49 | Q2 | L-KLS14-HC-49S-8.000-20-30-A | | 1
Резистор 0805 5% 180Ом | R1, R7 | RC0805JR-07180RL | | 2
Резистор 1206 5% 360Ом | R2, R8 | RC1206JR-07360RL | | 2
Резистор 0805 5% 1,2 кОм | R3, R9, R55, R57 | RC0805JR-071K2L | | 4
Резистор 1206 5% 150Ом | R4, R6, R10, R12 | RC1206JR-07150RL | | 4
Резистор 1206 5% 330Ом | R5, R11 | RC1206JR-07330RL | | 2
Резистор 0805 5% 1 кОм | R13 | RC0805JR-071KL | | 1
Резистор 0805 5% 4,7 Ом | R14, R56 | RC0805JR-074R7L | | 2
Резистор 0805 5% 10 Ом | R15, R58 | RC0805JR-0710RL | | 2
Резистор 0805 5% 33 кОм | R16 | RC0805JR-0733KL | | 1
Резистор 1206 5% 47 кОм | R17, R18 | RC1206JR-0747КL | | 2
Резистор 1206 5% 3,3 МОм | R19, R20 | RC1206JR-073M3L | | 2
Резистор 0805 5% 560 кОм | R21 | RC0805JR-07560KL | | 1
Резистор 1206 5% 3 МОм | R22 | RC1206JR-073ML | | 1
Резистор 0805 5% 82 кОм | R23 | RC0805JR-0782KL | | 1
Резистор 1206 1% 150мОм импульсный | R24 | ERJ8BSFR15V | | 1
Резистор 1206 1% 220Ом | R25 | RC1206FR-07220RL | | 1
Резистор 0805 5% 2,2 МОм | R26 | RC0805JR-072M2L | | 1
Резистор 1206 5% 100Ом | R27 | RC1206JR-07100RL | | 1
Резистор 0805 5% 150Ом | R28 | RC0805JR-07150KL | | 1
Резистор 0805 5% 5,1 кОм, Резистор 0805 1% 5,1 кОм | R29, R32 | RC0805JR-075K1L, RC0805FR-075K1L | | 2
Резистор 0805 1% 20 кОм | R30 | RC0805FR-0720KL | | 1
Резистор 0805 5% 10 кОм | R31, R33, R35, R38, R39, R42, R43, R44, R46, R48, R50, R52, R54 | RC0805JR-0710KL | 13
Резистор 0805 5% 0 Ом | R34 | RC0805JR-070RL | | 1
Резистор 0805 5% 22 Ом | R36, R37 | RC0805JR-0722RL | | 2
Резистор 0805 5% 100Ом | R40, R41, R45, R47, R49, R51, R53 | RC0805JR-07100RL | | 7
Резистор 1206 5% 510 кОм | R59, R60, R61, R62 | RC1206JR-07510KL | | 4
Термистор 1% 10кОм | RT1, RT2 | B57861-S 103-F40 | | 2
Варистор 10% 300В 300пФ50А | RU1 | B72214S0301K101 | | 1
Трансформатор KST-760871631 | T1 | KST-760871631 | | 1
Лин. Стаб. 5V 800mA | U1 | AMS1117-5.0 | | 1
Лин. Стаб. 3.3V 300mA | U2 | RT9193-33GB | | 1
Драйвер MOSFET 25V 3.5A | U3 | PN7001LTB-A1 | | 1
Диод USBLC6-2SC6, SOT23-6L | VD | USBLC6-2SC6, SOT23-6L | | 1
Диодный мост DB-207 | VD1 | DB-207 | | 1
Диод SOD-323 100В 150мА | VD2, VD16 | 1N4148WS | | 2
Диод SMA 1кВ 2А | VD3 | S2M | | 1
Стабилитрон miniMELF 24В 0,5Вт | VD4, VD6 | BZV55C24 | | 2
Диод SMA 100В 1А | VD5 | M2 | | 1
Диод TO220 100В 20А | VD7, VD15 | MBR20100CT | | 2
Диод BAT54S | VD8, VD9, VD10, VD11 | BAT54S | | 4
Транзистор MOSFET N-Channel 20В 4.2А | VD12, VD13, VD14 | IRLML2502 | | 3
Симистор BTA16-600BRG, TO-220AB | VS1, VS2 | BTA16-600BRG, TO-220AB | | 2
Транзистор MOSFET N-Ch 600В 4А | VT1 | STP4NK60ZFP | | 1
Транзистор MOSFET N-Ch 60В 45А | VT2 | 2SK2232-VB | | 1
Разъем PLS-4, шаг 2.54мм | X1 | PLS-4 | | 1
Разъем 2EDGR-5.0-03P-14-00A(H) | X2 | 2EDGR-5.0-03P-14-00A(H) | | 1
Разъем 2EDGR-5.0-02P-14-00A(H) | X3, X4, X5, X6, X7, X8, X11 | 2EDGR-5.0-02P-14-00A(H) | | 7
Разъем шлейф на плату 40 pin шаг 2.54 мм | X9 | BH-40 (DS1013-40S) (IDC-40MS) | | 1
Разъем PLS-2, шаг 2.54мм | X10 | KLS1-207-1-2-S | | 1
