RungeKut/thermocirculator/hardware/СТЖ-1.ПУ.02.00.001 - Плата панели управления/КД/СТЖ-1.ПУ.02.00.001 СБ.PDF

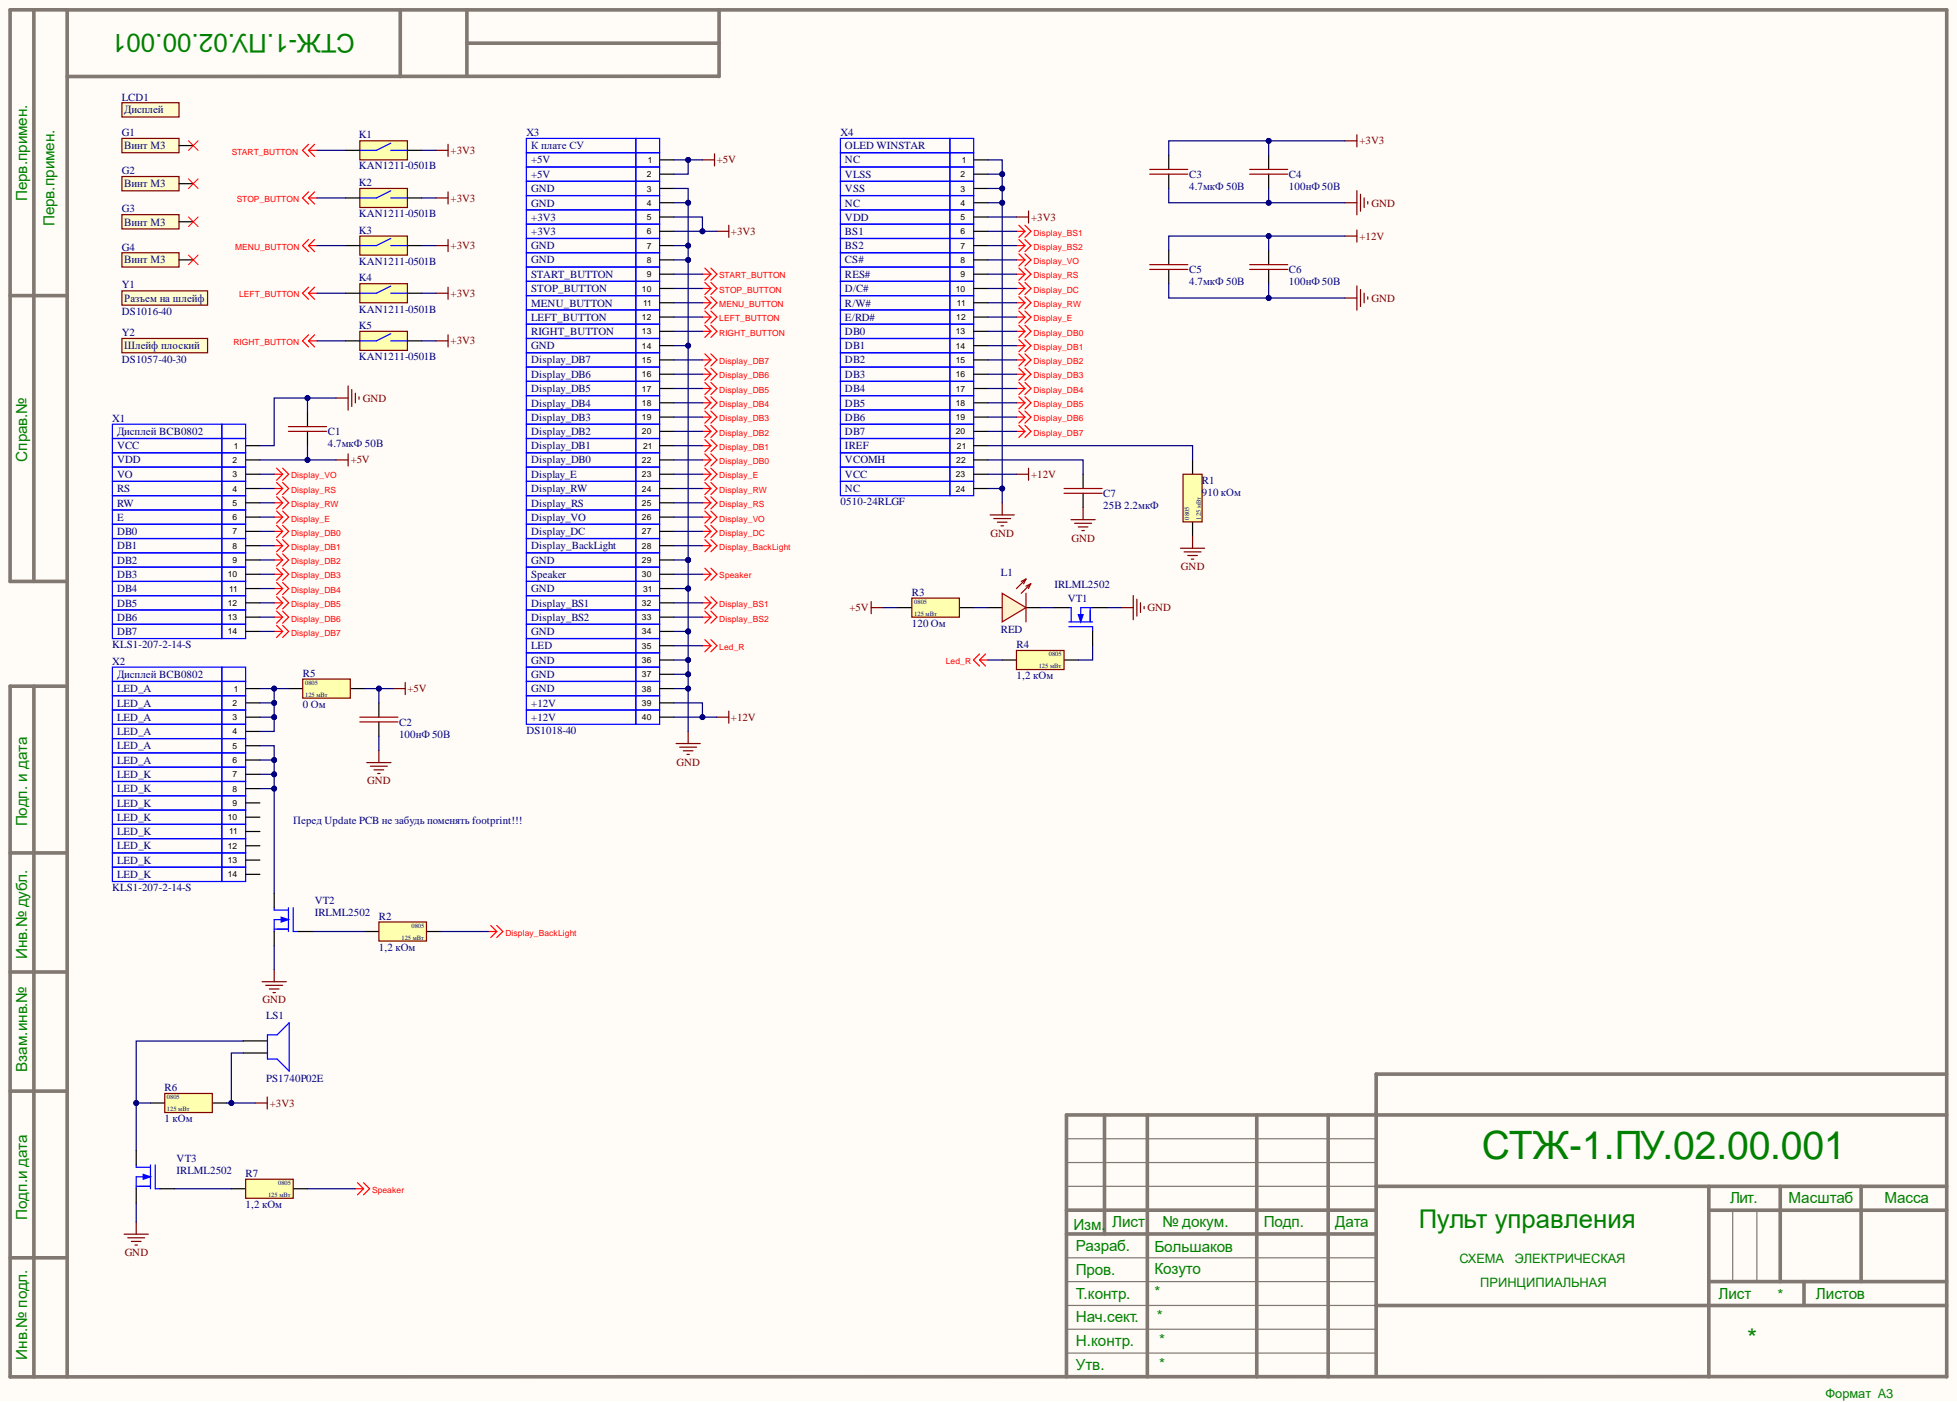
[picture p14: page 1]

LED_A | 3 | +12V | 40

LED_A | 4
LED_A | 5

LED_A | 6
LED_K | 7
LED_K | 8

LED_K | 9
LED_K | 10

Перед Update PCB не забудь поменять footprint!!!

LED_K | 11
LED_K | 12

LED_K | 13
LED_K | 14

л. Подп.и дата Взам.инв.№

125 мВт

СТЖ-1.ПУ.02.00.001

Пульт управления СХЕМА ЭЛЕКТРИЧЕСКАЯ ПРИНЦИПИАЛЬНАЯ | Лит. | Масштаб | Масса
Изм. | Лист | № докум. | Подп. | Дата

Пров. | Козуто

Т.контр. | * | Лист * | Листов
Нач.сект. | * | *
Н.контр. | *
Утв. | *

Description | Designator | LibRef | Quantity
Конденсатор 1206 10% 50В 4.7мкФ X7R | C1, C3, C5 | CC1206KKX7R9BB475 | 3
Конденсатор 0805 10% 50В 100нФ X7R | C2, C4, C6 | GRM21BR71H104KA0 1L | 3
Конденсатор 0805 10% 25В 2.2мкФ X7R | C7 | GRM21BR71E225KA73 L | 1
Кнопка тактовая 12x12x5 | K1, K2, K3, K4, K5 | KAN1211-0501B | 5
Светодиод 0805 RED 2,5В 230мКд | L1 | KP-2012SURCK | 1
Loudspeaker or Buzzer | LS1 | PS1740P02E | 1
Резистор 0805 5% 910 кОм | R1 | RC0805JR-07910KL | 1
Резистор 0805 5% 1,2 кОм | R2, R4, R7 | RC0805JR-071K2L | 3
Резистор 0805 5% 120Ом | R3 | RC0805JR-07120RL | 1
Резистор 0805 5% 0 Ом | R5 | RC0805JR-070RL | 1
Резистор 0805 5% 1 кОм | R6 | RC0805JR-071KL | 1
Транзистор MOSFET N-Channel 20В 4.2А | VT1, VT2, VT3 | IRLML2502 | 3
Разъем PLS-14, шаг 2.54мм | X1 | KLS1-207-2-14-S | 1
Разъем PLS-14, шаг 2.54мм | X2 | KLS1-207-2-14-S | 1
Разъем шлейф, шаг 2.54мм | X3 | FDC-40 (DS1018-40) | 1
Разъем FPC Flip-Lock 24p 0,5мм | X4 | 0510-24RLGF | 1

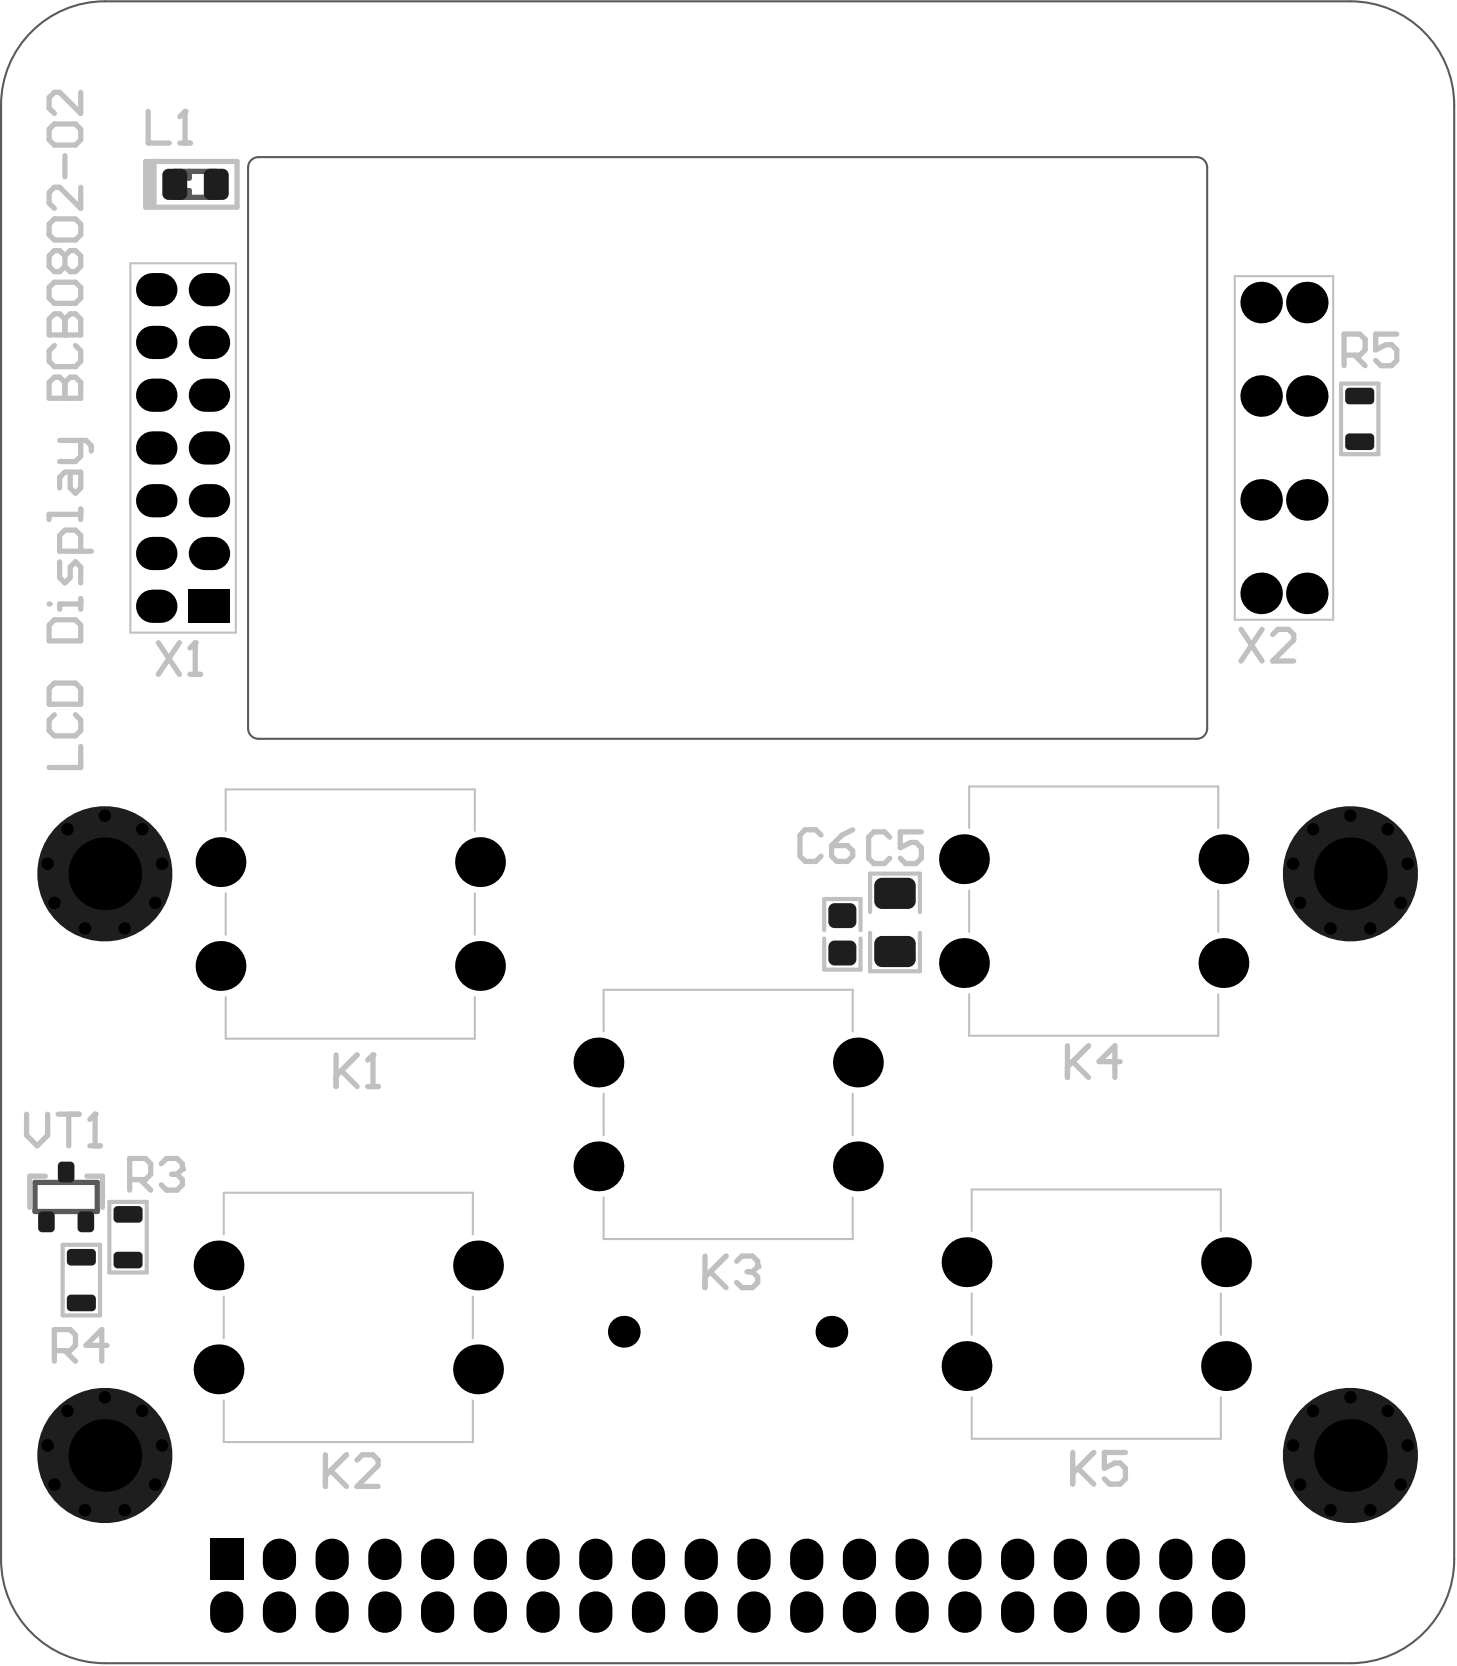
[picture p15: page 3]

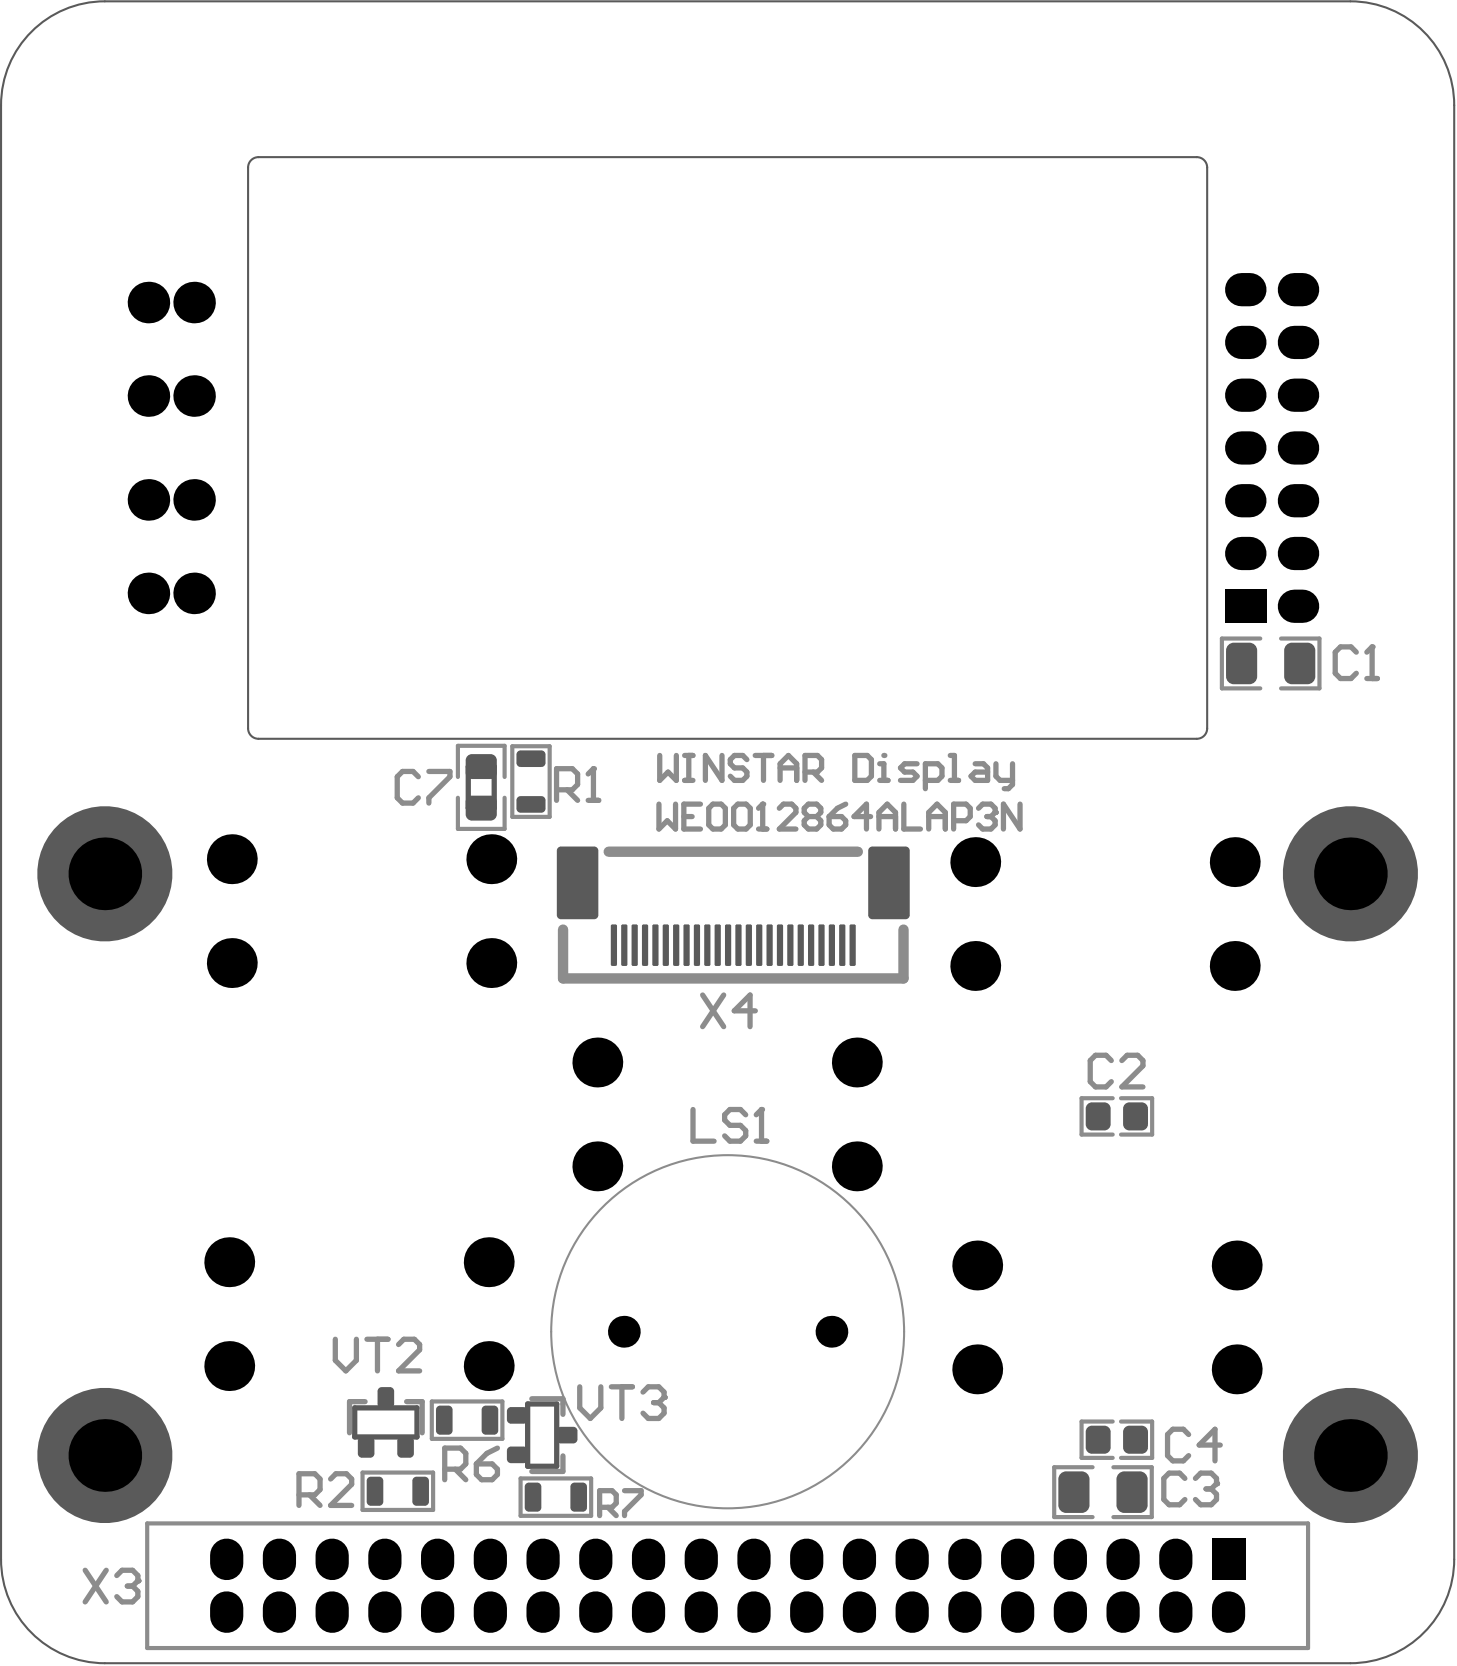
[picture p16: page 4]

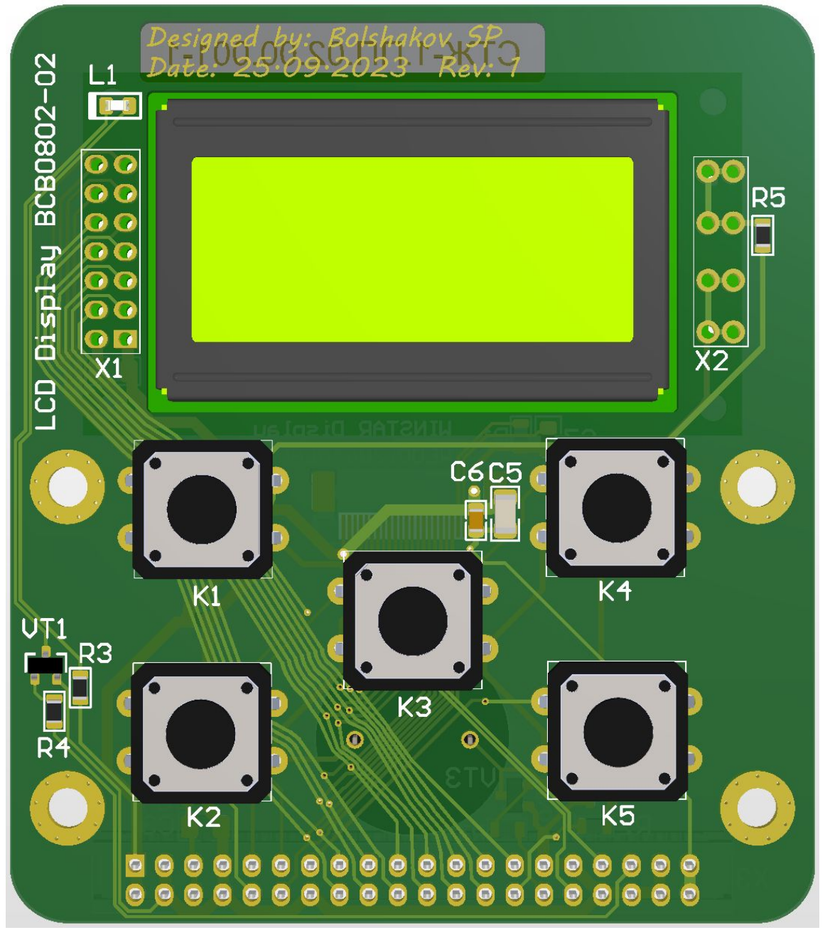
[picture p17: page 5]

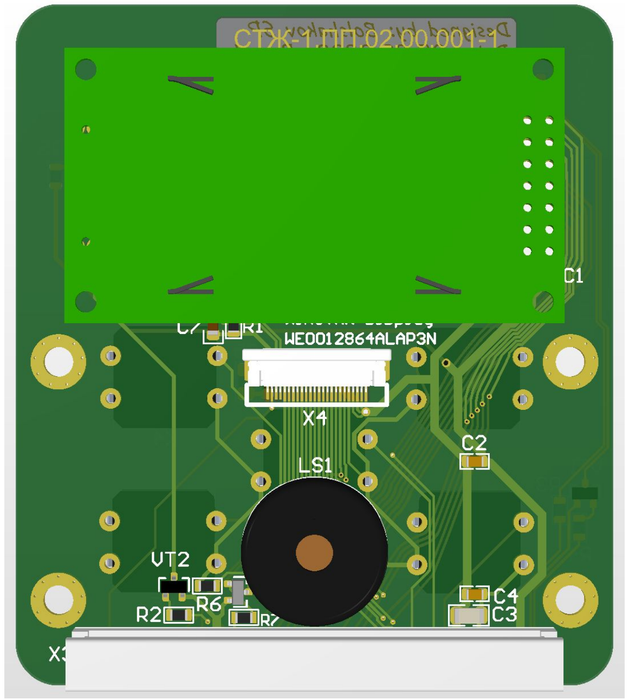
[picture p18: page 6]
