RungeKut/thermocirculator/hardware/СТЖ-1.ПУ.01.00.001 - Плата системы управления/КД/HS183-70 СБ.pdf

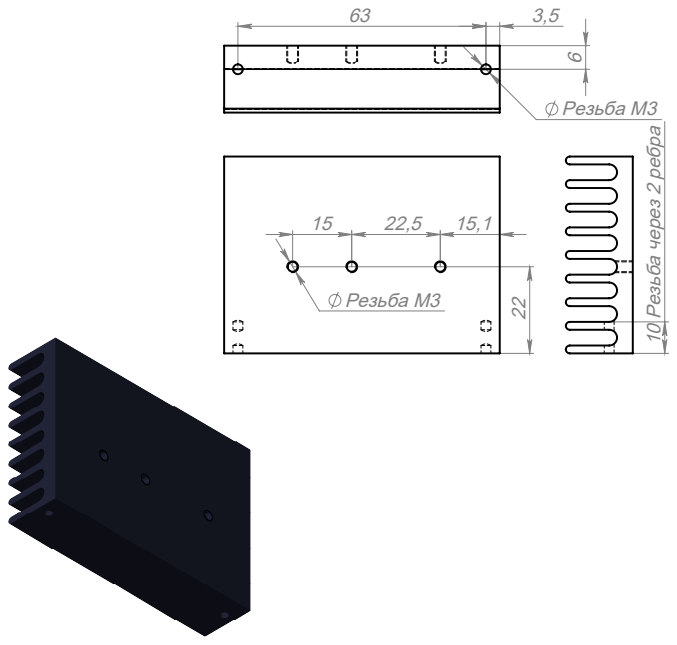
[picture p19: page 1]
Резьба М3

Резьба М3 10 Резьба через 2 ребра
