RungeKut/thermocirculator/(list of files, drawings)

Other design files:
hardware/СТЖ-1.ПУ.01.00.001 - Плата системы управления/Altium/СТЖ-1-ПУ-01-00-001 - Плата системы управления.PrjPcb
hardware/СТЖ-1.ПУ.01.00.001 - Плата системы управления/Altium/СТЖ-1-ПУ-01-00-001.SchDoc
hardware/СТЖ-1.ПУ.02.00.001 - Плата панели управления/Altium/СТЖ-1-ПП-02-00-001-1.PcbDoc
hardware/СТЖ-1.ПУ.02.00.001 - Плата панели управления/Altium/СТЖ-1-ПУ-02-00-001 - Плата пульта управления.PrjPcb
hardware/СТЖ-1.ПУ.02.00.001 - Плата панели управления/Altium/СТЖ-1-ПУ-02-00-001.SchDoc
