RungeKut/thermocirculator/STM32L072CBT6/Core/Src/main.c

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
/* Includes ------------------------------------------------------------------*/
#include "main.h"
#include "adc.h"
#include "rtc.h"
#include "tim.h"
#include "gpio.h"

/* USER CODE BEGIN Includes */
#include "LCD1602.h"
#include "user_interface.h"
#include "temperature_measurement.h"
/* USER CODE END Includes */


void SystemClock_Config(void);
/**
  * @brief  The application entry point.
  * @retval int
  */
int main(void)
{
  /* MCU Configuration--------------------------------------------------------*/

  /* Reset of all peripherals, Initializes the Flash interface and the Systick. */
  HAL_Init();

  /* USER CODE BEGIN Init */
  HAL_Delay(500);
  /* USER CODE END Init */

  /* Configure the system clock */
  SystemClock_Config();

  /* Initialize all configured peripherals */
  MX_GPIO_Init();
  MX_RTC_Init();
  MX_ADC_Init();
  MX_TIM2_Init();
  /* USER CODE BEGIN 2 */
	//HAL_GPIO_WritePin(DISP_VO_GPIO_Port, DISP_VO_Pin, GPIO_PIN_SET);
	//__HAL_RTC_ALARM_ENABLE_IT(&hrtc, RTC_IT_ALRA);
	
	TempMeasInit();
	LCD_Init();
	Greeting();
	
  /* USER CODE END 2 */

  /* Infinite loop */
  /* USER CODE BEGIN WHILE */
  while (1)
  {
		UserInterfaceExecuter();
    /* USER CODE END WHILE */

    /* USER CODE BEGIN 3 */
  }
  /* USER CODE END 3 */
}

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
