RungeKut/thermocirculator/STM32L071CBT6/Core/Inc/main.h

#define WATER_LEVEL_LOW_Pin GPIO_PIN_13
#define WATER_LEVEL_LOW_GPIO_Port GPIOC
#define SENSE_TEMP_2_Pin GPIO_PIN_0
#define SENSE_TEMP_2_GPIO_Port GPIOA
#define SENSE_TEMP_1_Pin GPIO_PIN_1
#define SENSE_TEMP_1_GPIO_Port GPIOA
#define SENSE_TEMP_RADIATOR_Pin GPIO_PIN_2
#define SENSE_TEMP_RADIATOR_GPIO_Port GPIOA
#define WATER_LEVEL_HIGH_Pin GPIO_PIN_3
#define WATER_LEVEL_HIGH_GPIO_Port GPIOA
#define START_BUTTON_Pin GPIO_PIN_4
#define START_BUTTON_GPIO_Port GPIOA
#define STOP_BUTTON_Pin GPIO_PIN_5
#define STOP_BUTTON_GPIO_Port GPIOA
#define MENU_BUTTON_Pin GPIO_PIN_6
#define MENU_BUTTON_GPIO_Port GPIOA
#define LEFT_BUTTON_Pin GPIO_PIN_7
#define LEFT_BUTTON_GPIO_Port GPIOA
#define RIGHT_BUTTON_Pin GPIO_PIN_0
#define RIGHT_BUTTON_GPIO_Port GPIOB
#define AC_MOTOR_Pin GPIO_PIN_1
#define AC_MOTOR_GPIO_Port GPIOB
#define HEATER_Pin GPIO_PIN_2
#define HEATER_GPIO_Port GPIOB
#define DISP_DB2_Pin GPIO_PIN_10
#define DISP_DB2_GPIO_Port GPIOB
#define LED_R_Pin GPIO_PIN_11
#define LED_R_GPIO_Port GPIOB
#define DISP_RS_Pin GPIO_PIN_14
#define DISP_RS_GPIO_Port GPIOB
#define COOLER_Pin GPIO_PIN_8
#define COOLER_GPIO_Port GPIOA
#define DC_MOTOR_Pin GPIO_PIN_9
#define DC_MOTOR_GPIO_Port GPIOA
#define BACKLIGHT_Pin GPIO_PIN_10
#define BACKLIGHT_GPIO_Port GPIOA
#define DISP_E_Pin GPIO_PIN_11
#define DISP_E_GPIO_Port GPIOA
#define DISP_RW_Pin GPIO_PIN_12
#define DISP_RW_GPIO_Port GPIOA
#define SPEAKER_Pin GPIO_PIN_15
#define SPEAKER_GPIO_Port GPIOA
#define DISP_DB3_Pin GPIO_PIN_3
#define DISP_DB3_GPIO_Port GPIOB
#define DISP_DB4_Pin GPIO_PIN_4
#define DISP_DB4_GPIO_Port GPIOB
#define DISP_DB5_Pin GPIO_PIN_5
#define DISP_DB5_GPIO_Port GPIOB
#define DISP_DB7_Pin GPIO_PIN_8
#define DISP_DB7_GPIO_Port GPIOB
#define DISP_DB6_Pin GPIO_PIN_9
#define DISP_DB6_GPIO_Port GPIOB
