RungeKut/thermocirculator/STM32L071CBT6/LCD1602/LCD1602_config.h

/*
	
  ******************************************************************************
  * @file 			( фаил ):   LCD1602_config.h
  * @brief 		( описание ):  	
  ******************************************************************************
  * @attention 	( внимание ):	author: Golinskiy Konstantin	e-mail: golinskiy.konstantin@gmail.com
  ******************************************************************************
  
*/

#ifndef _LCD1602_CONFIG_H
#define _LCD1602_CONFIG_H

#ifdef __cplusplus
extern "C" {
#endif

/* Includes ----------------------------------------------------------*/

#include "main.h"


/*
	//===============================================================================================
	4 битный режим ( подключение ):
	----------------------------------
	1) GND(VSS) - земля
	2) VDD 	- +5V питание
	3) V0 	- Вывод управления контрастом ( через потонциометр от 0 до 5 Вольт )
	4) RS 	- Выбор регистра ( команды или данные ) rs = 1 for data, rs=0 for command
	5) R/W 	- Чтение/запись ( режим записи при соединении с землей) если с дисплея нечего считывать не будем то соеденяем с землей
	6) E 	- Еnable (строб по спаду)
	7) DB0 	- линия данных  ( не используем в 4 битном режиме )
	8) DB1 	- линия данных  ( не используем в 4 битном режиме ) 
	9) DB2 	- линия данных  ( не используем в 4 битном режиме )
	10) DB3 - линия данных  ( не используем в 4 битном режиме )
	11) DB4 - линия данных	(используем в 4 битном режиме )
	12) DB5 - линия данных  (используем в 4 битном режиме )
	13) DB6 - линия данных  (используем в 4 битном режиме )
	14) DB7 - линия данных  (используем в 4 битном режиме )
	15) A	- плюс подсветки ( +5 вольт либо шим )
	16) K 	- минус подсветки
	
	Сам же дисплей может работать в двух режимах :
	• 8-битный режим - для этого используются и младшие и старшие биты (DB0- DB7)
	• 4-битный режим - для этого используются и только младшие биты (DB4- DB7)
	
	Использование 8-битного режима на данном дисплее не целесообразно. 
	Для его работы требуется на 4 ноги больше, а выигрыша в скорости практически нет 
	т.к. частота обновления данного дисплея упирается в предел < 10раз в секунду.
	//===============================================================================================
*/

		// выбираем через какой интефейс работает дисплей: --------------------------------------------------
		// ( нужное разкомментировать )
		//#define LCD1602_I2C			// режим I2C
		#define LCD1602_4BIT			// режим 4BIT
		//---------------------------------------------------------------------------------------------------
		
		
		#if defined (LCD1602_I2C)		// если выбран режим I2C ( то указываем адрес шины и какой I2C используем )--
		
			#define LCD_I2C					hi2c1
			#define ADRESS_I2C_LCD  		(0x3F << 1)	//  (0x27 << 1)  (0x3F << 1)
					
		#elif defined (LCD1602_4BIT)   // если выбран режим 4BIT ( то указываем пины куда подключили )--------------
		// при этом если их также назвали в CubeMX то указывать ненужно -------------------------------------
		
			// указываем пин ( Выбор регистра ( команды или данные ) )------------
			#ifndef RS_GPIO_Port
				#define RS_GPIO_Port   		DISP_RS_GPIO_Port
				#define RS_Pin				DISP_RS_Pin
			#endif
			//--------------------------------------------------------------------
			// указываем пин Еnable (строб по спаду) -----------------------------
			#ifndef E_GPIO_Port
				#define E_GPIO_Port   		DISP_E_GPIO_Port
				#define E_Pin				DISP_E_Pin
			#endif
			//--------------------------------------------------------------------
			// указываем пин DB4 - линия данных	(используем в 4 битном режиме )---
			#ifndef DB4_GPIO_Port
				#define DB4_GPIO_Port   	DISP_DB4_GPIO_Port
				#define DB4_Pin				DISP_DB4_Pin
			#endif
			//--------------------------------------------------------------------
			// указываем пин DB5 - линия данных	(используем в 4 битном режиме )---
			#ifndef DB5_GPIO_Port
				#define DB5_GPIO_Port   	DISP_DB5_GPIO_Port
				#define DB5_Pin				DISP_DB5_Pin
			#endif
			//--------------------------------------------------------------------
			// указываем пин DB6 - линия данных	(используем в 4 битном режиме )---
			#ifndef DB6_GPIO_Port
				#define DB6_GPIO_Port   	DISP_DB6_GPIO_Port
				#define DB6_Pin				DISP_DB6_Pin
			#endif
			//--------------------------------------------------------------------
			// указываем пин DB7 - линия данных	(используем в 4 битном режиме )---
			#ifndef DB7_GPIO_Port
				#define DB7_GPIO_Port   	DISP_DB7_GPIO_Port
				#define DB7_Pin				DISP_DB7_Pin
			#endif
			//--------------------------------------------------------------------
		#endif

		// если нужна кириллица то разкомментируем ( если кириллица не нужна то комментируем )---
		#define FONT_CYRILLIC
		//---------------------------------------------------------------------------------------
		
		
#ifdef __cplusplus
}
#endif

#endif	/*	_LCD1602_CONFIG_H */

/************************ (C) COPYRIGHT GKP *****END OF FILE****/
