RungeKut/thermocirculator/(commit log)

2024-06-01 add Project to STM32L072CBT6
2024-06-02 feat ADC
2024-06-12 adc complete
2024-06-16 adding programm
    [Расчет АЦП.xlsx]
2025-01-11 Завелся таймер
2025-05-25 Завелся RTC
2026-09-16 chore: исключить артефакты сборки и крупные инсталляторы из индекса
    Артефакты Keil (Objects/, Listings/, .axf, .crf, .dep, листинги линкера)
    и инсталляторы офлайн-комплекта не должны попадать в репозиторий.
    .uvoptx оставлен под контролем версий намеренно: в нём настройки
    отладчика и алгоритма прошивки, влияющие на воспроизводимость сборки.
2026-09-16 chore: добавить проект STM32L071CBT6 под контроль версий
    Проект существовал только в рабочем дереве и в git не попадал, хотя
    собирается в рабочую прошивку 26.90 КБ (armcc 5.06u7, январь 2026).
    Core/ — перегенерация CubeMX под L071; User/ и LCD1602/ совпадают с
    эталонным L072 побайтно, что и ожидается: это переносимый код.
    Прошивка собирается, но температуру не измеряет: при перегенерации
    потеряны каналы TEMPSENSOR и VREFINT, из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
2026-09-16 docs: документация проекта, правила работы и ТЗ на переработку
    Проект ведётся на трёх МК (STM32L072, STM32L071, GD32E103) и до сих пор
    существовал без документации: история портирования, обнаруженные тупики
    и устройство прошивки жили только в переписке.
    docs/01..08 — обзор, схемотехника, развёртывание окружения, сборка,
    архитектура прошивки, портирование, диагностика, правила работы.
    docs/09 — ТЗ на пере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
2026-09-16 chore: офлайн-комплект для развёртывания окружения
    Окружение сборки неработоспособно: отсутствует Arm Compiler 5, которого
    требуют оба ST-проекта, и не установлен ни один пакет поддержки устройств.
    Восстанавливать его по памяти каждый раз — источник простоев.
    tools/manifest.json фиксирует версии, размеры, sha256 и источники;
    tools/verify.py сверяет комплект и печатает, чего не хватает.
    Паки GigaDevice и даташиты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
2026-09-16 docs: закрыть вопрос по ШИМ кулера, проверено по даташитам
    Аппаратный ШИМ на выводе кулера PA8 есть только у GD32E103 (TIMER0_CH0).
    У STM32L071/L072 на PA8 выведены MCO, USB_CRS_SYNC, EVENTOUT, USART1_CK
    и I2C3_SCL — канала таймера нет.
    Решение для ST-таргетов: программный ШИМ около 100 Гц от свободного
    таймера по прерыванию (TIM2 занят звуком, свободны TIM6/7/21/22).
    Медленный программный ШИМ по образцу нагревателя не годится: вентиля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
2026-09-16 docs: починить таблицу открытых вопросов в правилах
    Предыдущий коммит разорвал таблицу пустой строкой при удалении
    закрытого вопроса.
2026-09-16 docs: закрыть оставшиеся вопросы по ТЗ
    Ф-06: автопауза становится отдельной настройкой. Порог готовности
    (сейчас константа 5 °C) задаётся в меню и может быть отключён;
    ограничение скорости нагрева работает независимо от него.
    Ф-04: номинал резистора делителя RA = 10 кОм подтверждён по схеме.
    Кнопки Stop/Left: авторитетны имена пинов в main.h, врут комментарии
    в обработчиках. Следствие — в текуще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
2026-09-16 L072: привести .ioc в соответствие с проверенным на железе SamplingTime
    В .ioc стояло ADC_SAMPLETIME_160CYCLES_5, в сгенерированном adc.c —
    ADC_SAMPLETIME_12CYCLES_5. Значение 12.5 такта подобрано измерениями на
    железе, а не в CubeMX, и правка лежала поверх сгенерированного кода вне
    блоков USER CODE: любая перегенерация её потеряла бы.
    Верным признано значение из кода, .ioc исправлен под него.
    [STM32L072CBT6.ioc]
2026-09-16 окружение: установить пакеты поддержки устройств
    Скачан и добавлен в комплект Keil.STM32L0xx_DFP 2.2.0 (62 МБ).
    Оба пакета установлены, после чего сборка L072 перестала жаловаться на
    неизвестное устройство и упирается только в отсутствие Arm Compiler 5,
    а проект GD32 дошёл до компиляции SPL.
    Две ловушки, стоившие времени, записаны в документацию:
    MDK 5.39 хранит пакеты в %LOCALAPPDATA%\Arm\Packs\, а не в
    C:\Keil_v5\ARM\PACK\ — ра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
2026-09-16 окружение: добавить STM32CubeMX 6.0.1, 6.2.0 и 6.4.0 в комплект
    Дистрибутивы трёх версий предоставлены владельцем проекта. Версии ставятся
    рядом, каждая в свой каталог C:\ST\STM32CubeMX_<версия>: проекты создавались
    разными версиями, а перегенерация чужой меняет Core/ сильнее, чем ожидается.
    tools/install-cubemx.ps1 ставит все три без единого диалога. Рядом с
    дистрибутивами лежат скрипты автоустановки IzPack auto-install-<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
2026-09-16 окружение: добавить JRE 8, без неё не запускается инсталлятор CubeMX
    Лаунчер инсталлятора STM32CubeMX ищет Java в реестре
    HKLM\SOFTWARE\JavaSoft\Java Runtime Environment и без неё показывает
    "This application requires a Java Runtime Environment 1.8.0_45 (64-bit)".
    Зарегистрированной Java на машине нет вообще: единственная JRE лежит внутри
    STM32CubeIDE и в реестре не значится, поэтому лаунчер её не видит.
    В комплект добавлен Eclipse Temurin JRE 8u504 x64 (MSI, 30 МБ).
    install-cubem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
2026-09-16 окружение: STM32CubeMX установлен, сценарии автоустановки заменены рабочими
    Мои сценарии IzPack были составлены по извлечённому списку панелей и не
    работали: инсталлятор прекращал работу без единого сообщения. Отличий два,
    и оба обязательны — у панели readme нужен атрибут id="readme", а панель
    ярлыков требует пяти дочерних элементов вместо пустого тега.
    Рабочие сценарии сняты с реальных устан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
2026-09-16 окружение: восстановить Arm Compiler 5, оба ST-проекта собираются
    Компилятор извлечён из дистрибутива Keil MDK 5.36 — последней версии,
    содержавшей Arm Compiler 5. Устанавливать 5.36 не потребовалось: её
    дистрибутив распаковывается 7-Zip как обычный архив, компилятор лежит
    внутри готовым каталогом ARM\ARMCC.
    Ключевой момент, который был неочевиден: одних файлов мало. MDK 5.39 не
    ищет AC5 самостоятельно, и пока в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
2026-09-17 L071: вернуть конфигурацию периферии, потерянную при перегенерации
    В .ioc возвращены 34 ключа, проект перегенерирован CubeMX 6.4.0 — той же
    версией, которой создан. Правки внесены в .ioc, а не в сгенерированный код:
    иначе следующая генерация потеряла бы их снова.
    Восстановлено:
    каналы TEMPSENSOR и VREFINT (VP_ADC_TempSens_Input, VP_ADC_Vref_Input)
    ClockPrescaler DIV2 -> DIV4
    SamplingTime 1.5 -> 12.5 такта
    EOCSelection SINGLE_CONV -> SEQ_CONV
    прерывание RTC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
2026-09-17 hardware: перенести исходники плат в репозиторий
    Проект плат жил в каталоге на рабочем столе и мог быть удалён вместе со
    схемой, разводкой и файлами для производства. Теперь он в репозитории —
    ссылка ПО на GitHub.url из самого проекта и так вела сюда.
    Две платы, соединённые шлейфом: система управления (СТЖ-1.ПУ.01.00.001) и
    панель управления (СТЖ-1.ПУ.02.00.001). AltiumWorkSpace.DsnWrk ссылается на
    оба проекта от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
    [blank_zakaza_plat_povtorno.xls, blank_zakaza_plat_povtorno.xlsx, База децимальных номеров.xlsx, Панель тцс.dxf, СТЖ-1-ПП-02-00-001-1.PcbDoc, СТЖ-1-ПУ-01-00-001 - Плата системы управления.PrjPcb, СТЖ-1-ПУ-01-00-001.SchDoc, СТЖ-1-ПУ-02-00-001 - Плата пульта управления.PrjPcb]
