RungeKut/thermocirculator/(notices)

Notices in the files:
STM32L072CBT6/Core/Src/main.c:
Copyright (c) 2024 STMicroelectronics.
All rights reserved.
This software is licensed under terms that can be found in the LICENSE file
STM32L071CBT6/Core/Inc/main.h:
Copyright (c) 2025 STMicroelectronics.
